duburcqa/jiminy/data/bipedal_robots/atlas/meshes/drc_extremities_diffuse.png

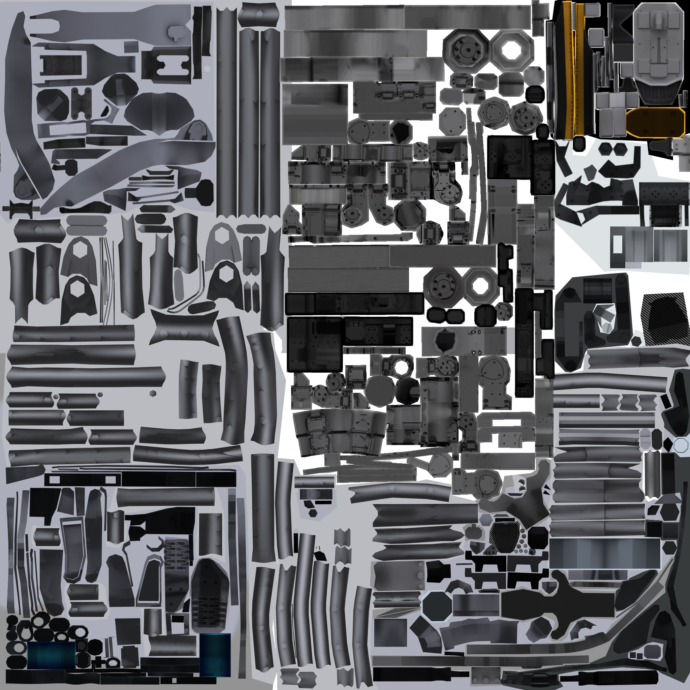
data/bipedal_robots/atlas/meshes/drc_extremities_diffuse.png
