duburcqa/jiminy/data/bipedal_robots/atlas/meshes/torso_diffuse_unplugged.png

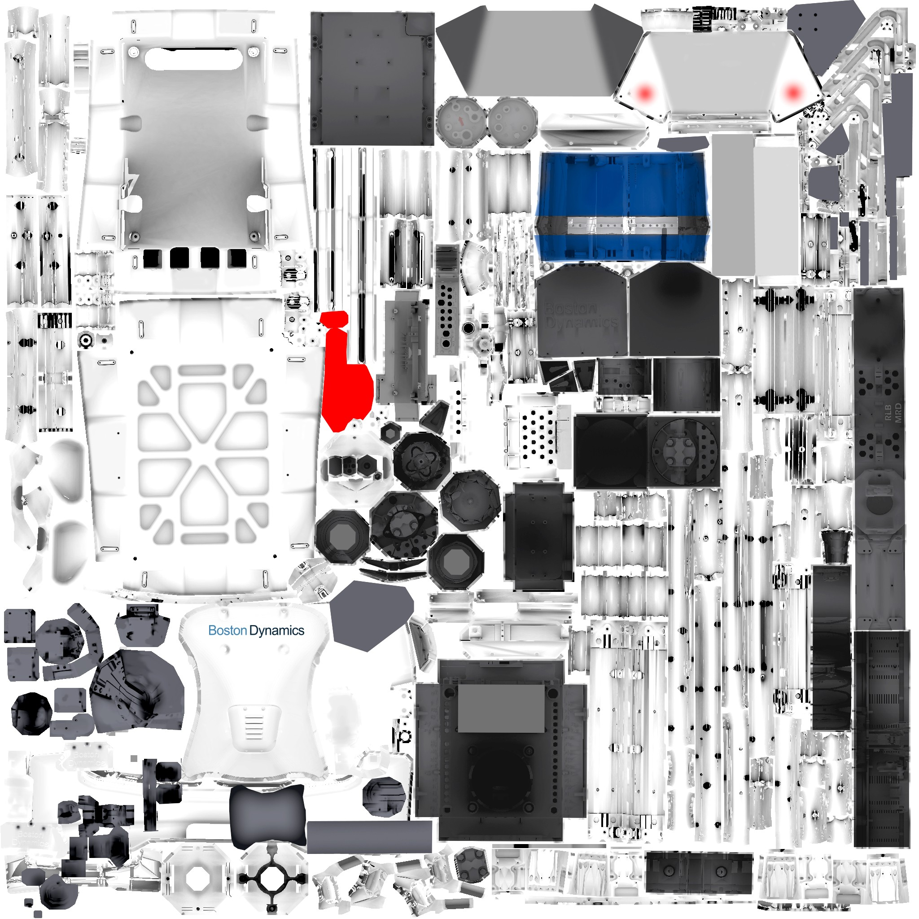
data/bipedal_robots/atlas/meshes/torso_diffuse_unplugged.png
