duburcqa/jiminy/README.md

<div align="center">
  
</div>

____












Jiminy is a cross-platform open-source simulator for poly-articulated systems. It was built with two ideas in mind:

- **provide a fast yet physically accurate simulator for robotics research.**

Jiminy is built around [Pinocchio](https://github.com/stack-of-tasks/pinocchio), an open-source fast and efficient kinematics and dynamics library. Jiminy thus uses minimal coordinates and Lagrangian dynamics to simulate an articulated system: this makes Jiminy as close as numerically possible to an analytical solution, without the risk of joint violation.

- **build an efficient and flexible platform for machine learning in robotics.**

Beside a strong focus on performance to answer machine learning's need for running computationally demanding distributed simulations, Jiminy offers convenience tools for learning via a dedicated module [Gym-Jiminy](#gym-jiminy). It is fully compliant with `gym` standard API and provides a highly customizable wrapper to interface any robotics system with state-of-the-art learning frameworks.

## Key features

### General

- Simulation of multi-body systems using **minimal coordinates and Lagrangian dynamics**.
- Comprehensive API for computing dynamic quantities and their derivatives thanks to Pinocchio.
- C++ core with full python bindings, providing user API parity between both languages.
- Designed with machine learning in mind, with seamless wrapping of robots as [OpenAI Gym](https://github.com/openai/gym) environments using one-liners. Jiminy provides both the physical engine and the robot model (including sensors) required for learning.
- **Fully modular learning environment pipeline design**, with plug-and-play robotic observers and controllers, but also composable reward components and termination conditions. See example [here](./python/gym_jiminy/unit_py/data/anymal_pipeline.toml).
- Rich simulation log output, easily customizable for recording, introspection and debugging. The simulation log is made available in RAM directly for fast access, and can be exported in binary or [HDF5](./docs/spec/src/tlmc_format_specification.md) format.
- Dedicated integration in Google Colab, Jupyter Lab, Mybinder and VSCode working out-of-the-box - including interactive 3D viewer based on [Meshcat](https://github.com/rdeits/MeshCat.jl). This facilitates working on remote environments.
- Synchronous and single-threaded offscreen rendering capability, GPU-accelerated without graphical server, based on [Panda3d](https://github.com/panda3d/panda3d).
- Easy to install: `pip` is all that is needed to [get you started](#getting-started) ! Support Linux, Mac and Windows platforms.

### Physics

- Provide both classical phenomenological force-level spring-damper contact model and constraint solver satisfying the maximum energy dissipation principle.
- Support contact and collision with the ground from a fixed set of contact points (primitives and meshes yet to come).
- Simulate multiple articulated systems simultaneously interacting with each other, to support use cases such as multi-agent learning or swarm robotics.
- Modeling of motor transmission backlash and structural deformation via compliant spherical joints with spring-damper dynamics, which are common phenomena, particularly in bipedal robotics.
- Simulate both continuous or discrete-time controller, with possibly different controller and sensor update frequencies.

A more complete list of features is available on the [wiki](https://github.com/duburcqa/jiminy/wiki).

**The documentation is available on [Github.io](https://duburcqa.github.io/jiminy/), or locally in `docs/html/index.html` if built from source.**

## Gym Jiminy

Gym Jiminy is an interface between Jiminy simulator and reinforcement learning frameworks. It is fully compliant with now standard [Open AI Gym](https://github.com/openai/gym) API. Additionally, it offers a generic and easily configurable learning environment for learning locomotion tasks, with minimal intervention from the user, who usually only needs to provide the robot's [URDF](https://wiki.ros.org/urdf) file. Furthermore, Gym Jiminy enables easy modification of many aspects of the simulation to provide richer exploration and ensure robust learning. This ranges from external perturbation forces to sensor noise and bias, including randomization of masses and inertias, ground friction model or even gravity itself. Note that learning can
easily be done on any high-level dynamics features, or restricted to mock sensor data for end-to-end learning.

Gym is cross-platform and compatible with most Reinforcement Learning frameworks implementing standard algorithms. For instance, [Stable Baselines 3](https://github.com/DLR-RM/stable-baselines3), [Tianshou](https://github.com/thu-ml/tianshou), or [Rllib](https://github.com/ray-project/ray). Stable Baselines 3 and Tianshou use its counterpart [Pytorch](https://pytorch.org/), and Rllib supports both. A few learning examples relying on those packages are also provided.

Pre-configured environments for some well-known toys models and reference robotics platforms are provided: [cartpole](https://www.gymlibrary.dev/environments/classic_control/cart_pole/), [acrobot](https://www.gymlibrary.dev/environments/classic_control/acrobot/), [pendulum](https://www.gymlibrary.dev/environments/classic_control/pendulum/), [Ant](https://www.gymlibrary.dev/environments/mujoco/ant/), [ANYmal](https://www.anymal-research.org/#getting-started), and [Cassie](https://www.agilityrobotics.com/robots#cassie), and [Atlas](https://www.bostondynamics.com/atlas).

## Demo

<a href="./python/jiminy_py/examples/tutorial.ipynb">
<p align="middle">
  
  
  
  
  
  
</p>
</a>

## Getting started

Jiminy and Gym Jiminy support Linux, Mac and Windows, and is compatible with Python3.10+. Pre-compiled binaries are distributed on PyPi. They can be installed using `pip>=20.3`:

```bash
# For installing Jiminy
python -m pip install --prefer-binary jiminy_py[meshcat,plot]

# For installing Gym Jiminy
python -m pip install --prefer-binary gym_jiminy[all]
```

Detailed installation instructions, including building from source, are available [here](./INSTALL.md).
