duburcqa/jiminy/docs/api/jiminy/index.rst

Jiminy C++ API
==============

.. toctree::
   :maxdepth: 1

   robot
   constraints
   sensors
   motors
   controller
   engine
   utilities
