duburcqa/jiminy/docs/api/jiminy/motors.rst

motors
======

.. doxygenclass:: jiminy::AbstractMotorBase
   :project: jiminy
   :members:
   :undoc-members:

.. doxygenclass:: jiminy::SimpleMotor
   :project: jiminy
   :members:
   :undoc-members:
