duburcqa/jiminy/docs/api/jiminy_py/core/engine.rst

engine
======

.. autoclass:: jiminy_py.core.ProfileForce
   :members:
   :undoc-members:
   :show-inheritance:

.. autoclass:: jiminy_py.core.ImpulseForce
   :members:
   :undoc-members:
   :show-inheritance:

.. autoclass:: jiminy_py.core.CouplingForce
   :members:
   :undoc-members:
   :show-inheritance:

.. autoclass:: jiminy_py.core.Engine
   :members:
   :undoc-members:
   :show-inheritance:

.. autoclass:: jiminy_py.core.StepperState
   :members:
   :undoc-members:
   :show-inheritance:

.. autoclass:: jiminy_py.core.RobotState
   :members:
   :undoc-members:
   :show-inheritance:
