duburcqa/jiminy/docs/api/jiminy_py/core/index.rst

core
====

.. toctree::
   :maxdepth: 1

   robot
   constraints
   sensors
   motors
   controller
   engine
   utilities
