duburcqa/jiminy/docs/api/jiminy_py/core/sensors.rst

sensors
=======

.. autoclass:: jiminy_py.core.AbstractSensor
   :members:
   :undoc-members:
   :show-inheritance:

.. autoclass:: jiminy_py.core.ImuSensor
   :members:
   :undoc-members:
   :show-inheritance:

.. autoclass:: jiminy_py.core.ContactSensor
   :members:
   :undoc-members:
   :show-inheritance:

.. autoclass:: jiminy_py.core.ForceSensor
   :members:
   :undoc-members:
   :show-inheritance:

.. autoclass:: jiminy_py.core.EncoderSensor
   :members:
   :undoc-members:
   :show-inheritance:

.. autoclass:: jiminy_py.core.EffortSensor
   :members:
   :undoc-members:
   :show-inheritance:

.. autoclass:: jiminy_py.core.SensorMeasurementTree
   :members:
   :undoc-members:
   :show-inheritance:
