duburcqa/jiminy/docs/api/jiminy_py/core/motors.rst

motors
======

.. autoclass:: jiminy_py.core.AbstractMotor
   :members:
   :undoc-members:
   :show-inheritance:

.. autoclass:: jiminy_py.core.SimpleMotor
   :members:
   :undoc-members:
   :show-inheritance:
