duburcqa/jiminy/docs/api/gym_jiminy/common/blocks/index.rst

Blocks
======

.. toctree::
   :maxdepth: 1

   proportional_derivative_controller
   motor_safety_limit
   mahony_filter
   body_orientation_observer
   deformation_estimator
   quantity_observer
