duburcqa/jiminy/docs/api/gym_jiminy/common/blocks/mahony_filter.rst

Mahony Filter
=============

.. automodule:: gym_jiminy.common.blocks.mahony_filter
   :members:
   :undoc-members:
   :show-inheritance:
