duburcqa/jiminy/docs/api/gym_jiminy/common/blocks/motor_safety_limit.rst

Motor Safety Limit
==================

.. automodule:: gym_jiminy.common.blocks.motor_safety_limit
   :members:
   :show-inheritance:
