duburcqa/jiminy/docs/api/gym_jiminy/common/wrappers/observation_filter.rst

Observation Filtering
=====================

.. automodule:: gym_jiminy.common.wrappers.observation_filter
   :members:
   :show-inheritance:
