duburcqa/jiminy/docs/api/gym_jiminy/common/wrappers/observation_stack.rst

Observation Frame Stacking
==========================

.. automodule:: gym_jiminy.common.wrappers.observation_stack
   :members:
   :show-inheritance:
