duburcqa/jiminy/docs/api/gym_jiminy/common/controllers/pid_controller.rst

PID Controller
==============

.. automodule:: gym_jiminy.common.controllers.pid_controller
   :members:
   :undoc-members:
   :private-members:
   :inherited-members:
   :show-inheritance:
