duburcqa/jiminy/docs/spec/pdf/note_on_flexibilty_model.pdf

## A note on the model used by Jiminy to simulate exibilities

Matthieu Vigne

25th March 2020

Jiminy supports the addition of joint exibilities to an otherwise rigid model, as well as rotor inertia. The goal of this document is to clarify how this is performed internally, and why this is justied.
The exible joint model supported by Jiminy consists of a simple spring damper. The corresponding system, displayed in Figure 1a, consists in placing, between a rotor of equivalent inertia J and the output body, of inertia I, a spring-damper of stiness k and damping ν. We call u the motor torque, and fext the external forces applied on the output body. Note that the gure is done on a prismatic joint for simplicity only: in practice, exibilites are rotations meant to be applied onto revolute axes - but the equations are the same between both systems.

Rotor
J

Body
I
x1 | x2
u | fext

Flexibility: k, ν

(a) Representation of a exible joint (prismatic): a spring-damper is placed between the rotor and the output body
Flexible mass
If

Body
I
x2 | x1

fext

Flexibility: k, ν | Prismatic joint, uo
(b) The system actually being simulated by Jiminy: an extra mass is added to attach the spring. uo is the torque at the output of the transmission, and is equal to u−Jx¨2.

Figure 1: A representation, for prismatic joints, of both systems under study.

However, such system cannot be easily represented in pinocchio: indeed, pinocchio implements rigid body dynamics as having a set of joints connecting rigid bodies: as such, it has no notion of transmission per se. The rotor does not correspond to a physical part of inertia J (the armature inertia, J, is computed for simple transmission by multiplying the real inertia by the square of the reduction ratio) - thus, rotor inertia is implemented in Jiminy by modifying the corresponding diagonal term of the generalized inertia matrix (note that this approach works for simple, 1DoF joints, but is not generic). As such, it is no

1

possible to add a degree of freedom to place the spring between the rotor and the output, as in the case in Figure 1a.
Instead, the exibility is placed before rotor of the exible joint being simulated. Since each joint must be connected to a body, this requires the addition of an extra body, connected to the exibility: this body has its own inertia, If . In practice we will want If close to zero, to avoid modifying the dynamical properties of the overall system. The resulting system is shown in Figure 1b We now need to show that both systems are indeed equivalent, when taking the limit If → 0. Consider the rst, SEA system: applying Newton's law of motion to the rotor, then the output body, yields:
(
Jx¨2 = u + kx1 + νx˙ 1
I(¨x1 + ¨x2) = −kx1 − νx˙ 1 + fext

(1)

which equivalently writes:
(
I(¨x1 + ¨x2) = −kx1 − νx˙ 1 + fext I(¨x1 + ¨x2) + Jx¨2 = u + fext

(2)

The system simulated by Jiminy writes in turn:
(
Ifx¨1 = −kx1 − νx˙ 1 − uo
I(¨x1 + ¨x2) = uo + fext

(3)

where uo is the torque at the output of the transmission. Applying Euler's law to the rotor gives us: Jx¨2 = u − uo. Thus, (3) rewrites:
(
Ifx¨1 = −kx1 − νx˙ 1 − (u − Jx¨2) I(¨x1 + ¨x2) = u − Jx¨2 + fext

(4)

add by adding both lines, we obtain:
(
(I + If )¨x1 + Ix¨2 = −kx1 − νx˙ 1 + fext I(¨x1 + ¨x2) + Jx¨2 = u + fext

(5)

Thus, from (2) and (5), it is now clear that both systems are equivalent when If << I. So while Jiminy does not exactly simulates a SEA as depicted in Figure 1a, it remains suciently close, in practice and for reasonable values of the output inertia I, to this system.

2
