duburcqa/jiminy/data/bipedal_robots/atlas/meshes/drc_torso_head_diffuse.png

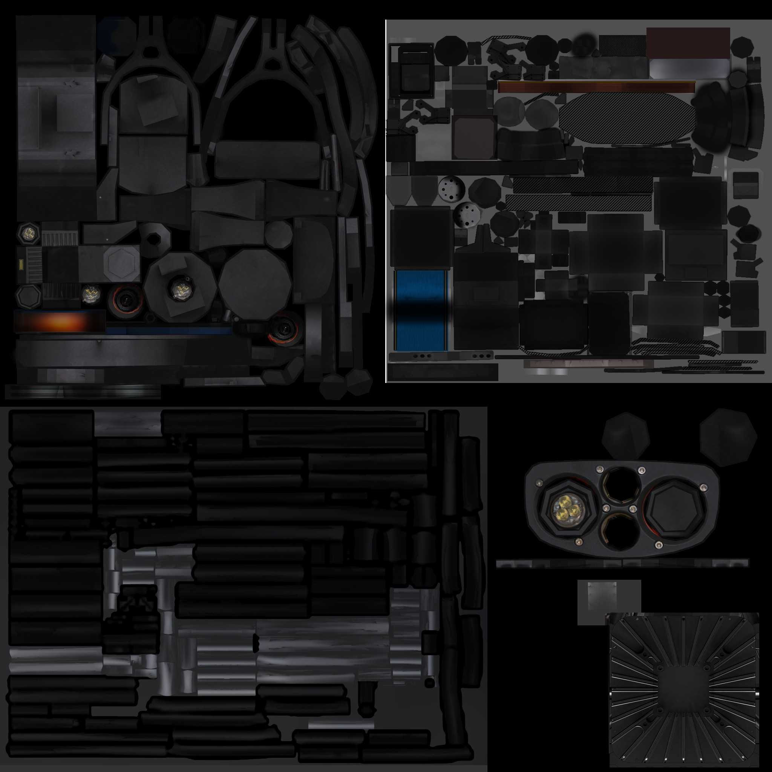
data/bipedal_robots/atlas/meshes/drc_torso_head_diffuse.png
