duburcqa/jiminy/data/bipedal_robots/atlas/meshes/extremities_diffuse_unplugged.png

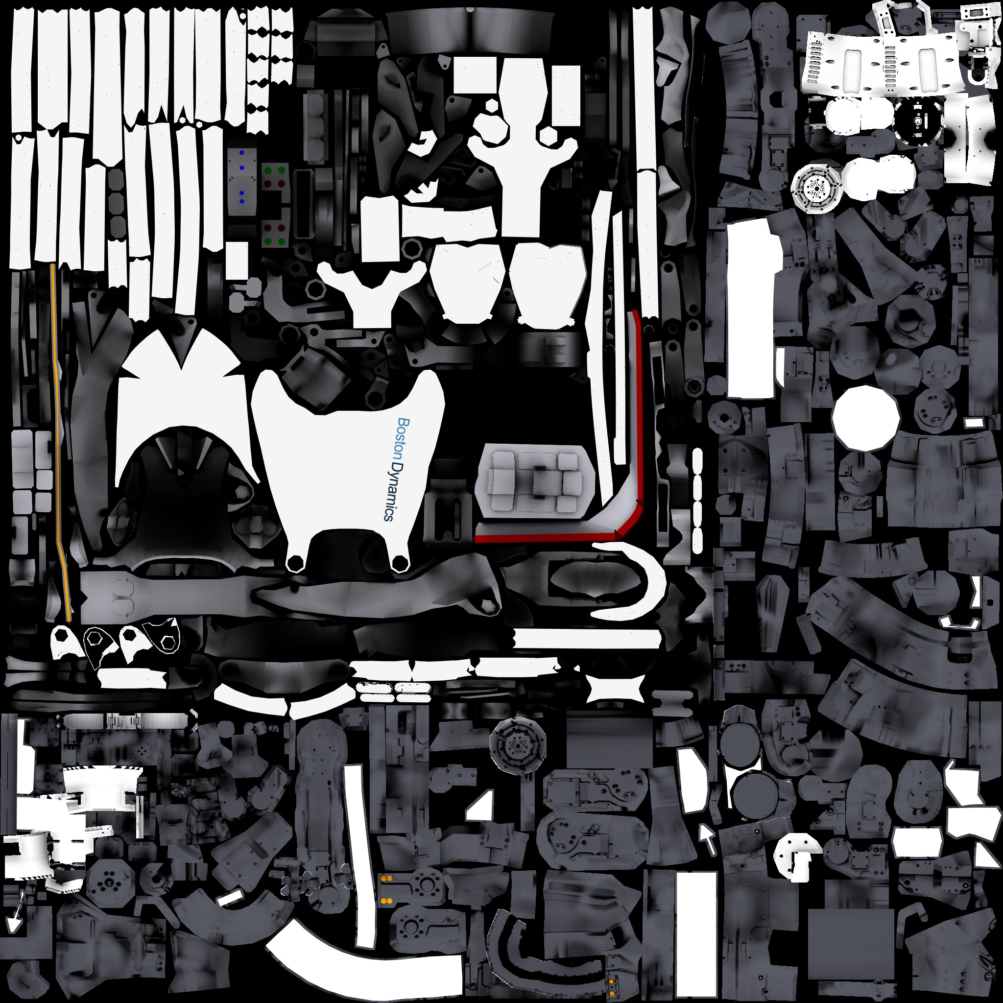
data/bipedal_robots/atlas/meshes/extremities_diffuse_unplugged.png
