duburcqa/jiminy/data/bipedal_robots/atlas/meshes/right_leg_diffuse_unplugged.png

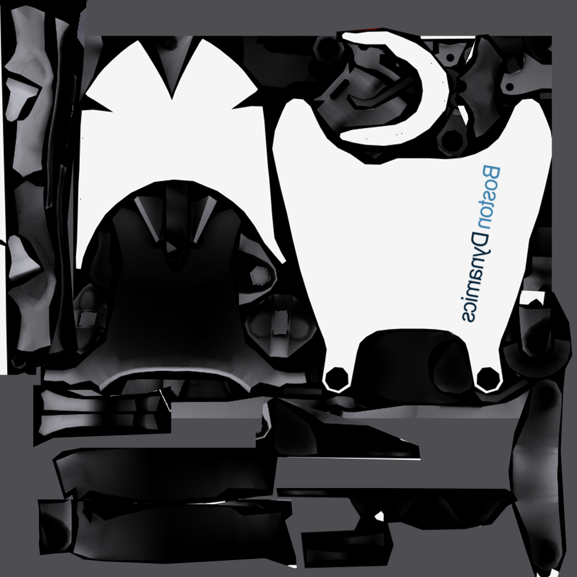
data/bipedal_robots/atlas/meshes/right_leg_diffuse_unplugged.png
