duburcqa/jiminy/data/bipedal_robots/atlas/meshes/torso_diffuse.png

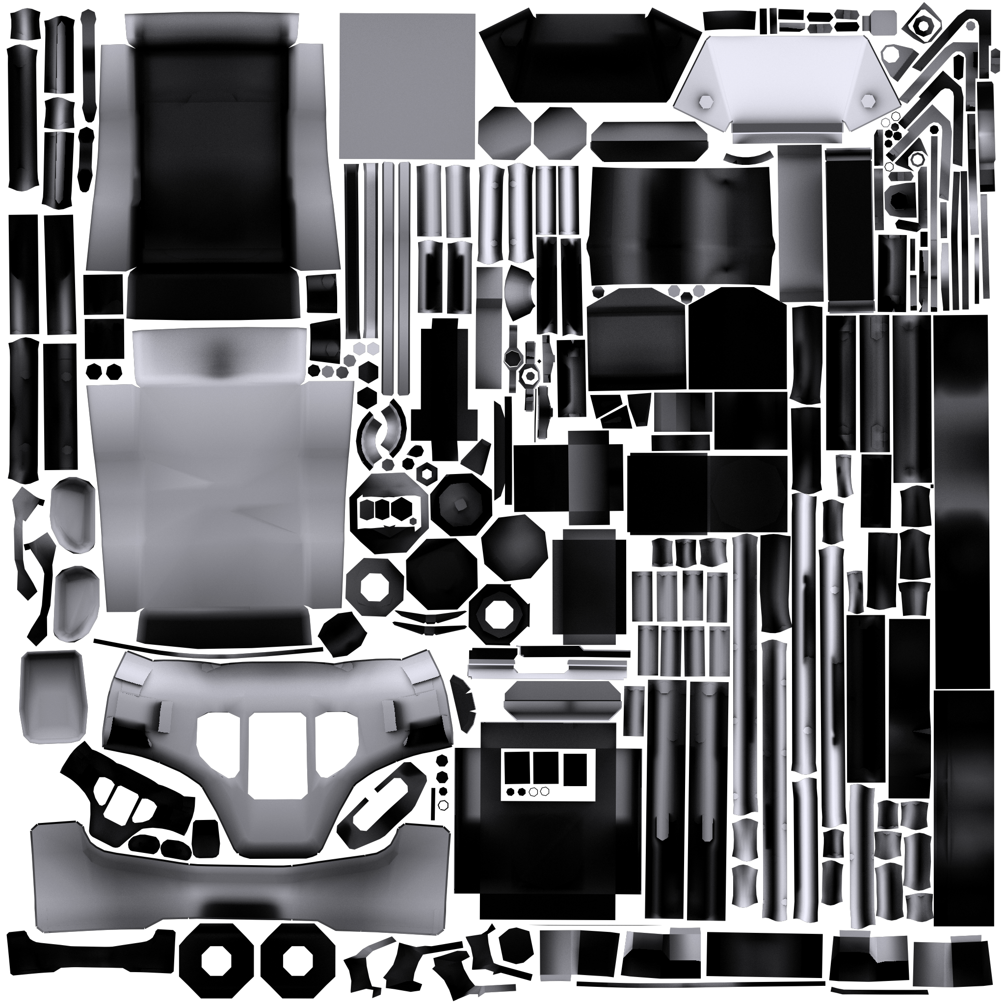
data/bipedal_robots/atlas/meshes/torso_diffuse.png
