duburcqa/jiminy/python/gym_jiminy/unit_py/data/atlas_standing_0.png

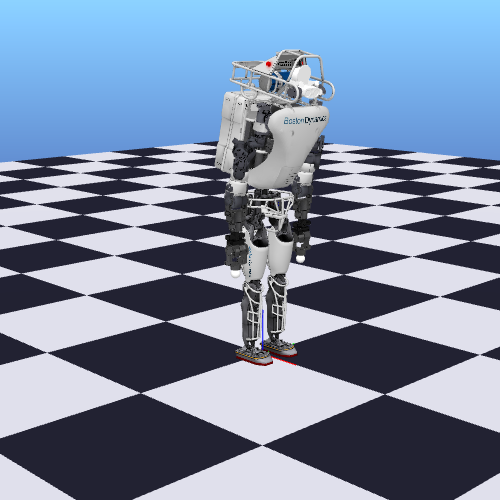
python/gym_jiminy/unit_py/data/atlas_standing_0.png
