duburcqa/jiminy/python/gym_jiminy/unit_py/data/atlas_standing_1.png

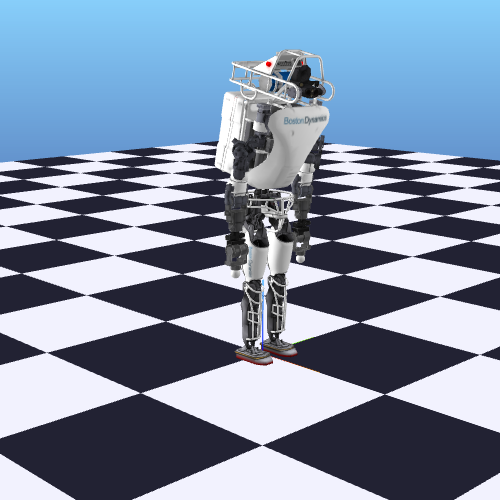
python/gym_jiminy/unit_py/data/atlas_standing_1.png
