duburcqa/jiminy/python/gym_jiminy/unit_py/data/cassie_standing_0.png

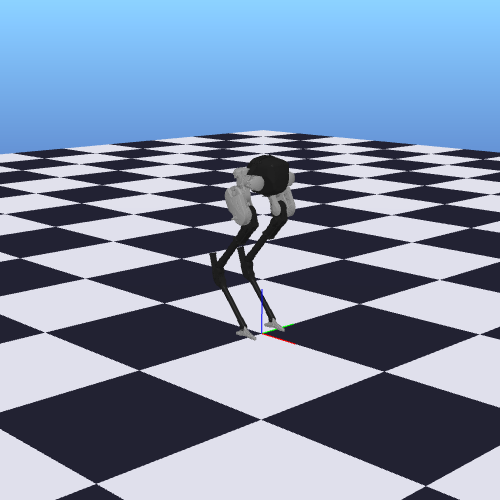
python/gym_jiminy/unit_py/data/cassie_standing_0.png
