duburcqa/jiminy/python/gym_jiminy/unit_py/data/digit_standing_0.png

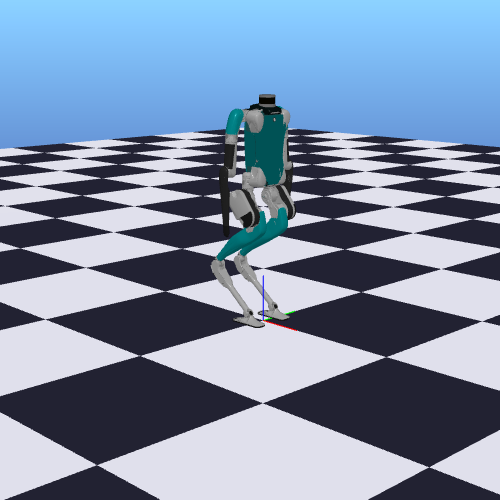
python/gym_jiminy/unit_py/data/digit_standing_0.png
