duburcqa/jiminy/data/bipedal_robots/cassie/meshes/toe.stl

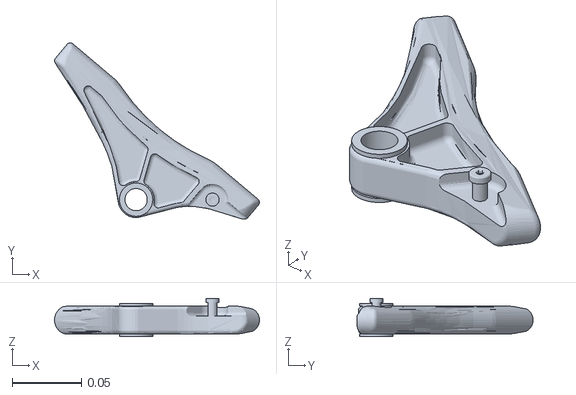
[picture p13: CAD file, 2021-03-16]
data/bipedal_robots/cassie/meshes/toe.stl
0.148 x 0.127 x 0.0277
