duburcqa/jiminy/data/bipedal_robots/digit/meshes/shin.obj

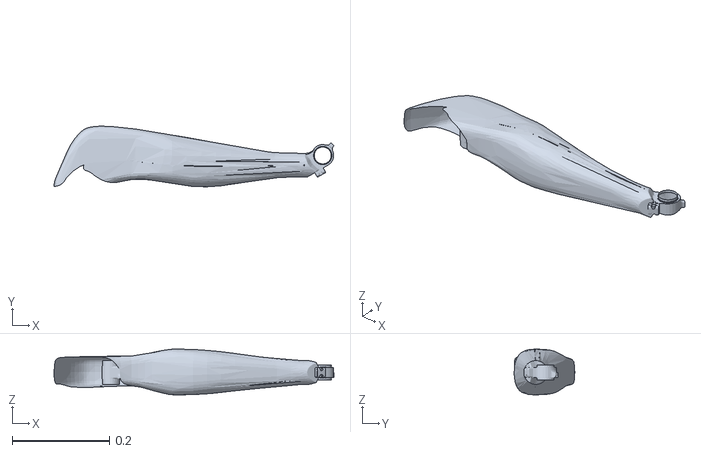
[picture p14: CAD file, 2024-01-02]
data/bipedal_robots/digit/meshes/shin.obj
0.575 x 0.125 x 0.0939
