duburcqa/jiminy/python/jiminy_py/unit_py/data/box.STL

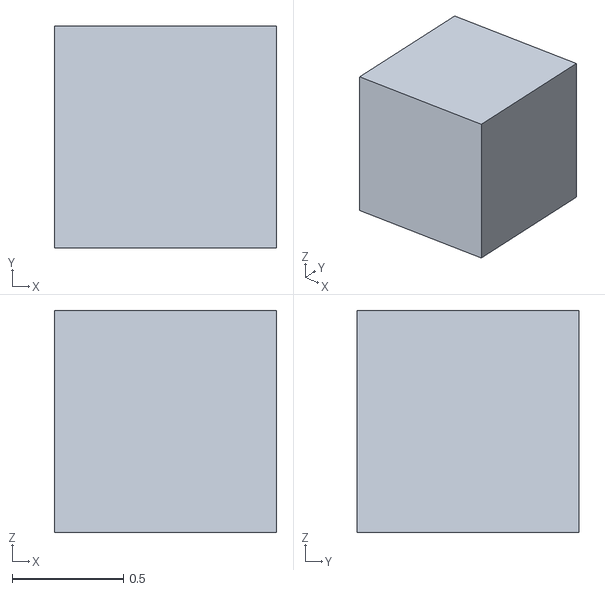
[picture p15: CAD file, 2020-10-11]
python/jiminy_py/unit_py/data/box.STL
1.00 x 1.00 x 1.00
