duburcqa/jiminy/data/bipedal_robots/cassie/meshes/tarsus_mirror.stl

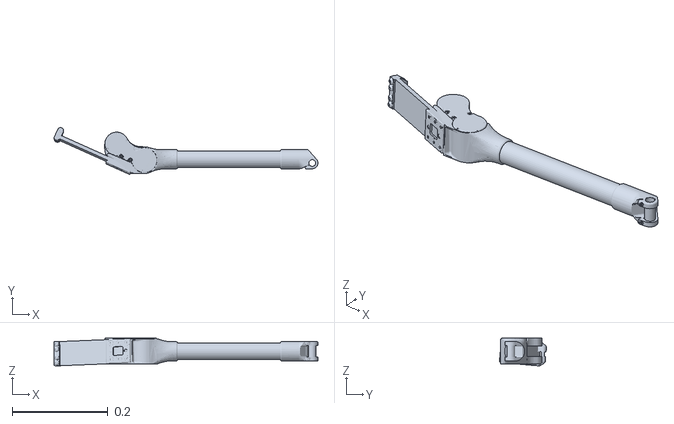
[picture p16: CAD file, 2021-03-16]
data/bipedal_robots/cassie/meshes/tarsus_mirror.stl
0.551 x 0.098 x 0.0581
