duburcqa/jiminy/data/bipedal_robots/digit/meshes/hip-pitch-housing.obj

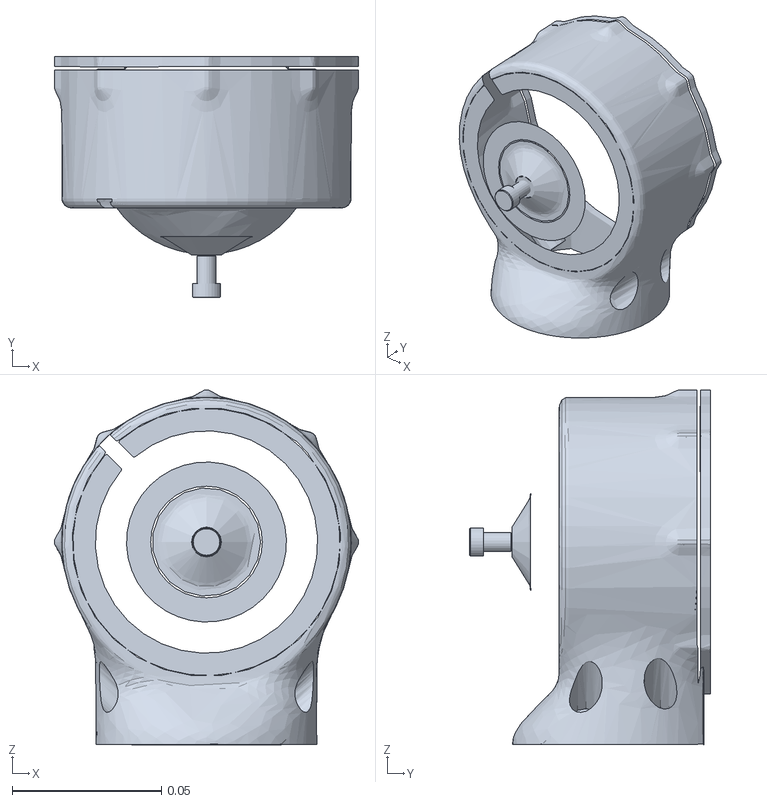
[picture p17: CAD file, 2024-01-02]
data/bipedal_robots/digit/meshes/hip-pitch-housing.obj
0.102 x 0.0808 x 0.119
