duburcqa/jiminy/data/bipedal_robots/cassie/meshes/thigh.stl

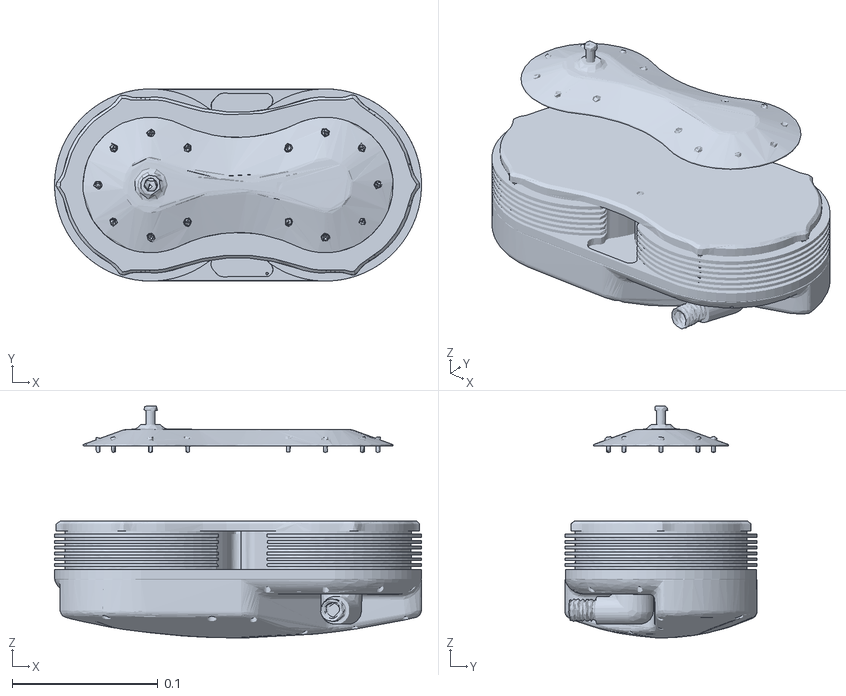
[picture p18: CAD file, 2021-03-16]
data/bipedal_robots/cassie/meshes/thigh.stl
0.252 x 0.132 x 0.159
