duburcqa/jiminy/data/bipedal_robots/digit/meshes/arm-L1.obj

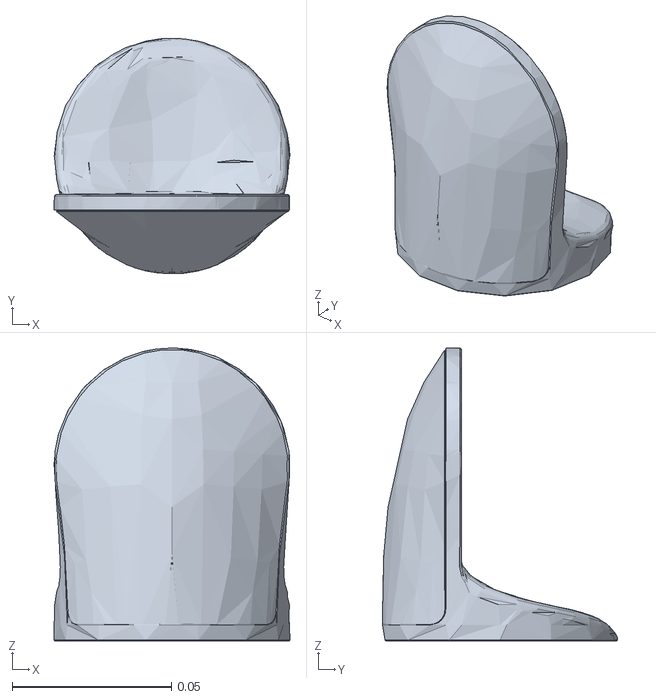
[picture p19: CAD file, 2024-01-02]
data/bipedal_robots/digit/meshes/arm-L1.obj
0.074 x 0.0739 x 0.092
