duburcqa/jiminy/data/bipedal_robots/cassie/meshes/pelvis.stl

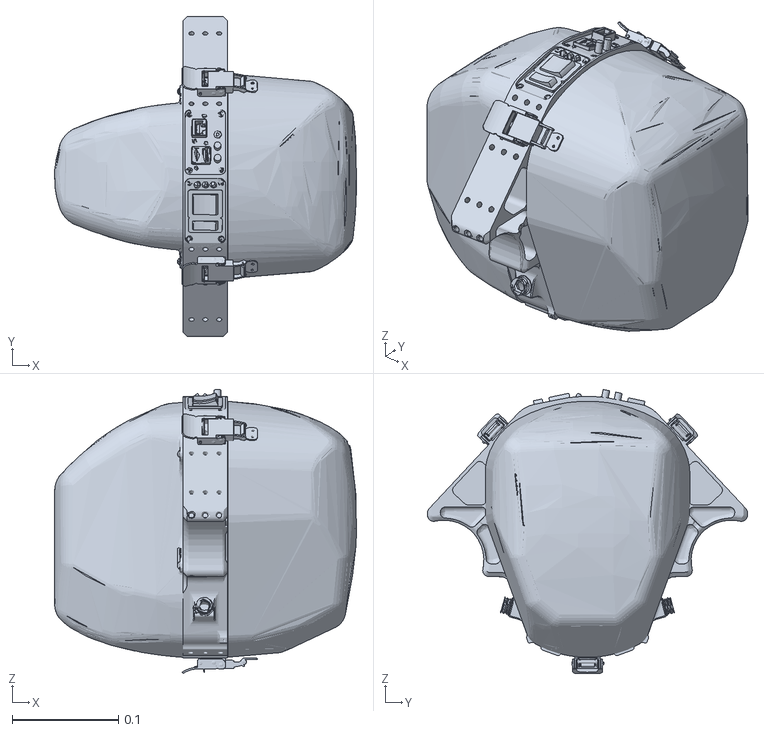
[picture p20: CAD file, 2021-03-16]
data/bipedal_robots/cassie/meshes/pelvis.stl
0.284 x 0.301 x 0.267
