duburcqa/jiminy/data/bipedal_robots/digit/meshes/torso.obj

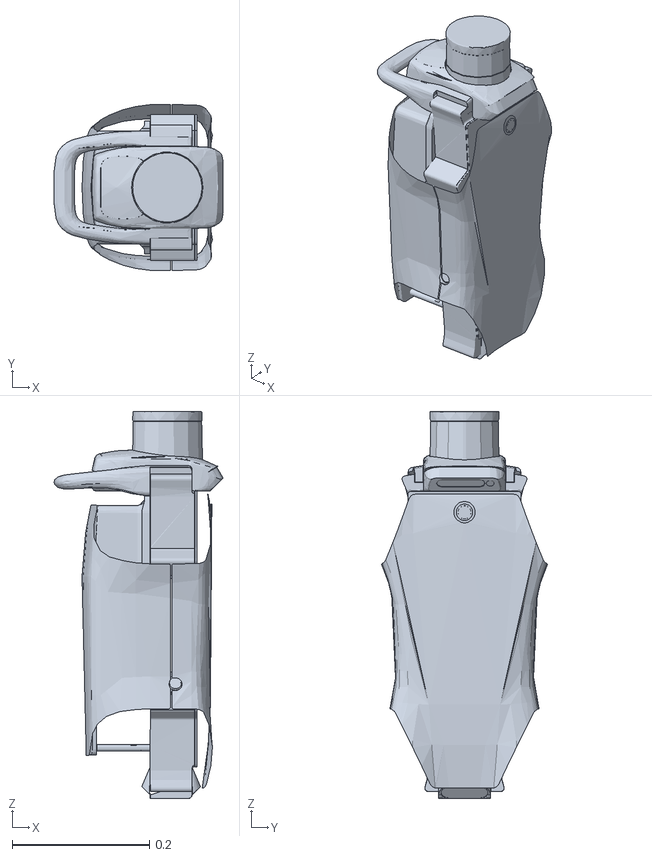
[picture p21: CAD file, 2024-01-02]
data/bipedal_robots/digit/meshes/torso.obj
0.246 x 0.242 x 0.564
