duburcqa/jiminy/data/bipedal_robots/cassie/meshes/hip.stl

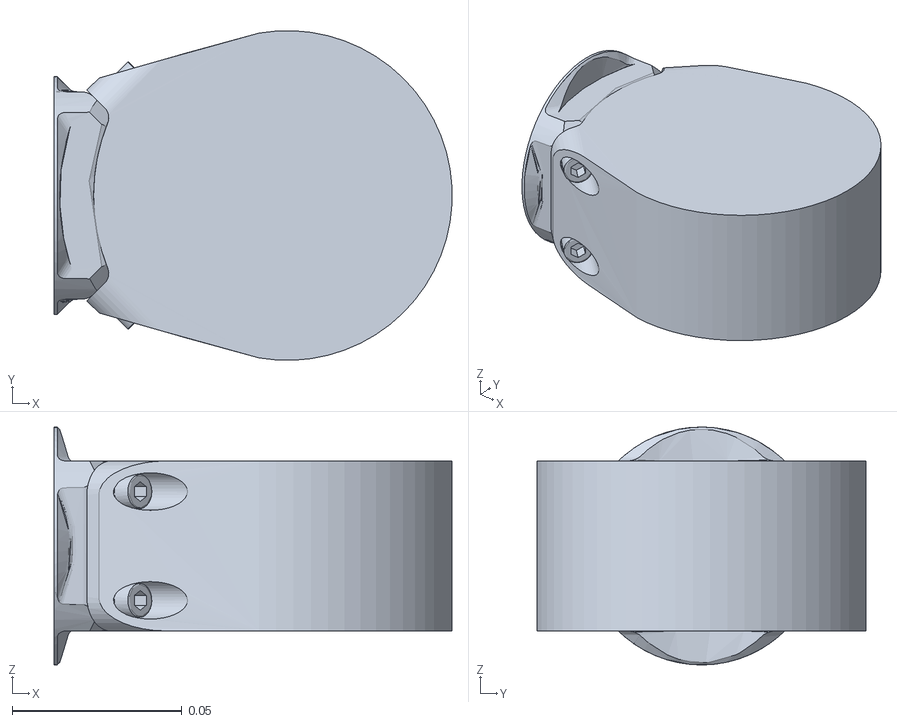
[picture p22: CAD file, 2021-03-16]
data/bipedal_robots/cassie/meshes/hip.stl
0.117 x 0.0969 x 0.07
