duburcqa/jiminy/data/bipedal_robots/digit/meshes/arm-L4.obj

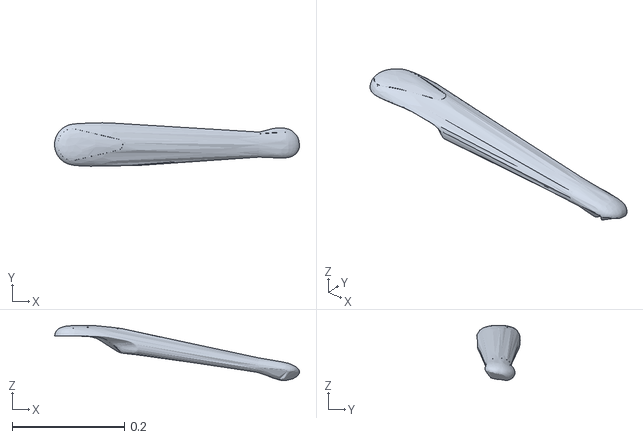
[picture p23: CAD file, 2024-01-02]
data/bipedal_robots/digit/meshes/arm-L4.obj
0.437 x 0.0776 x 0.0983
