duburcqa/jiminy/data/bipedal_robots/cassie/meshes/plantar-rod.stl

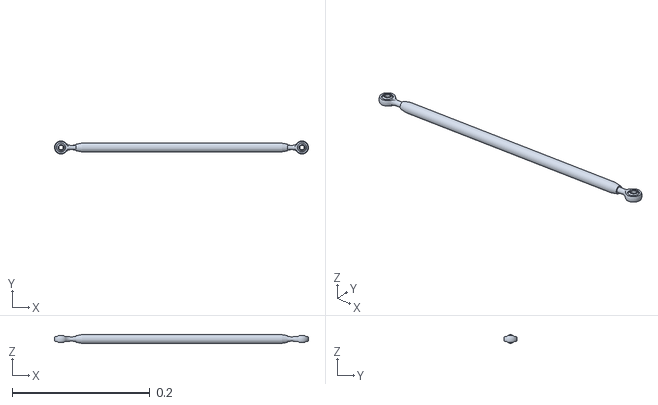
[picture p24: CAD file, 2021-03-16]
data/bipedal_robots/cassie/meshes/plantar-rod.stl
0.369 x 0.019 x 0.0127
