duburcqa/jiminy/data/bipedal_robots/digit/meshes/arm-L3.obj

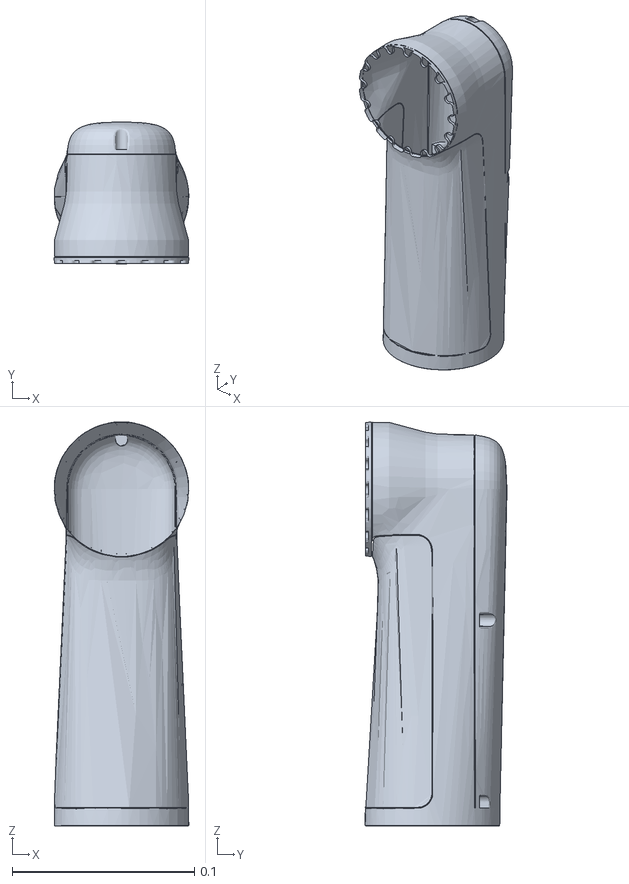
[picture p25: CAD file, 2024-01-02]
data/bipedal_robots/digit/meshes/arm-L3.obj
0.074 x 0.078 x 0.222
