duburcqa/jiminy/data/bipedal_robots/digit/meshes/arm-L2.obj

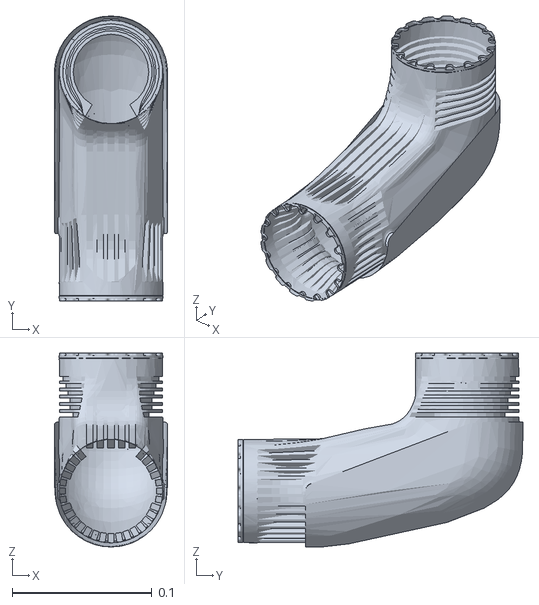
[picture p26: CAD file, 2024-01-02]
data/bipedal_robots/digit/meshes/arm-L2.obj
0.0808 x 0.204 x 0.139
