duburcqa/jiminy/data/bipedal_robots/digit/meshes/hip-pitch.obj

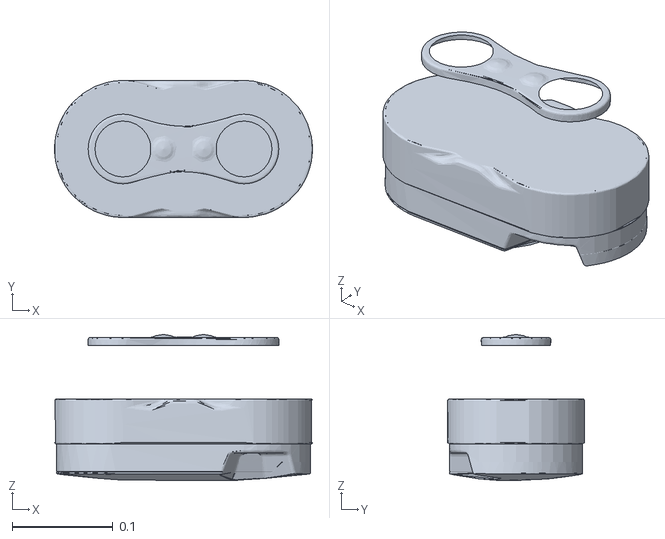
[picture p27: CAD file, 2024-01-02]
data/bipedal_robots/digit/meshes/hip-pitch.obj
0.256 x 0.136 x 0.145
