duburcqa/jiminy/data/bipedal_robots/cassie/meshes/achilles-rod.stl

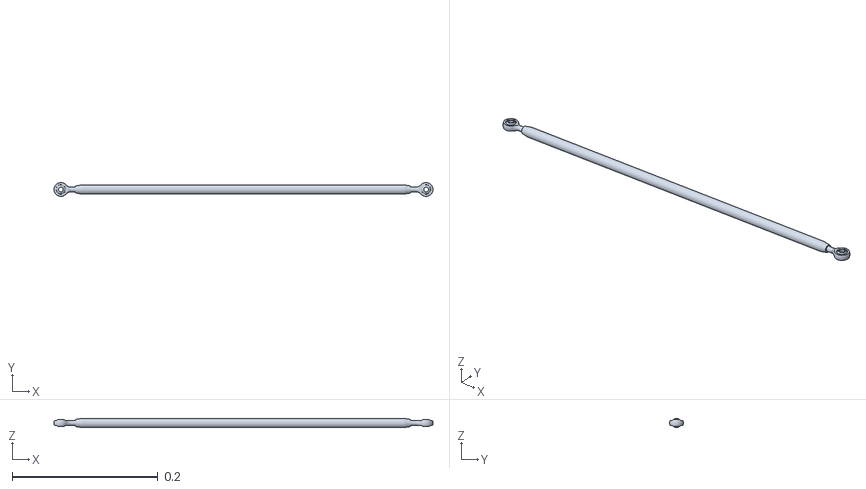
[picture p28: CAD file, 2021-03-16]
data/bipedal_robots/cassie/meshes/achilles-rod.stl
0.52 x 0.019 x 0.0127
