duburcqa/jiminy/data/bipedal_robots/digit/meshes/knee.obj

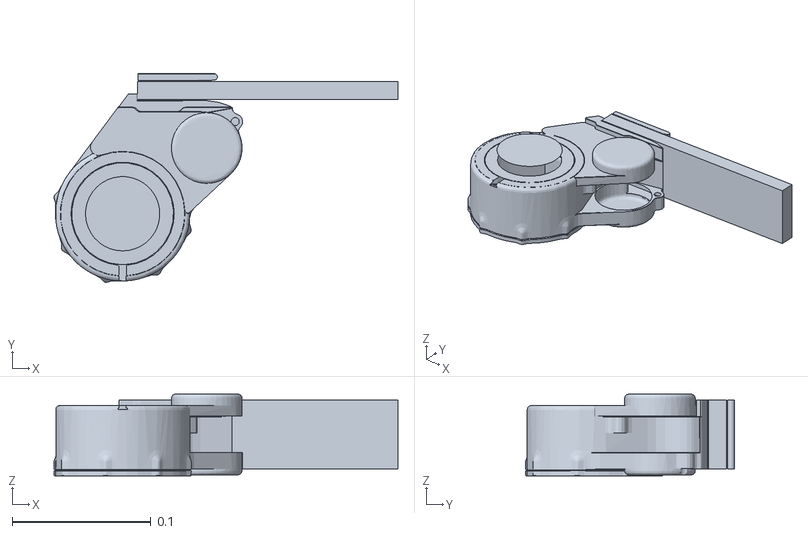
[picture p29: CAD file, 2024-01-02]
data/bipedal_robots/digit/meshes/knee.obj
0.248 x 0.151 x 0.0603
