duburcqa/jiminy/data/bipedal_robots/cassie/meshes/knee-output_mirror.stl

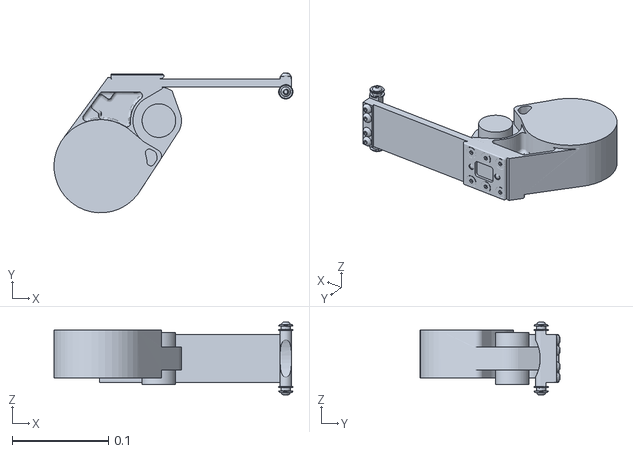
[picture p30: CAD file, 2021-03-16]
data/bipedal_robots/cassie/meshes/knee-output_mirror.stl
0.249 x 0.145 x 0.0756
