duburcqa/jiminy/data/bipedal_robots/digit/meshes/tarsus.obj

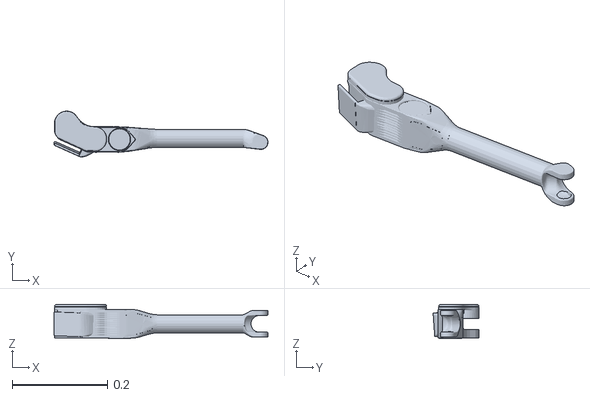
[picture p31: CAD file, 2024-01-02]
data/bipedal_robots/digit/meshes/tarsus.obj
0.45 x 0.0963 x 0.0716
