duburcqa/jiminy/data/bipedal_robots/cassie/meshes/shin-bone.stl

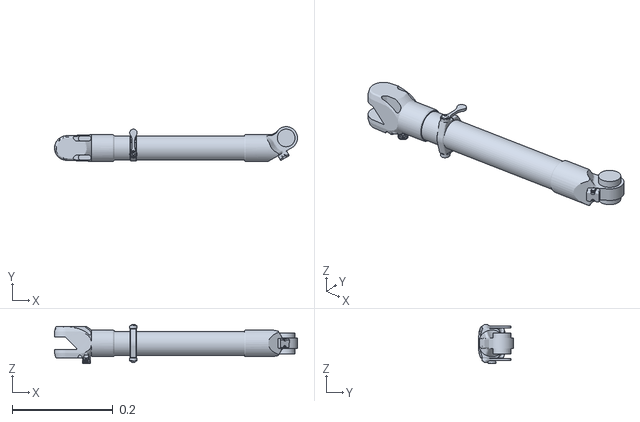
[picture p32: CAD file, 2021-03-16]
data/bipedal_robots/cassie/meshes/shin-bone.stl
0.482 x 0.069 x 0.0782
