duburcqa/jiminy/data/bipedal_robots/digit/meshes/toe-roll.obj

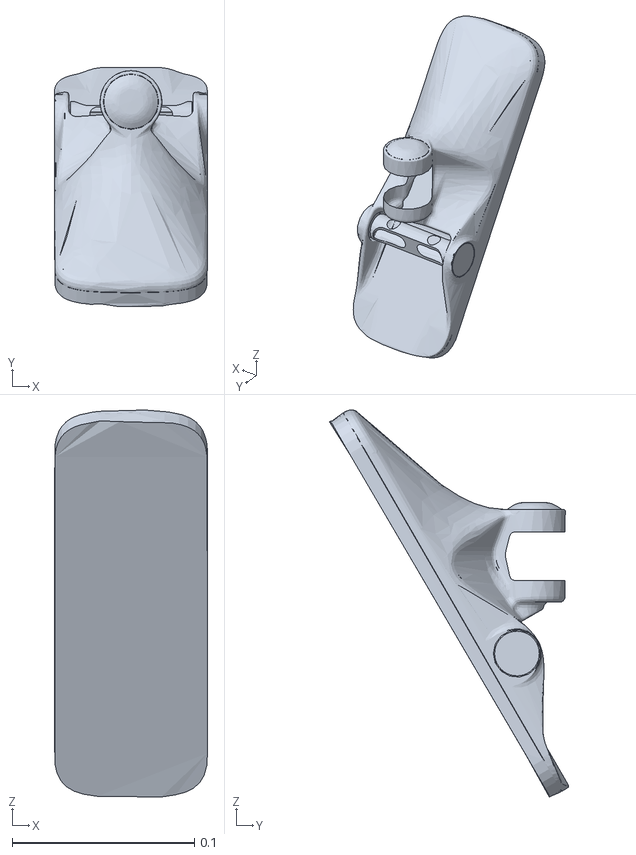
[picture p33: CAD file, 2024-01-02]
data/bipedal_robots/digit/meshes/toe-roll.obj
0.084 x 0.131 x 0.212
