duburcqa/jiminy/data/bipedal_robots/digit/meshes/hip-yaw-housing.obj

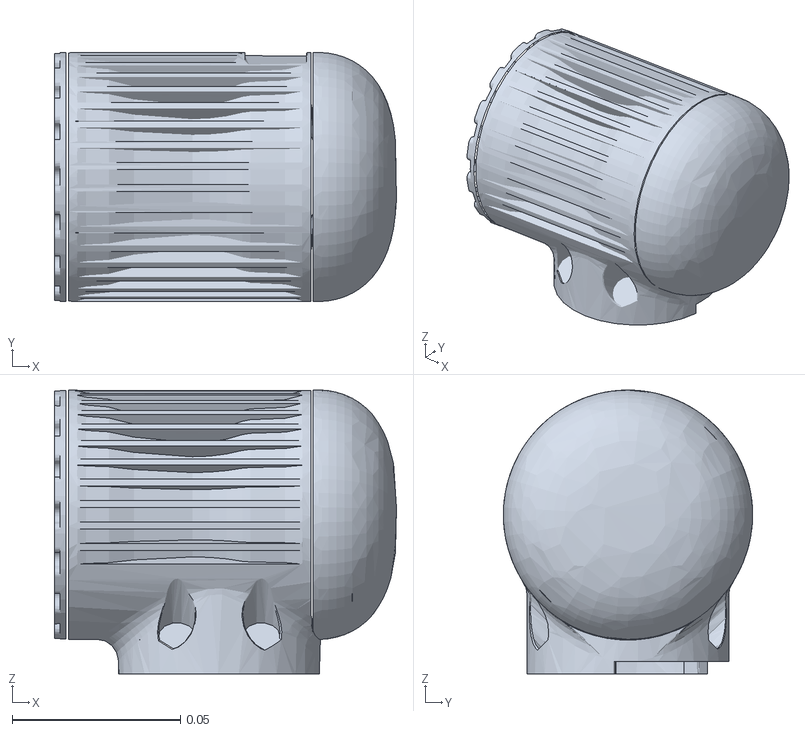
[picture p34: CAD file, 2024-01-02]
data/bipedal_robots/digit/meshes/hip-yaw-housing.obj
0.101 x 0.074 x 0.0842
