duburcqa/jiminy/data/bipedal_robots/cassie/meshes/abduction_mirror.stl

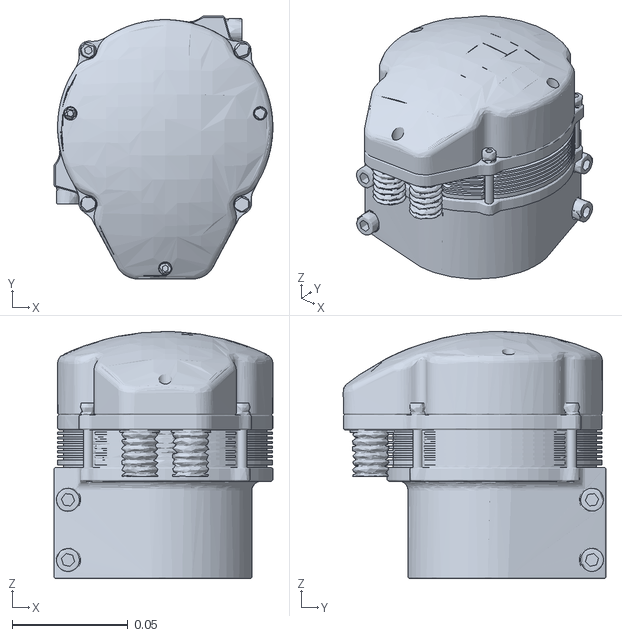
[picture p35: CAD file, 2021-03-16]
data/bipedal_robots/cassie/meshes/abduction_mirror.stl
0.0945 x 0.113 x 0.107
