duburcqa/jiminy/data/bipedal_robots/digit/meshes/toe-pitch.obj

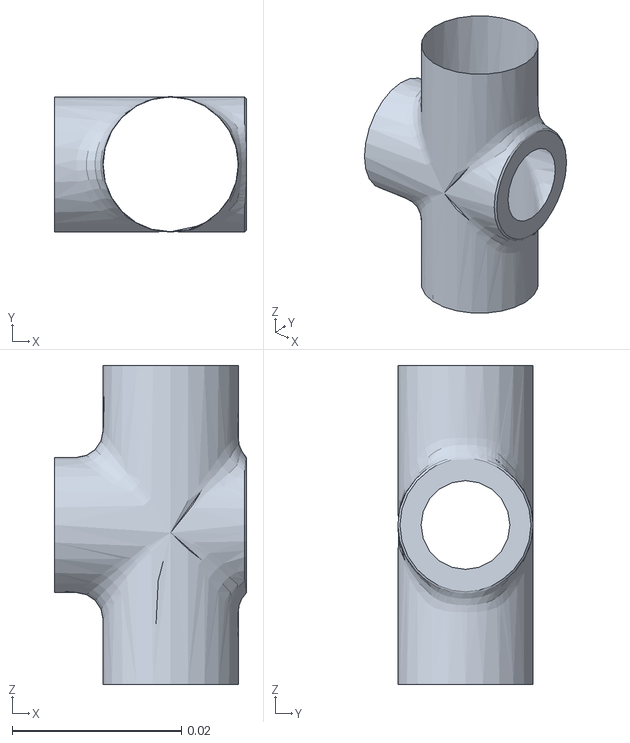
[picture p36: CAD file, 2024-01-02]
data/bipedal_robots/digit/meshes/toe-pitch.obj
0.0227 x 0.016 x 0.0377
