duburcqa/jiminy/data/bipedal_robots/digit/meshes/hip-roll-housing.obj

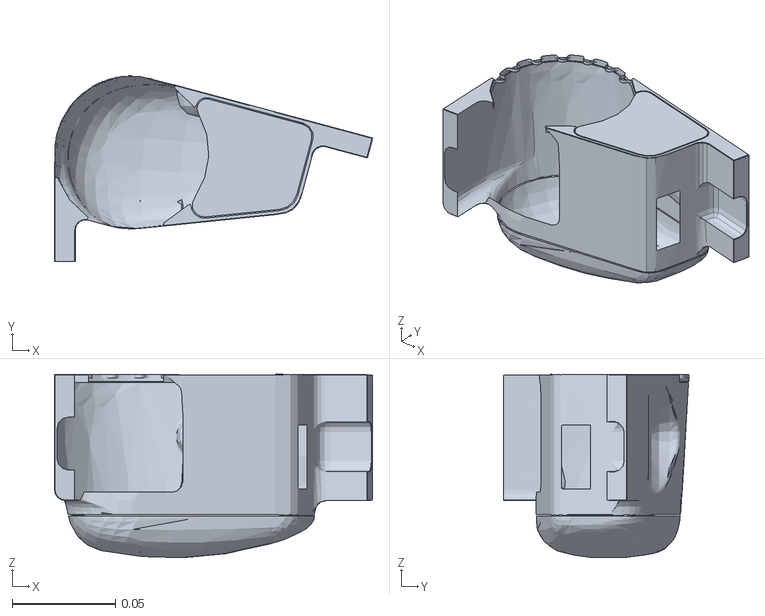
[picture p37: CAD file, 2024-01-02]
data/bipedal_robots/digit/meshes/hip-roll-housing.obj
0.154 x 0.09 x 0.0887
