duburcqa/jiminy/data/bipedal_robots/cassie/meshes/yaw.stl

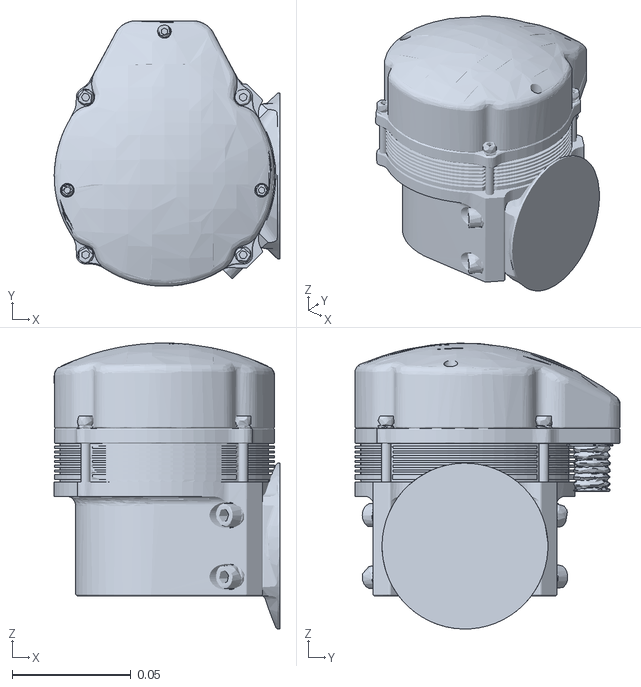
[picture p38: CAD file, 2021-03-16]
data/bipedal_robots/cassie/meshes/yaw.stl
0.0952 x 0.112 x 0.121
