duburcqa/jiminy/data/bipedal_robots/cassie/meshes/toe-output-crank.stl

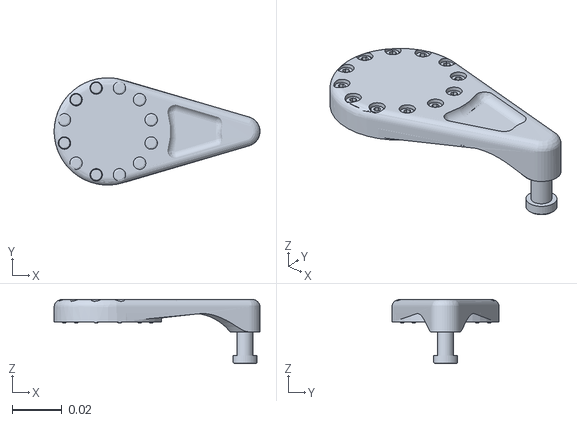
[picture p39: CAD file, 2021-03-16]
data/bipedal_robots/cassie/meshes/toe-output-crank.stl
0.0825 x 0.0431 x 0.0257
