duburcqa/jiminy/(list of files, cad)

Other CAD files:
data/bipedal_robots/cassie/meshes/toe_mirror.stl
data/bipedal_robots/cassie/meshes/tarsus.stl
data/bipedal_robots/cassie/meshes/knee-output.stl
data/bipedal_robots/cassie/meshes/abduction.stl
data/bipedal_robots/digit/meshes/shoulder-roll-housing.obj
data/bipedal_robots/cassie/meshes/shin-bone_mirror.stl
data/bipedal_robots/cassie/meshes/hip_mirror.stl
data/bipedal_robots/cassie/meshes/yaw_mirror.stl
data/bipedal_robots/cassie/meshes/thigh_mirror.stl
