duburcqa/jiminy/(threads)

Thread 35 (2020-03-02):

Add more realistic sensors

duburcqa, 2020-03-02:
So far, only continuous joint position sensors, 3D force sensors, and Quat/Gyro/Accelo IMUs in world frame are available. It would be useful to have 1D force sensors (z-axis only), Gyzo/Accelero IMUs in robot frame, joint torque sensors, and discrete joint position sensors (returning int64).

Thread 36 (2020-03-02):

[core] Implement perfect rigid impact model

duburcqa, 2020-03-02:
Currently, the contact force is modelled using a spring-dumper mechanism. Using infinite stiffness without dumping for the ground reaction force should, **in theory**, replicate a perfectly rigid impact model. However, it would increase dramatically the stiffness of the ode, which in turn would be impossible to integrate using a decent step size. On the contrary, taking advantage of the discrete dynamics tools should do the job pretty well in Pinocchio (`impulseDynamics` and `forwardDynamics` under constraints).

Thread 37 (2020-03-02):

Undocumented API

duburcqa, 2020-03-02:
Python native code is properly documented, but it is not the case for the C++ API and the Python bindings (which are using the same documentation in most cases). It is really important at least the method and class that the user is intended to use in practice.

duburcqa, 2020-03-02:
Also, add a wiki page about the physics, especially about the contact model.

Thread 40 (2020-03-02):

Deploy package for Windows on Pypi

duburcqa, 2020-03-02:
The package available on Pypi for windows should bundle every required dynamic libraries, namely Eigen3, Eigenpy, Boost (only the few required components), Urdfdom, and Pinocchio, since it is quite difficult to install them for Windows so far.

duburcqa, 2020-04-18:
Fixed!

Closed 2020-04-18.

Thread 44 (2020-03-05):

Add dedicated motor class

duburcqa, 2020-03-05:
Currently, the motors are part of `Model` itself. This implementation has major flaws:
- It is inconsistent with the sensors, which are dedicated objects.
- The engine has to manage the options of all the motors at the same time. The size of some option parameters associated with the motors depends on the number of motors, therefore user-defined values must be disable whenever a motor is added. This unexpected behaviour is very disturbing for the user. Moreover, adding motor options requires to implement a custom `Model` class.
- It does not allow to use advanced motor model, for example using a realistic voltage/current-torque dynamics, or gears with backslash. It also enable to instantiate a motor without a model. It could be useful for example to assess their own dynamics, which is possible in the real world.

The idea would be to implement something similar to the sensor: all motors must share a common interface that would be specified by an abstract class. The motors would be part of the input of the command functor called by the engine.

duburcqa, 2020-03-05:
ping @matthieuvigne

duburcqa, 2020-03-06:
This is related to the issue https://github.com/Wandercraft/jiminy/issues/42. Having a dedicated interface for the motors would enable to implement a custom internal dynamics for them.

Closed 2020-03-11.

Thread 50 (2020-03-12):

[core] Automatically log the URDF and options

duburcqa, 2020-03-12:
Currently, the log file only contains data. As a result, it is impossible to replay the simulation or to compute some dynamical quantities using only a log file.

It would be great to log the URDF and options as string constants directly in the header of the log file (it may requires to not assume that the header is not split in multiple chunks while reading it).

duburcqa, 2020-12-16:
Fixed by https://github.com/Wandercraft/jiminy/pull/251

Closed 2020-12-16.

Thread 56 (2020-03-19):

Simulate force interactions between frames belonging to two separate models.

aelkhour, 2020-03-19:
One application which I find interesting for jiminy would be the ability to simulate more finely interactions between an robot exoskeleton and the person wearing it.

Currently jiminy can only simulate a pair of model (kinematic tree) and controller. I wonder whether it could be extended to handle multiple models along with force interactions between the model respective frames. This would bring jiminy closer to being able to run simulations on a kinematic graph rather than a simple kinematic tree (see for instance gazebo which can handle graphs).

Closed 2020-04-02.

Thread 63 (2020-03-26):

Reduce tolerance of unit tests

duburcqa, 2020-03-26:
Currently, the tolerance for the unit tests on the CI is pretty high. It is possible to be more accurate on my personal machine but I don't understand why exactly the UT are failing on the CI if I use the same tolerance. I need to reduce the accuracy on the CI by at least 2 order of magnitude. I would be great to understand such discrepancy.

duburcqa, 2020-03-26:
ping @matthieuvigne

Closed 2020-03-26.

Thread 66 (2020-03-29):

Add support for kinematic constaints.

matthieuvigne, 2020-03-29:
I wish to simulate a segway-like system: basically, a wheel turning on the ground. This cannot be exactly simulated in Jiminy, which only supports punctual contacts with an elastic ground: the 'hack' one could do would be to place many points along the rim of the wheel, and set them all as contact points.

Rather, I want to simulate the contact as an analytical constraint: i.e. the wheel is in perfect contact with the ground and does not slip. This can be done by adding the constraint in the dynamics equation as Lagrange multipliers.

Note that I'm only interested in having a constant contact throughout the simulation: I do not mean to implement 'analytical contact' for a walking robot, that would require an added contact detection framework. What I have in mind is a constant contact throughout the simulation. However, this is already a significant first step in that direction if we ever want to do that.

This is how I see the implementation:

 -  at a 'low-level', contact kinematics is implemented in ```pinocchio``` as ```pinocchio::forwardDynamics(..., J, drift)``` where J is the jacobian of the constraint, and drift the associated drift. This implementation of ```pinocchio::forwardDynamics``` would replace the aba algorithm in ```Engine.computeSystemDynamics```. In practice, ```pinocchio::forwardDynamics``` is likely to be much slower than aba (because it requires computing the inertia matrix, angument it with the jacobian, and do the inverse), thus aba would remain the default option, and Engine would switch to using forwardDynamics only if a contact constraint is being used.

 - like we did in ```aba```, we will need a custom implementation of ```forwardDynamics``` to support armature inertia.

 - While I do not need this for my use case, supporting several constraints at once seems a nice feature to have. I think the best way to handle this from the API standpoint is to give a name to each constraint, so adding and removing contact constraints would be like adding and removing sensors or motors.
 - As API, to simulate a contact analytical we need a jacobian, with signature ```matrixN_t jacobian(q)```, and the corresponding drift term with signature ```vectorN_t drif(q, v)```. The main usage would probably be to have a specific frame in contact, however, for a wheel, I want the wheel rim to be in contact, not a fixed point. This requries a 'custom' jacobian to be implemented. So I'm thinking about having two ways to define a constaint: by a simple frame name, or by a callback function.

In the end, here is an overall architecture of what I plan to do:

 - Define signatures for jacobian and drift callback functions:
```c++
typedef matrixN_t (*JacobianFct_t) (model, data, q);
typedef vectorN_t (*DriftFct_t) (model, data, q, v);
```
 - Add class representing the contact:

```c++
class ContactConstraint:
    ContactConstraint(std::string contactFrameName);
    ContactConstraint(JacobianFct_t J, DriftFct_t drift);
```

- Add add/remove methods to robot, like add / remove of motors, sensors, contact frames... work:
    - ```Robot::setContactConstraint(std::string name, ContactConstraint)```

The engine would then switch between both implements of the dynamics depending of the presence of not of ContactContraint. Note that both contact are not mutually exclusive: you could imagine having both intermitent, elastic contacts, and constant constraints (for instance, fix you robot foot on the ground analytically, then make its hand hit a wall).

Closed 2020-04-08.

Thread 77 (2020-04-12):

Improve Jiminy notebook tutorial

duburcqa, 2020-04-12:
There are many other things we could add to this tutorial:
- Adding constants / new variables to a log - doesn't make much sense on a simple pendulum, but would on a more complex system.
- Adding sensors, changing the simulation configuration.
- A multi-robot simulation with interesting coupling

...

Thread 95 (2020-04-29):

Add unit  tests for jiminy_py dynamics helpers

duburcqa, 2020-04-29:
Some methods in this module are rather complex and it would be nice to validate way. It is pretty "easy" to do it. Running first a simulation, extracting only the motor position/velocity/acceleration, and trying the recover the missing data.

duburcqa, 2020-11-25:
Part of the code is now partially tested though `gym_jiminy` unit tests, but it is clearly not enough, considering that now about 40% of the whole code base is pure Python.

Thread 121 (2020-05-28):

Isolating pip build for Pinocchio

jcarpent, 2020-05-28:
Dear @duburcqa,

I was wondering how does it cost to isolate the pip build for Pinocchio from your current setup? I think it might be useful to do it, in order to let external users rely on Pinocchio using pip.

Thanks in advance for your help,

Justin

duburcqa, 2020-05-28:
Hi @jcarpent,

Not much, but what do you whant to do exactly ? I could deploy Pinocchio and Eigenpy as standalone packages on pip by myself, but I assume you would prefer to do it yourself ? In any case it is pretty straightforward, one just have to copy-paste `.github` folder and remove the part associated with Jiminy (after one or two minor changes).

jcarpent, 2020-05-28:
I would like to also distribute Pinocchio and EigenPy on pypy as independent packages. You've already done a great job for this support.
I would really appreciate if you can provide the skeleton, and I can ensure the rest with your support. We can imagine to host it in the stack of tasks organization if you agree and I will add you as a member.

Is it fine?

duburcqa, 2020-05-28:
I'm pretty busy right now, but it sounds like a deal. I could add github CI doing the job directly on Pinocchio and Eigenpy repositories. It should be doable in a few hours.

jcarpent, 2020-05-28:
OK. Very nice, please proceed when you have time.
By the way, I'm trying to setup a CI for Windows using Conda, and I was wondering which compiler are you using to compile Pinocchio?

duburcqa, 2020-05-28:
I'm using Visual Studio 2019, you could have a look to this file <https://github.com/Wandercraft/jiminy/blob/master/.github/workflows/win.yml>.
Why do you want to use Conda? It is not necessary at all to build pinocchio on Windows.

jcarpent, 2020-05-28:
For installing the whole bunch of dependencies. On my side here (https://github.com/stack-of-tasks/pinocchio/blob/d921a23c99f03f3e8fba901030949dca2c0f8aa7/.github/workflows/windows-conda.yml), CMake is not able to find the compiler ClangCl, while everyone works fine on a local machine. In your case, you use `v142`. It is not working when I'm trying to compiile Pinocchio. Do you know why?

duburcqa, 2020-05-29:
Installing the dependencies without conda shouldn't be a big deal. Why to use `ClangCl` instead of `v142` on Windows ? I guess you have issues because there is spaces in your path `%programfiles(x86)%\Microsoft Visual Studio\2019\Enterprise\VC\Tools\clang++.exe`. You should get rid of them, by using the infamous windows alternative short path name. In this case, you could replace `\Microsoft Visual Studio\` by `\MICROS~1\` (6 first charatecters in uppercase, follow by ~N, N is a unique ID to distinguish folders starting with the same 6 characters.)

jcarpent, 2020-05-29:
The v142 is failing on my side dramatically. It is not able to disambiguate template signatures with Eigen objects.
In the meantime, I’ve fixed the issue which was due to cmake.

For the CI, one needs Fast feedback to get feedback on the current errors. It will be very long to wait hours for compiling dependencies while Pinocchio already has many. I would say, this is a usual and good practices to only considering the compilation of one’s projects.

Closed 2020-10-13.

Thread 217 (2020-10-25):

[core] Random terrain generation

duburcqa, 2020-10-25:
It would be nice to be able to compute the collision with a analytical ground function `f(x,y) -> (z, normal)`, and to display it in the viewer. It is not straightforward to do so because computing the collision with a very large non-convex mesh is time-consuming. After some benchmark, just replacing the halfspace ground by a mesh increases the overall computation time by a factor x10 (which means that computing the collision is probably x1000 slower...).

duburcqa, 2021-10-08:
PR #410 fixes this issue partially. It adds the support of rendering of ground profile to panda3d viewer, along with random ground collision for contact points using impulse contact model (this was already supported by spring damper contact model).

What is still missing is proper collision detection for collision geometries instead of contact points. But the scope of this issue is not limited to random terrain generation.

Closed 2021-10-10.

Thread 252 (2020-12-16):

[python] Restore robot state from log for replay and more.

duburcqa, 2020-12-16:
```
import json

import pinocchio as pin

import jiminy_py.core as jiminy
from jiminy_py.log import read_log

log_data, constants = read_log(log_fullpath)

robot = jiminy.Robot()
robot.initialize(constants['HighLevelController.urdf_path'],
                 bool(int(constants['HighLevelController.has_freeflyer'])),
                 constants['HighLevelController.mesh_package_dirs'].split())
pin.Model.loadFromString(robot.pinocchio_model, constants['HighLevelController.pinocchio_model'])

# Use the hardware description file to restore the sensors/controller

# Restoring the options will fail, since the hardware and controller is missing
all_options = json.loads(constants['HighLevelController.options'])
robot.set_options(all_options['system']['robot'])
```

duburcqa, 2020-12-16:
Generating a hardware description file in C++ based on a Jiminy.Robot object is missing.

duburcqa, 2021-05-03:
Related to #337.

Closed 2021-05-03.

Thread 255 (2020-12-17):

[viewer] Add a mechanism to define and update extra primitives.

duburcqa, 2020-12-17:
For instance, it would be great to display the CoM (center of mass) and the CoP (center of pressure) using fixed-size sphere primitives, or contact forces using dynamic-size capsules.  This information requires knowledge about the dynamics of the system, which is not the case for the viewer itself. It would be harmful to introduce such dependency in the viewer itself, so it makes sense to enable to user to register a callback function that will be called automatically during video replay. Using the same mechanism than for camera motion should do the job pretty well.

duburcqa, 2020-12-17:
Related to https://github.com/Wandercraft/jiminy/issues/259

duburcqa, 2021-04-13:
Fixed by https://github.com/duburcqa/jiminy/pull/319

Closed 2021-04-13.

Thread 259 (2020-12-17):

[python/viewer] Add backend-independent interface to add and update primitive geometries.

duburcqa, 2020-12-17:
Currently, it is possible to add hppfcl primitive geometries to both Meshcat and Geopetto-Gui, yet it is not possible to update there properties using the same principal. Moreover, their respective API to do so is quite bad. One way to get around this limitation would be to delete and create a new geometry systematically, but it is likely to perform poorly.

duburcqa, 2021-05-03:
Fixed by #340. Only Panda3D is supported for now.

Closed 2021-05-03.

Thread 275 (2021-01-31):

[core] Ensure no memory allocation when simulation is running.

duburcqa, 2021-01-31:
Eigen already offers some very handy functionalities to ensure no memory is allocated at runtime using:
```
#define EIGEN_RUNTIME_NO_MALLOC
Eigen::internal::set_is_malloc_allowed(false);
```

duburcqa, 2021-02-01:
Most time-consuming memory allocation issues have been fixed recently (https://github.com/Wandercraft/jiminy/pull/276 and https://github.com/Wandercraft/jiminy/pull/277). Yet, it would be much better to completely forbid memory allocation during simulation.

duburcqa, 2021-02-01:
After doing some testing using `set_is_malloc_allowed`, I can confirm that the current version is not allocating memory during a simulation.

Closed 2021-02-02.

Thread 282 (2021-02-07):

[python/viewer] Replay log data simulation reliably.

duburcqa, 2021-02-07:
For now, it is impossible to replay flexible simulation using rigid model. Ideally, once should create a new robot based on logged one, rather than alter the current one. Ideally, the viewer should deal the `Jiminy::Model` directly instead of `Jiminy::Robot`, so that it is straightfoward to implement a `copy` method, because otherwise it would requires to copy every sensors/motors and the controller, which may be hazardous. This could be done by implementing a `copyModel` method. Another way to deal with this issue should be to add `pinocchio_model/data_flexible`/`pinocchio_model/data_rigid` attribute to `Jiminy::Model`, but it does not guarantee that the flexibility model did not changed. Ultimately, a third solution would be to enable instantiating a `Jiminy::Model` from logged data (stream or file). It seems more reliable and requires minimal refactoring of the existing code base. So it is probably the way to go.

duburcqa, 2021-04-28:
> Ultimately, a third solution would be to enable instantiating a Jiminy::Model from logged data (stream or file). It seems more reliable and requires minimal refactoring of the existing code base. So it is probably the way to go.

This approach has been implemented by https://github.com/duburcqa/jiminy/pull/334.

Closed 2021-04-28.

Thread 285 (2021-03-03):

[core] External forces applied on the robot `fext` is wrong in case of equality constraints.

duburcqa, 2021-03-03:
`fext` is not updated based on the value of the lagrangian multipliers of the problems for user-specified constraints.

Thread 299 (2021-03-18):

Original tutorial seems to be not working.

ashsrobbins, 2021-03-18:
Running the original tutorial .ipynb, there seem to be issues I couldn't solve. First,
```AbstractController' object has no attribute 'set_controller_handle```
Commenting out the line trying to set the handle causes the next problem:
```TypeError: run() missing 1 required positional argument: 'v0'```
Adding a v0 variable which mimics x0 finally results in one last error:

```RuntimeError                              Traceback (most recent call last)
<ipython-input-34-90bc00b210d1> in <module>
     20
     21 # Launch the simulation
---> 22 simulator.run(simulation_duration, x0,v0)

~/anaconda3/envs/joints/lib/python3.6/site-packages/jiminy_py/simulator.py in run(self, tf, q0, v0, is_state_theoretical, log_path, show_progress_bar)
    418                 "[{elapsed}<{remaining}]"))
    419         try:
--> 420             self.simulate(tf, q0, v0, None, is_state_theoretical)
    421         finally:  # Make sure that the progress bar is properly closed
    422             if show_progress_bar:

~/anaconda3/envs/joints/lib/python3.6/site-packages/jiminy_py/simulator.py in simulate(self, t_end, q_init, v_init, a_init, is_state_theoretical)
    384             t_end, q_init, v_init, a_init, is_state_theoretical)
    385         if return_code != jiminy.hresult_t.SUCCESS:
--> 386             raise RuntimeError("The simulation failed.")
    387
    388     def run(self,

RuntimeError: The simulation failed.```

It doesn't get past the first step.

duburcqa, 2021-03-18:
I haven't updated the tutorial since a (very) long time. I will take care of it asap. Sorry about that.

duburcqa, 2021-03-18:
It should be working now: https://github.com/duburcqa/jiminy/blob/generic_locomotion_envs/examples/tutorial.ipynb
I will update the version on master for the next release 1.6.5, in a few days.

Closed 2021-03-23.

Thread 337 (2021-05-01):

[python/viewer] Update contact sensor data when replaying log file.

duburcqa, 2021-05-01:
It only requires to restore sensors and motors originally attached to the robot when building robot from log, which is not the case for now. This could be done by enabling exporting hardware configuration file from a robot.

duburcqa, 2022-09-26:
Similarly, the theoretical model is lost, which means that it is theoretically impossible to load the options from the configuration file, which is problematic. The good procedure would be to restore first the theoretical model, then to update the options (and the hardware), and finally to overwrite the theoretical model with the actual one.

duburcqa, 2024-04-29:
Fixed by https://github.com/duburcqa/jiminy/pull/775

Closed 2024-04-29.

Thread 343 (2021-05-20):

Segmentation fault when trying to use pinocchio data

vcparedesc, 2021-05-20:
Hello, I am using Jiminy tag version 1.6.17. I was trying to get the orientation and position of a particular link using a procedure I was using in tag version 1.6.1 however, I am getting segmentation faults. This is a minimal modification of the double pendulum example that reproduces my problem:

```
void computeCommand(float64_t        const & t,
                    vectorN_t        const & q,
                    vectorN_t        const & v,
                    sensorsDataMap_t const & sensorsData,
                    vectorN_t              & command)
{
    // No controller: energy should be preserved
   auto linkId = robot->pncModel_.getFrameId("PendulumArm");
}
```

I made sure to declare "robot" as a global variable (auto robot = std::make_shared<Robot>();)

Whenever I remove the getFrameId line in computeCommand the code doesn't have any problems running, but adding the line causes the sefgaults. I am using the pip installation method for building the example.

Victor

duburcqa, 2021-05-20:
Can you provide the source file ? I'm quite surprise it is not working.

duburcqa, 2021-05-20:
Besides, do you have the trace ? You can have it using `gdb`. It would be very helpful.

duburcqa, 2021-05-20:
I tried to reproduce the issue, and it is working on my side. Here is the source file I used:
[test.txt](https://github.com/duburcqa/jiminy/files/6515664/test.txt)

vcparedesc, 2021-05-20:
I have tried it in a new computer and I got the same behavior. Both of them had previous versions of jiminy, but they were installed by source if that makes a diference.

This is what I get using gdb:
I am also uploading the file I'm using.
```
Reading symbols from pendulum...                                                                                                                                                                           
/home/victor/Documents/atalante_cpp_jiminy/build/core: No such file or directory.                                                                                                                          
(gdb) run                                                                                                                                                                                                  
Starting program: /home/victor/Documents/atalante_cpp_jiminy/build/pendulum                                                                                                                                
                                                                                                                                                                                                           
Program received signal SIGSEGV, Segmentation fault.                                                                                                                                                       
0x00005555555711b0 in pinocchio::details::FilterFrame::operator()<double, 0> (this=0x7fffffffccb0, frame=...) at /opt/openrobots/include/pinocchio/multibody/model.hxx:30
30            { return (typeMask & frame.type) && (name == frame.name); }
(gdb) where
#0  0x00005555555711b0 in pinocchio::details::FilterFrame::operator()<double, 0> (this=0x7fffffffccb0, frame=...) at /opt/openrobots/include/pinocchio/multibody/model.hxx:30
#1  0x000055555556f076 in __gnu_cxx::__ops::_Iter_pred<pinocchio::details::FilterFrame>::operator()<__gnu_cxx::__normal_iterator<pinocchio::FrameTpl<double, 0> const*, std::vector<pinocchio::FrameTpl<double, 0>, Eigen::aligned_allocator<pinocchio::FrameTpl<double, 0> > > > > (this=0x7fffffffccb0, __it=<error reading variable: Cannot access memory at address 0x5555556a5050>)
    at /usr/include/c++/9/bits/predefined_ops.h:283
#2  0x000055555556d17c in std::__find_if<__gnu_cxx::__normal_iterator<pinocchio::FrameTpl<double, 0> const*, std::vector<pinocchio::FrameTpl<double, 0>, Eigen::aligned_allocator<pinocchio::FrameTpl<double, 0> > > >, __gnu_cxx::__ops::_Iter_pred<pinocchio::details::FilterFrame> > (__first=<error reading variable: Cannot access memory at address 0x5555556a5050>, __last=
                {name = "", parent = 0, previousFrame = 0, placement = {<pinocchio::SE3Base<pinocchio::SE3Tpl<double, 0> >> = {<No data fields>}, rot = {<Eigen::PlainObjectBase<Eigen::Matrix<double, 3, 3, 0, 3, 3> >> = {<Eigen::MatrixBase<Eigen::Matrix<double, 3, 3, 0, 3, 3> >> = {<Eigen::DenseBase<Eigen::Matrix<double, 3, 3, 0, 3, 3> >> = {<Eigen::DenseCoeffsBase<Eigen::Matrix<double, 3, 3, 0, 3, 3>, 3>> = {<Eigen::DenseCoeffsBase<Eigen::Matrix<double, 3, 3, 0, 3, 3>, 1>> = {<Eigen::DenseCoeffsBase<Eigen::Matrix<double, 3, 3, 0, 3, 3>, 0>> = {<Eigen::EigenBase<Eigen::Matrix<double, 3, 3, 0, 3, 3> >> = {<No data fields>}, <No data fields>}, <No data fields>}, <No data fields>}, <No data fields>}, <No data fields>}, m_storage = {m_data = {array = {0, 0, 0, 0, 0, 0, 0, 0, 6.9533480164877528e-310}}}}, <No data fields>}, trans = {<Eigen::PlainObjectBase<Eigen::Matrix<double, 3, 1, 0, 3, 1> >> = {<Eigen::MatrixBase<Eigen::Matrix<double, 3, 1, 0, 3, 1> >> = {<Eigen::DenseBase<Eigen::Matrix<double, 3, 1, 0, 3, 1> >> = {<Eigen::DenseCoeffsBase<Eigen::Matrix<double, 3, 1, 0, 3, 1>, 3>> = {<Eigen::DenseCoeffsBase<Eigen::Matrix<double, 3, 1, 0, 3, 1>, 1>> = {<Eigen::DenseCoeffsBase<Eigen::Matrix<double, 3, 1, 0, 3, 1>, 0>> = {<Eigen::EigenBase<Eigen::Matrix<double, 3, 1, 0, 3, 1> >> = {<No data fields>}, <No data fields>}, <No data fields>}, <No data fields>}, <No data fields>}, <No data fields>}, m_storage = {m_data = {array = {2.1219957904712067e-314, 0, 0}}}}, <No data fields>}}, type = (unknown: 1432950240), inertia = {<pinocchio::InertiaBase<pinocchio::InertiaTpl<double, 0> >> = {<No data fields>}, m_mass = 0, m_com = {<Eigen::PlainObjectBase<Eigen::Matrix<double, 3, 1, 0, 3, 1> >> = {<Eigen::MatrixBase<Eigen::Matrix<double, 3, 1, 0, 3, 1> >> = {<Eigen::DenseBase<Eigen::Matrix<double, 3, 1, 0, 3, 1> >> = {<Eigen::DenseCoeffsBase<Eigen::Matrix<double, 3, 1, 0, 3, 1>, 3>> = {<Eigen::DenseCoeffsBase<Eigen::Matrix<double, 3, 1, 0, 3, 1>, 1>> = {<Eigen::DenseCoeffsBase<Eigen::Matrix<double, 3, 1, 0, 3, 1>, 0>> = {<Eigen::EigenBase<Eigen::Matrix<double, 3, 1, 0, 3, 1> >> = {<No data fields>}, <No data fields>}, <No data fields>}, <No data fields>}, <No data fields>}, <No data fields>}, m_storage = {m_data = {array = {4.6355706025130063e-310, 0, 0}}}}, <No data fields>}, m_inertia = {m_data = {<Eigen::PlainObjectBase<Eigen::Matrix<double, 6, 1, 0, 6, 1> >> = {<Eigen::MatrixBase<Eigen::Matrix<double, 6, 1, 0, 6, 1> >> = {<Eigen::DenseBase<Eigen::Matrix<double, 6, 1, 0, 6, 1> >> = {<Eigen::DenseCoeffsBase<Eigen::Matrix<double, 6, 1, 0, 6, 1>, 3>> = {<Eigen::DenseCoeffsBase<Eigen::Matrix<double, 6, 1, 0, 6, 1>, 1>> = {<Eigen::DenseCoeffsBase<Eigen::Matrix<double, 6, 1, 0, 6, 1>, 0>> = {<Eigen::EigenBase<Eigen::Matrix<double, 6, 1, 0, 6, 1> >> = {<No data fields>}, <No data fields>}, <No data fields>}, <No data fields>}, <No data fields>}, <No data fields>}, m_storage = {m_data = {array = {0, 0, 0, 0, 6.953348016675893e-310, 0}}}}, <No data fields>}}}}, __pred=...) at /usr/include/c++/9/bits/stl_algo.h:124
#3  0x00007ffff715a08f in pinocchio::urdf::details::UrdfVisitor<double, 0, pinocchio::JointCollectionDefaultTpl>::addRootJoint(pinocchio::InertiaTpl<double, 0> const&, std::__cxx11::basic_string<char, std::char_traits<char>, std::allocator<char> > const&) () from /home/victor/.local/lib/python3.8/site-packages/jiminy_py/core/lib/libjiminy.so.1.6
#4  0x00007ffff72e974f in pinocchio::urdf::details::parseRootTree(urdf::ModelInterface const*, pinocchio::urdf::details::UrdfVisitorBaseTpl<double, 0>&) ()
   from /home/victor/.local/lib/python3.8/site-packages/jiminy_py/core/lib/libjiminy.so.1.6
#5  0x00007ffff72e9b25 in pinocchio::urdf::details::parseRootTree(std::__cxx11::basic_string<char, std::char_traits<char>, std::allocator<char> > const&, pinocchio::urdf::details::UrdfVisitorBaseTpl<double, 0>&) () from /home/victor/.local/lib/python3.8/site-packages/jiminy_py/core/lib/libjiminy.so.1.6
--Type <RET> for more, q to quit, c to continue without paging--                                  
#6  0x00007ffff714fd50 in jiminy::buildModelsFromUrdf(std::__cxx11::basic_string<char, std::char_traits<char>, std::allocator<char> > const&, bool const&, std::vector<std::__cxx11::basic_string<char, std::char_traits<char>, std::allocator<char> >, std::allocator<std::__cxx11::basic_string<char, std::char_traits<char>, std::allocator<char> > > > const&, pinocchio::ModelTpl<double, 0, pinocchio::JointCollectionDefaultTpl>&, pinocchio::GeometryModel&, boost::optional<pinocchio::GeometryModel&>, bool const&) () from /home/victor/.local/lib/python3.8/site-packages/jiminy_py/core/lib/libjiminy.so.1.6
#7  0x00007ffff719822a in jiminy::Model::initialize(std::__cxx11::basic_string<char, std::char_traits<char>, std::allocator<char> > const&, bool const&, std::vector<std::__cxx11::basic_string<char, std::char_tra
its<char>, std::allocator<char> >, std::allocator<std::__cxx11::basic_string<char, std::char_traits<char>, std::allocator<char> > > > const&) ()
   from /home/victor/.local/lib/python3.8/site-packages/jiminy_py/core/lib/libjiminy.so.1.6
#8  0x00007ffff7222afd in jiminy::Robot::initialize(std::__cxx11::basic_string<char, std::char_traits<char>, std::allocator<char> > const&, bool const&, std::vector<std::__cxx11::basic_string<char, std::char_tra
its<char>, std::allocator<char> >, std::allocator<std::__cxx11::basic_string<char, std::char_traits<char>, std::allocator<char> > > > const&) ()
   from /home/victor/.local/lib/python3.8/site-packages/jiminy_py/core/lib/libjiminy.so.1.6
#9  0x00005555555619c9 in main (argc=1, argv=0x7fffffffda48) at /home/victor/Documents/atalante_cpp_jiminy/double_pendulum.cc:86

```

Thanks!

[double_pendulum.txt](https://github.com/duburcqa/jiminy/files/6517895/double_pendulum.txt)

vcparedesc, 2021-05-20:
Compiling jiminy from source and compiling the cpp project against the local libraries works. The problem only happens when installing jiminy_py and pinocchio with pip and apt install, respectively. Maybe it is a problem with the installed pinocchio version?

vcparedesc, 2021-05-20:
I installed pinocchio following the instructions in: https://stack-of-tasks.github.io/pinocchio/download.html
with:
 `sudo apt install -qqy robotpkg-py38-pinocchio`

which unpacks:
`robotpkg-py38-pinocchio_2.6.0_amd64.deb`

duburcqa, 2021-05-20:
Ok I see. Jiminy is build against pinocchio 2.5.6, so maybe it is the issue, they did quite a lot of changes in `Frame` recently. For now I should enforce `pinocchio < 2.6.0` in the provided Cmake configuration file of Jiminy installed via `pip`. Could you check what's happen if you downgrade your release of `pinocchio` ? The version of the dependencies used to precompile jiminy is provided [here](https://github.com/duburcqa/jiminy/blob/master/build_tools/easy_install_deps_ubuntu.sh)

```bash
sudo apt-get install -y --allow-downgrades --allow-unauthenticated \
        robotpkg-urdfdom-headers=1.0.4 robotpkg-hpp-fcl=1.7.1 robotpkg-pinocchio=2.5.6 \
        robotpkg-py3*-qt5-gepetto-viewer=4.10.1r2 robotpkg-py3*-qt5-gepetto-viewer-corba=5.5.1 robotpkg-py3*-omniorbpy=4.2.4 \
        robotpkg-py3*-eigenpy=2.6.2 robotpkg-py3*-hpp-fcl=1.7.1 robotpkg-py3*-pinocchio=2.5.6
```

vcparedesc, 2021-05-20:
Some of the packages were having dependencies issues, just as a quick check I installed a subset of your lines:
```
sudo apt-get install -y --allow-downgrades --allow-unauthenticated \
        robotpkg-urdfdom-headers=1.0.4 robotpkg-hpp-fcl=1.7.1 robotpkg-pinocchio=2.5.6 \
        robotpkg-py38-omniorbpy=4.2.4 \                                                                               
        robotpkg-py38-eigenpy=2.6.2 robotpkg-py38-hpp-fcl=1.7.1 robotpkg-py38-pinocchio=2.5.6
```
... and that solved the problem! Thank you!

Closed 2021-05-20.

Thread 381 (2021-07-14):

[core] Take advantage of the new features introduced by Pinocchio 2.9

duburcqa, 2021-07-14:
- `aba` now computes the acceleration and forces, no need to do it manually anymore
- armature are taking into account to algorithm, through `model.armature`. No need to overload pinocchio anymore.
- `RigidContraintModel` and `RigidContraintData` are now provided to handle fixed frame constraints.

It is not straightfoward to use the new optimized algorithms for constraint computation implemented in Pinocchio. The complexity comes from the inability to define custom jacobian for the constraints in Pinocchio:
- First approach [try hard to use provided algorithm]
The easiest way to get around this limitation is to abuse the `data.J` (which is the concatenation in column of the joint jacobian in world frame) by swapping the memory with the constraint Jacobian computed by Jiminy. Then, each constraint would feature an extra attributes corresponding to the associated `RigidContraintModel` and `RigidContraintData`, always assuming 6 fixed DoFs in WORLD frame whether the actual reference frame. Jiminy `Model` would provide new methods `getConstraintModel` and `getConstraintData` to get the ordered vectors of `RigidContraintModel` and `RigidContraintData` attributes for all active constraints respectively. This way, it is not necessary to modify the core algorithms of Pinocchio. However, it would add empty rows in the jacobian, that may break the algorithm.
- Second apporach [Reimplement the sparse decomposition algorithm]
The main issue would be code duplication.

duburcqa, 2022-04-02:
After looking more closely at the [implementation of the cholesky decomposition](https://github.com/stack-of-tasks/pinocchio/blob/46abd97c9738e05b7ffafa1b0e0a7011f12cf2ca/src/algorithm/contact-cholesky.hxx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) in Pinocchio, it is quite far from the current architecture of Jiminy. Jiminy is providing the [whole jacobian as a block matrix](https://github.com/duburcqa/jiminy/blob/a1e571b7b45df3ddb76f5da05f09fb75f9a97c25/core/src/solver/LCPSolvers.cc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), and the connection with individual constraints is already lost at this point.

I suggest adopting the non-aggregated formulation in Jiminy. It would be much easier to take advantage of the sparsity in computations as in Pinocchio and to properly handle friction and non-penetration instead of doing confusing index manipulations in PGS itself.

duburcqa, 2022-04-06:
Jiminy has been refactored as planned. Now it would be possible to implement the Cholesky decomposition of `JMinvJt` as proposed in the [paper](http://www.roboticsproceedings.org/rss17/p017.pdf).

Thread 456 (2021-11-29):

[core] Fix PGS friction cone.

duburcqa, 2021-11-29:
Enforcing `||Ft||<µ Fn` independently using `Fx/y = min(Fx/y, sqrt(µ Fn^2 - Fy/x^2))` for x and y axes is ill-posed and can be proven to not converge to the solution. It clamping must be done jointly x and y axes `(x, y) *= min(1.0, ||(x, y)|| / µ Fn)` to converge.

Closed 2021-12-01.

Thread 480 (2022-01-25):

[python] Leverage Casadi JIT compilation

duburcqa, 2022-01-25:
It is possible to speedup simulation by pre-compiling computationally intensive loops. For C++ core, the main bottlenecks are related to the contact solver, namely the decomposition of the mass matrix and the projected gauss seidel algorithm. Precompilation is not going to help much in this cases. However, it could be very helpful to speed-up reinforcement learning pipeline where many basic operators and pinocchio functions are chained together. It would not only totally remove the overhead of intermediary function calls, but also speed-up computation by taking advantage of the given model's kinematic tree. What is still unclear is in what extend it casidi symbolics can be mixed with the robot model exposed by the simulator. The trivial implementation would consists in compiling standalone algorithms that requires proving the current state of the simulator systematically. It is unlikely to increase much the computational cost as only forward kinematics in going to be involved, which is fairly cheap to evaluate, in particular if the computation graph is simplified at compile time to remove irrelevant branches. This feature is only available with pinocchio 2.9.0, which may require some refactoring of Jiminy to support it.

duburcqa, 2022-07-12:
In principale, i should make jiminy/pinocchio code jit-able with JAX as a side effect, which is a tremendous advantage.

Thread 489 (2022-03-19):

Take advantage of newly introduced `HeightField` in hppfcl

duburcqa, 2022-03-19:
Proper support of heigthmap has been added to hpp-fcl. It should be used in place of the current implementation of collision detection. It would be more generic than the current implementation, and hopefully still efficient. However, it requires discretizing the ground profile, which is not necessary for now. It would also prevent relying on a hack to render the ground.

duburcqa, 2023-05-16:
It would also be nice to use pre-allocated distance / collision functors as discribed [here](https://github.com/humanoid-path-planner/hpp-fcl/blob/e126bda70aa38ea2a6cf0776d01aec9dcb933683/test/box_box_collision.cpp)

duburcqa, 2024-02-02:
Ground profile height map can now be converted into heightmap in C++ core. There is both a slowdown and a accuracy loss of doing so but it is the price to pay. The current implementation generate a regular heightmap first for some prescribed x and y grid unit, then eventually it is decimated afterward. Decimation has no effect on accuracy but conversion to regular map has.

duburcqa, 2024-02-02:
I suggest modifying the existing `GroundProfile` engine option, which is for now working on symbolic heightmap functions, to rather operate on `hppfcl::collisionObject` instances directly. This way, the slowdown and accuracy loss would not be a simulation concern but rather a user concern. Generation could be done only once, at first instantiation of the environment rather than every reset.

Thread 501 (2022-04-05):

multiprocessing.current_process is not callable

duburcqa, 2022-04-05:
### [Codacy](https://app.codacy.com/gh/duburcqa/jiminy/commit?cid=631892547) detected an issue:
#### Message: `multiprocessing.current_process is not callable`

#### Currently on:
+ **Commit**:  57734817a2910e77d3b602dd4b438c61db6f7bf8
+ **File**:    [python/jiminy_py/src/jiminy_py/viewer/viewer.py](https://github.com/duburcqa/jiminy/blob/57734817a2910e77d3b602dd4b438c61db6f7bf8/python/jiminy_py/src/jiminy_py/viewer/viewer.py)
+ **LineNum**: [97](https://github.com/duburcqa/jiminy/blob/57734817a2910e77d3b602dd4b438c61db6f7bf8/python/jiminy_py/src/jiminy_py/viewer/viewer.py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)

Closed 2022-04-05.

Thread 513 (2022-05-01):

[python/viewer] Refactoring.

duburcqa, 2022-05-01:
- `panda3d-sync` and `meshcat` backends should run simultaneously to avoid having to rely on dirty hack based on `pyppeteer`. It makes sense since  `panda3d-sync` is always available and is computationally very cheap since the image is only rendered when needed. `meshcat` is still relevant for remote display and embedded views in notebooks.

- `View`(s) and `Viewer` should be separated more clearly. A view is associated with a unique robot, while the viewer is shared between them.

- It must be decided if it is still relevant to enforce having a single Viewer (backend) running at the same time. It is useful for meshcat that connects to any running server since it is supposed to be unique. This way, a persistent server can be started from outside and viewers from different sessions just connect to it simultaneously. The usefulness of this feature is questionable as it seems to have no real use case.

duburcqa, 2024-07-15:
After thinking, I'm in favour of moving the management of robots inside viewers at `Simulator` level. `Viewer` would be responsible for managing an instance of the backend, which would not have to be a singleton anymore (but would be by default). It does not really make sense for the viewer to manager this content the way it is currently.

Thread 530 (2022-05-31):

Modelling flexible link robots using virtual link/joint method

shamilmamedov, 2022-05-31:
Hi!
I want to model a flexible link robot by truncating the link into several virtual links connected by means of passive virtual joints with certain stiffness and damping (see the figure below, it explains the concept for single link robot). I have a URDF file that describes approximated model, but it doesn't contain joint stiffness and damping. I want to implement a simulator for training and RL agent. Is it possible to it using jiminy? Do you have any examples of flexible robots? What is the best place to start implementing flexible link robot simulator?

Thank you in advance!

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
d

shamilmamedov, 2022-05-31:
Awesome! I don't need to reinvent the wheel then. Looking forward for insights from you.

shamilmamedov, 2022-06-03:
@duburcqa, please let me know about insights that you mentioned as soon as you can

duburcqa, 2022-06-04:
First, there is an example of simple RL environment based on Jiminy [here](https://github.com/duburcqa/jiminy/blob/master/python/gym_jiminy/envs/gym_jiminy/envs/cartpole.py). Next, a basic tutorial is available [here](https://github.com/duburcqa/jiminy/blob/master/examples/python/tutorial.ipynb). Finally, a sketch of document can be found [here](https://duburcqa.github.io/jiminy/).

Regarding your specific setup, you can add deformation points either at the location of an actual joint or a fixed frame. In you case, it seems to be fixed frame. You need to adapt your kinematic tree to break up the single link in several smaller fixed rigidly attached to each other using "fixed" joints. Each of the sub-links must have their own visual and collision geometries. Then, once you URDF model is adapted you can start simulating flexibility very easily. To this end, two options must be configured:
```
model_options = robot.get_model_options()
model_options["dynamics"]["enableFlexibleModel"] = True
model_options["dynamics"]["flexibilityConfig"] = [{
    'frameName': "PendulumJoint",
    'stiffness': k * np.ones(3),
    'damping': nu * np.ones(3),
    'inertia': np.zeros(3)
}]
robot.set_model_options(model_options)
```
where `model_options["dynamics"]["flexibilityConfig"]` is a list of sub-dict that fully characterize a given deformation point. [Here](https://github.com/duburcqa/jiminy/files/8837958/flexibility_model.pdf) is a figure that describe the dynamical model. I can give you more details if you like.

Here is a very basic example to create a flexible model:
```
import os
import numpy as np
from pkg_resources import resource_filename

import jiminy_py.core as jiminy

# Get URDF path
data_dir = resource_filename("gym_jiminy.envs", "data/toys_models/cartpole")
urdf_path = os.path.join(data_dir, "cartpole.urdf")

# Instantiate robot
robot = jiminy.Robot()
robot.initialize(urdf_path, has_freeflyer=False, mesh_package_dirs=[data_dir])

# Add motors and sensors
motor_joint_name = "slider_to_cart"
encoder_sensors_descr = {
    "slider": "slider_to_cart",
    "pole": "cart_to_pole"
}
motor = jiminy.SimpleMotor(motor_joint_name)
robot.attach_motor(motor)
motor.initialize(motor_joint_name)
for sensor_name, joint_name in encoder_sensors_descr.items():
    encoder = jiminy.EncoderSensor(sensor_name)
    robot.attach_sensor(encoder)
    encoder.initialize(joint_name)

# Add deformation points
k, nu, Ia = 20.0, 0.1, 0.0
model_options = robot.get_model_options()
model_options["dynamics"]["enableFlexibleModel"] = True
model_options["dynamics"]["flexibilityConfig"] = [{
    'frameName': "PendulumJoint",
    'stiffness': k * np.ones(3),
    'damping': nu * np.ones(3),
    'inertia': Ia * np.ones(3)
}]
robot.set_model_options(model_options)
```

I recommend you to have a look to the set of all available options for both the engine and the model using `get_options`. I would give an overview of a subset of the features offered by Jiminy.

shamilmamedov, 2022-06-07:
@duburcqa, thank you very much for detailed insights on implementing flexible robot simulator. Are you familiar with any other simulators/software for easy simulation flexible robots, so I can compare results of Jiminy with something external?

duburcqa, 2022-06-07:
> Are you familiar with any other simulators/software for easy simulation flexible robots, so I can compare results of Jiminy with something external?

Hum, I don't think there is any, probably because of the lack of consensus regarding the model. The one I'm using builds on the work of [Matthieu Vigne](https://www.theses.fr/2021UPSLM044) and adds armature inertia to make sure the velocity is continuous. It enables to take larger integration time steps without diverging. The exact model requires Finite Element Analysis (FEA), which is way to costly for RL applications.

shamilmamedov, 2022-06-08:
I see, thank you! I will close the issue for now.

shamilmamedov, 2022-06-08:
Closed too early :sweat_smile:

I installed Jiminy using `pip install` and while running tutorial with simple pendulum I get a segmentation fault error. What could be the reason? I have ROS (that uses EigenPy) and Pinocchio installed on my PC. Could there be conflicts between Pinocchio and Jiminy? How can I solve it?

On the positive side, I can successfully run an example on Google Colab. I created a URDF file with single active revolute joint and 3 fixed joints to simulate flexibilities. Then I defined `enableFlexibleModel` for one of them and tried to simulate the system. To this end I have a couple of question:

1. Is every flexible joint modeled as 3DOF spring? Can't I define only 1DOF spring?
2. What are states of a spring? Is it quaternion + ? Can choose spring positions ($q_s$) and velocities ($\dot q$) as states?

duburcqa, 2022-06-08:
> What could be the reason? I have ROS (that uses EigenPy) and Pinocchio installed on my PC. Could there be conflicts between Pinocchio and Jiminy?

Yes definitely, you need to use the same version that the one used to compile jiminy, or to compile jiminy yourself (which is quite straightforward). The right versions for the master branch are `robotpkg-py3*-eigenpy=2.6.4 robotpkg-py3*-hpp-fcl=1.7.4r2 robotpkg-py3*-pinocchio=2.6.1`, and for the dev branch `robotpkg-py3*-eigenpy=2.7.6 robotpkg-py3*-hpp-fcl=1.8.1 robotpkg-py3*-pinocchio=2.6.7`.

> Is every flexible joint modeled as 3DOF spring?

Yes, but it should be the same since there is no forces applied in the two other directions (orthogonal to gravity according to your figure).

> What are states of a spring? Is it quaternion + ? Can choose spring positions () and velocities (
) as states?

It follows pinocchio paradigm, so a quaternion (4 components) and a angular velocity (3 components).

shamilmamedov, 2022-06-10:
@duburcqa, thank you for your answer. I will gladly share my notebook once it works.

Sorry for bothering but I have new questions, I hope you can help me out.

Based on your previous comments I implemented a toy example, but can't simulate it, I get `RuntimeError: The simulation failed` without any hint on the source of failure. Here is an URDF file I used

    <?xml version="1.0"?>
    <robot name="flexible_arm">

    <!-- world -->
    <link name="world"/>

    <!-- flexible arm modeled using virtual link method -->
    <link name="link1">
      <visual>
        <origin rpy="0 0 0" xyz ="0.05 0 0"/>
        <geometry>
          <box size="0.1 0.025 0.01"/>
        </geometry>
      </visual>
      <collision>
        <origin rpy="0 0 0" xyz ="0.05 0 0"/>
        <geometry>
          <box size="0.1 0.025 0.01"/>
        </geometry>
      </collision>
      <inertial>
        <origin xyz="0.05 0 0" rpy="0 0 0"/>
        <mass value="0.8" />
        <inertia ixx="0" ixy="0" ixz="0" iyy="0" iyz="0" izz="0.002" />
      </inertial>
    </link>

    <joint name="base_to_link1" type="revolute">
      <parent link="world"/>
      <child link="link1"/>
      <axis xyz="0 0 1"/>
      <origin xyz="0 0 0" rpy="1.57 0 0"/>
      <limit effort="100.0" lower="-3.14159" upper="3.14159" velocity="3.14"/>
    </joint>

    <link name="link2">
      <visual>
        <origin rpy="0 0 0" xyz ="0.05 0 0"/>
        <geometry>
          <box size="0.1 0.025 0.01"/>
        </geometry>
      </visual>
      <collision>
        <origin rpy="0 0 0" xyz ="0.05 0 0"/>
        <geometry>
          <box size="0.1 0.025 0.01"/>
        </geometry>
      </collision>
      <inertial>
        <origin xyz="0.05 0 0" rpy="0 0 0"/>
        <mass value="0.8" />
        <inertia ixx="0" ixy="0" ixz="0" iyy="0" iyz="0" izz="0.002" />
      </inertial>
    </link>

    <joint name="link1_to_link2" type="fixed">
      <parent link="link1"/>
      <child link="link2"/>
      <axis xyz="0 0 1"/>
      <origin xyz="0.1 0 0" rpy="0 0 0"/>
      <limit effort="100.0" lower="-3.14159" upper="3.14159" velocity="3.14"/>
    </joint>

  </robot>

And a python code

    # Instantiate a robot
    fa_urdf_path = 'flexible_arm_jiminy.urdf'
    fa = jiminy.Robot()
    fa.initialize(fa_urdf_path, has_freeflyer=False)

    # Add motor
    motor_joint_name = 'base_to_link1'
    motor = jiminy.SimpleMotor(motor_joint_name)
    fa.attach_motor(motor)
    motor.initialize(motor_joint_name)

    # Specify joint flexibility parameters
    model_options = fa.get_model_options()
    model_options['dynamics']['enableFlexibleModel'] = True
    model_options['dynamics']['flexibilityConfig'] = [{
        'frameName': 'link1_to_link2',
        'stiffness': 10.*np.ones(3),
        'damping': 1.*np.ones(3),
        'inertia': np.zeros(3)
    }]
    fa.set_model_options(model_options)

    # Instantiate and initialize the controller
    fa_controller = jiminy.ControllerFunctor()
    fa_controller.initialize(fa)

    # Create a simulator using this robot and controller
    simulator = Simulator(fa, fa_controller)

    # Set initial condition and simulation length
    q0 = np.array([0., 0., 0., 1.])
    v0 = np.array([0., 0., 0.])

    print(f"q0 = {q0}")
    print(f"v0 = {v0}")
    simulation_duration = 10.0

    # Launch the simulation
    simulator.simulate(simulation_duration, q0, v0)

Am I missing something trivial? I tried to go through unittests to see how you simulate flexibility and didn't find anything useful for solving my problem.

duburcqa, 2022-06-11:
If you use `jupyter-notebook` or similar, unfortunately `std::err` is forwarded to the terminal running it instead of the frontend. So you only see part of the message (the one written in native python) without the backtrace. To fix it, you need to install `wurlitzer` and load it into your notebook doing `%load_ext wurlitzer`. I will make it automatic in future release once it is supported  on Windows.

You get none of the links have non-zero inertia along x and y principal axes, which is problematic if the flexibility is enabled because it could in theory rotate around them, even though it is never going to be the case by design. I will check if it is possible to fix it. If not, I will have a look to adding single-dof flexibility model as option.

duburcqa, 2022-06-11:
After having a closer look to the issue, I think the best approach is just to set the armature inertia of the deformation points to a value larger than 0 on x axis, ie 1.

shamilmamedov, 2022-06-11:
Thanks a lot @duburcqa now I see `std::err` messages. I was able to run simulation by changing inertial parameters of the links (set X and Y diagonal elements to 1) and passing only rigid joint states. If I pass both rigid and flexible joints states I get an error:

    In /__w/jiminy/jiminy/core/src/robot/Model.cc:1738: In jiminy::Model::getFlexibleConfigurationFromRigid:
    error: Size of qRigid inconsistent with theoretical model.

But I saw in your unit tests that you pass all the states. How come I can't do the same?

Another question: do you have any function that retrieves joint angles of the spherical flexible joints from quaternion?

duburcqa, 2022-06-11:
I found the root cause of the compounding of errors, your approximation of `pi/2` in the URDF file is not precise enough, you should rather use something like `1.57079632679489661923`.

This part of the code is not properly tested for now, and your use case exhibits a bunch of bugs that I'm currently fixing (mainly affecting the visualization). I will write a unit test based on it if I have time to do it.

> If I pass both rigid and flexible joints states I get an error: [...]

It is because your initial is just wrong, it should be `q0 = np.array([0., 0., 0., 0., 1.])` and `v0 = np.array([0., 0., 0., 0.])` because you have one actual revolute joint and a quaternion.

Another approach is to always provide the rigid state and let the simulator put the zero the deformation points:
```
q0 = np.array([0.])
v0 = np.array([0.])
simulator.simulate(simulation_duration, q0, v0, is_state_theoretical=True)
```

> Another question: do you have any function that retrieves joint angles of the spherical flexible joints from quaternion?

Yes,
```
from gym_jiminy.toolbox.math import quat_to_yaw

q = simulator.system_state.q
flex_angles = []
for joint_idx in joint in fa.pinocchio_model.joints:
     idx_q = fa.pinocchio_model.joints[joint_idx].idx_q
     flex_angles.append(quat_to_yaw(q[idx_q:(idx_q+4)]))
```

duburcqa, 2022-06-11:
PR https://github.com/duburcqa/jiminy/pull/535 fixes a bunch of bugs. I have this complete example working:
```
<?xml version="1.0"?>
<robot name="flexible_arm">
  <!-- world -->
  <link name="world"/>

  <!-- flexible arm modeled using virtual link method -->
  <link name="link1">
    <visual>
      <origin rpy="0 0 0" xyz ="0.05 0 0"/>
      <geometry>
        <box size="0.1 0.025 0.01"/>
      </geometry>
      <material name="">
        <color rgba="1.0 0.0 0.0 1.0"/>
      </material>
    </visual>
    <inertial>
      <origin xyz="0.05 0 0" rpy="0 0 0"/>
      <mass value="0.8" />
      <inertia ixx="0" ixy="0" ixz="0" iyy="0" iyz="0" izz="0.002" />
    </inertial>
  </link>

  <joint name="base_to_link1" type="revolute">
    <parent link="world"/>
    <child link="link1"/>
    <axis xyz="0 0 1"/>
    <origin xyz="0 0 0" rpy="1.57079632679489661923 0 0"/>
    <limit effort="100.0" lower="-3.14159" upper="3.14159" velocity="3.14"/>
  </joint>

  <link name="link2">
    <visual>
      <origin xyz ="0.05 0 0" rpy="0 0 0"/>
      <geometry>
        <box size="0.1 0.025 0.01"/>
      </geometry>
      <material name="">
        <color rgba="0.0 1.0 0.0 1.0"/>
      </material>
    </visual>
    <inertial>
      <origin xyz="0.05 0 0" rpy="0 0 0"/>
      <mass value="0.8" />
      <inertia ixx="0" ixy="0" ixz="0" iyy="0.0" iyz="0" izz="0.002" />
    </inertial>
  </link>

  <joint name="link1_to_link2" type="fixed">
    <parent link="link1"/>
    <child link="link2"/>
    <origin xyz="0.1 0 0" rpy="0 0 0"/>
  </joint>

  <link name="link3">
    <visual>
      <origin xyz ="0.05 0 0" rpy="0 0 0"/>
      <geometry>
        <box size="0.1 0.025 0.01"/>
      </geometry>
      <material name="">
        <color rgba="0.0 0.0 1.0 1.0"/>
      </material>
    </visual>
    <inertial>
      <origin xyz="0.05 0 0" rpy="0 0 0"/>
      <mass value="0.8" />
      <inertia ixx="0" ixy="0" ixz="0" iyy="0" iyz="0" izz="0.002" />
    </inertial>
  </link>

  <joint name="link2_to_link3" type="fixed">
    <parent link="link2"/>
    <child link="link3"/>
    <origin xyz="0.1 0 0" rpy="0 0 0"/>
  </joint>

  <link name="link4">
    <visual>
      <origin xyz ="0.05 0 0" rpy="0 0 0"/>
      <geometry>
        <box size="0.1 0.025 0.01"/>
      </geometry>
      <material name="">
        <color rgba="1.0 0.0 1.0 1.0"/>
      </material>
    </visual>
    <inertial>
      <origin xyz="0.05 0 0" rpy="0 0 0"/>
      <mass value="0.8" />
      <inertia ixx="0" ixy="0" ixz="0" iyy="0" iyz="0" izz="0.002" />
    </inertial>
  </link>

  <joint name="link3_to_link4" type="fixed">
    <parent link="link3"/>
    <child link="link4"/>
    <origin xyz="0.1 0 0" rpy="0 0 0"/>
  </joint>
</robot>
```

```
import numpy as np
import jiminy_py.core as jiminy
from jiminy_py.simulator import Simulator

# Instantiate a robot
fa_urdf_path = 'flexible_arm_jiminy.urdf'
fa = jiminy.Robot()
fa.initialize(fa_urdf_path, has_freeflyer=False)

# Add motor
motor_joint_name = 'base_to_link1'
motor = jiminy.SimpleMotor(motor_joint_name)
fa.attach_motor(motor)
motor.initialize(motor_joint_name)

# Specify joint flexibility parameters
model_options = fa.get_model_options()
model_options['dynamics']['enableFlexibleModel'] = True
model_options['dynamics']['flexibilityConfig'] = [
    {'frameName': 'link1_to_link2',
     'stiffness': .1 * np.ones(3),
     'damping': .1 * np.ones(3),
     'inertia': np.array([1.0, 1.0, 0.0])},
    {'frameName': 'link2_to_link3',
     'stiffness': .1 * np.ones(3),
     'damping': .1 * np.ones(3),
     'inertia': np.array([1.0, 1.0, 0.0])},
    {'frameName': 'link3_to_link4',
     'stiffness': .1 * np.ones(3),
     'damping': .1 * np.ones(3),
     'inertia': np.array([1.0, 1.0, 0.0])}
]
fa.set_model_options(model_options)

# Instantiate and initialize the controller
fa_controller = jiminy.ControllerFunctor()
fa_controller.initialize(fa)

# Create a simulator using this robot and controller
simulator = Simulator(fa, fa_controller)

# Configure the integrator
# engine_options = simulator.engine.get_options()
# engine_options['stepper']['odeSolver'] = 'euler_explicit'
# engine_options['stepper']['dtMax'] = 0.001
# simulator.engine.set_options(engine_options)

# Set initial condition and simulation length
q0 = np.array([0.])
v0 = np.array([0.])

print(f"q0 = {q0}")
print(f"v0 = {v0}")
simulation_duration = 5.0

# Launch the simulation
simulator.simulate(simulation_duration, q0, v0, is_state_theoretical=True)
```

duburcqa, 2022-06-12:
The PR https://github.com/duburcqa/jiminy/pull/536 is adding unit tests to make sure it keeps working in the future. It should be merged on dev branch soon.

shamilmamedov, 2022-06-13:
Thank you very much for looking deeply into my issue. How can I use your latest changes in Jiminy? Do I need to pull devel branch and install it using `setup.py` or `python3 -m pip install --prefer-binary jiminy-py[meshcat,plot]` will suffice?

About initial state: even if I initialize it correctly with `q0 = np.array([np.pi/4, 0., 0., 0., 1.])` and
`v0 = np.array([0., 0., 0., 0.])` the simulator crashes.

duburcqa, 2022-06-13:
> Do I need to pull devel branch and install it using setup.py or python3 -m pip install --prefer-binary jiminy-py[meshcat,plot] will suffice?

No, you need to follow the procedure to described in the documentation, or one of the [CI scripts](https://github.com/duburcqa/jiminy/tree/master/.github/workflows).

> the simulator crashes.

What is the error message ? You mean segfault ?

You cannot do `command = Kp*(q_ref - q) - Kd*v` because in python it means "overwrite the address this pointer is referring to by the one I'm providing  you". It is never doing anything else in Python. In your case, you need to set the value not the pointer, so you need to do `command[:] = Kp*(q_ref - q) - Kd*v`.

> I get broadcasting issues.

And yes you will get broadcasting issues because here `q` and `v` are associated with the full state, not the rigid one. You need to use the helper methods `robot.get_rigid_configuration_from_flexible` (and for velocity) before computing the command. Or even better, add a encoder sensor on the actuated joint, and use its data (position and velocity) to compute the command !

Here is a goody just for the fun:
https://user-images.githubusercontent.com/17752950/173436297-9f3c1151-39f3-4fbf-a1df-81acf7b2b634.mp4

duburcqa, 2022-06-14:
To get the last update, either you need to install to follow the instruction to build from source and checkout the dev branch, or you can just install the precompiled wheel available [here](https://github.com/duburcqa/jiminy/actions/runs/2493897647). Just unpack the "wheelhouse" artefacts and run:
```
python3 -m pip install --prefer-binary --find-links=wheelhouse jiminy_py[meshcat,plot]
```

> When specifying flexible link states I get

Do you have a complete example ? Because I'm quite sure there is no bug here.

> Another question about controller: it is possible to pass time varying reference to it?

Yes, just create a proper controller rather than a simple callback, and use the time to fetch the right reference. You need to inherit from `jiminy.BaseController` and overload `compute_command`. You have an "example" [here](https://github.com/duburcqa/jiminy/blob/master/python/gym_jiminy/common/gym_jiminy/common/envs/internal/controller.py).

> I get a couple of warnings ipykernel version and then the environment is opened as an output of the cell, the robot is in final configuration. When I want to stop the cell running kernel crushes. How can I solve it?

I think I have fixed those issues in the dev branch. Can you check if it works ?

shamilmamedov, 2022-06-14:
I followed your instructions about getting the latest updates using "wheelhouse" but still notebook crashes while visualizing the robots motion. [Here](https://colab.research.google.com/drive/1stCsJ-_FdUHh84BXb3eEn7iElmaU-h4z?usp=sharing) is the notebook I use, you can copy it and run to reproduce the issue.

duburcqa, 2022-06-14:
First, you need to disable the browser tracking protection of firefox to make it work. But on my side it does not manage to connect to ipython for some reason.  I will have a look to see if I can do something about it.

duburcqa, 2022-06-15:
I think I found the issue with Google colab. I should be able to fix it soon.

shamilmamedov, 2022-06-15:
Where do I need to set `backend="panda3d-sync"`? In simulator?

A question about simulator: before stumbling upon the Jiminy I wrote very small ad-hoc simulator for the flexible arm; there I also use pinocchio as a backend. In my code a robot is described using a URDF where passive joint that approximate flexibility of the link are revolute joints as well. In ODE to compute accelerations I call forward dynamics algorithm (aba) in pinocchio by passing joints positions, velocities and a torque vector  $\tau = \(\tau_a; \tau_p\)$  where `tau_a` is a torque of an active joint provided by a controller and  $\tau_p = - K q_p - D \dot q_p$ is spring-damper torque. `tau_a` is updated according to controller update period, while `tau_p` is continuous. Then in a loop I integrate the system starting from an initial condition using  scipy's `solve_ivp`.

Once I had the Jiminy simulator running I wanted to compare its solution with mine simulators solution. All the conditions were the same: URDF is the same, controllers are the same . But, unfortunately, trajectories do not coincide, for example, the motion of flexible joints differ by an order of magnitude. I have been trying to find a bug in my code, but I haven't so far. How can I make sure that Jiminy provides correct solution? I can provide a link to my simulator if you need it.

What I found strange about Jiminy's solution is that in steady state when the active joint is rotated by `pi/4` radians, all the passive joints (flexibility joints) have the same reading. But gravity acts on them differently, joints that are closer to the base should have bigger deflection because it bears more load. Correct me if I am wrong.

duburcqa, 2022-06-15:
> Where do I need to set backend="panda3d-sync"? In simulator?

in `simulator.replay`

> How can I make sure that Jiminy provides correct solution? I can provide a link to my simulator if you need it.

First of all, you should configure both integrator to use the simple euler explicit schema. Jiminy is using the adaptive stepper Runge Kutta Dopri 5 by default. It is also possible to use RK45, which is fixed step but more complex that Euler Explicit. I would say the simpler the better. Yet It would be helpful if you could provide your simulator.

> What I found strange about Jiminy's solution is that in steady state when the active joint is rotated by pi/4 radians, all the passive joints (flexibility joints) have the same reading.

Do you have a script to illustrate this ?

> But gravity acts on them differently, joints that are closer to the base should have bigger deflection because it bears more load.

Yes indeed. Strange. There is no magic in the simulation here, which you described quite precisely in your message already. So I'm a bit puzzled.

shamilmamedov, 2022-06-15:
The code for comparing trajectories in [here](https://github.com/shamilmamedov/flexible_arm/tree/jiminy) in the script `jiminy_vs_own.py`. To compare simulated trajectories I first run Jiminy simulator in [Colab](https://colab.research.google.com/drive/1stCsJ-_FdUHh84BXb3eEn7iElmaU-h4z?usp=sharing) (the one I sent yesterday) and save the solution in `data` folder; then I run script `jiminy_vs_own.py`. (I know it can be better than that :grinning: )

Unfortunately, `solve_ivp` doesn't have euler explicit schema, it uses by default RK45. I set `engine_options['stepper']['odeSolver'] = 'runge_kutta_4'` but the integrator exploded.

Let me know if you have any why simulated trajectories are so different.

duburcqa, 2022-06-15:
I have fixed the viewer in google colab. it is quite laggy but it works x) You need to update the ipykernel for it to work:
```
!pip install "ipykernel>=5,<6" > /dev/null
```

y the way, I suggest opening a view in one cell, and ask for replay in another one. This way, it will replay in the already existing cell, avoiding the open and close the view systematically, which is costly.

```
from jiminy_py.viewer import Viewer

Viewer.connect_backend()
Viewer.open_gui()
```
```
camera_xyzrpy = ([0.0, -1.5, 2.0e-5], [np.pi/2, 0.0, 0.0])
simulator.replay(camera_xyzrpy=camera_xyzrpy, speed_ratio=0.5)
```

duburcqa, 2022-06-15:
> but the integrator exploded.

Yes, you need to decrease the step size `dtMax` to use the same than your integrator.

shamilmamedov, 2022-06-15:
I have control `controllerUpdatePeriod = 0.001` in both simulators, I think it should limit integrators `dtMax`

duburcqa, 2022-06-15:
The snippet to record and show video:
```
from base64 import b64encode
from IPython.display import HTML

camera_xyzrpy = ([0.0, -1.5, 2.0e-5], [np.pi/2, 0.0, 0.0])
simulator.replay(camera_xyzrpy=camera_xyzrpy, record_video_path="video.mp4", backend="panda3d-sync")

mp4 = open('video.mp4','rb').read()
data_url = "data:video/mp4;base64," + b64encode(mp4).decode()
HTML("""
<video width=400 controls>
      <source src="%s" type="video/mp4">
</video>
""" % data_url)
```

> I have control controllerUpdatePeriod = 0.001 in both simulators, I think it should limit integrators dtMax

Yes it does, but 1ms is still to large without armature inertia, which is expected.

shamilmamedov, 2022-06-15:
Thank you for solving issues with a visualization. I will try it out tomorrow.

Regarding simulation: I decreased `dtMax` to `0.00025`, it converges but again all the positions of the flexible joints are the same.

duburcqa, 2022-06-15:
> Regarding simulation: I decreased dtMax to 0.00025, it converges but again all the positions of the flexible joints are the same.

Interesting. How can I check that myself ?

shamilmamedov, 2022-06-15:
By doing what I do  -- described [here](https://github.com/duburcqa/jiminy/issues/530#issuecomment-1156915903)

duburcqa, 2022-06-15:
Hum, I would say yes there is a mistake with your extract of the result. Because here is the video:
https://user-images.githubusercontent.com/17752950/173930194-0b609a2a-26b3-425d-b576-2a56d2cc1e29.mp4

shamilmamedov, 2022-06-15:
Here is a function I use for extracting flexible joint positions

    def get_flexible_joints_positions_from_log(log_data, fa):
        ns = log_data['Global.Time'].size
        nfj = len(fa.flexible_joints_names)
        qf = np.zeros((ns, nfj))
        for k, (fj_name, fj_idx) in enumerate(zip(fa.flexible_joints_names, fa.flexible_joints_idx)):
            quat = np.column_stack((log_data[f'HighLevelController.currentPosition{fj_name}QuatX'],
                                    log_data[f'HighLevelController.currentPosition{fj_name}QuatY'],
                                    log_data[f'HighLevelController.currentPosition{fj_name}QuatZ'],
                                    log_data[f'HighLevelController.currentPosition{fj_name}QuatW']))
            idx_q = fa.pinocchio_model.joints[fj_idx].idx_q
            for j in range(ns):
                qf[j,k] = quat_to_yaw(quat[j])
        return qf

duburcqa, 2022-06-15:
Your extract is ok, but it this example, the arm is almost right, presumably because the flexibility are much stronger. I think you cannot compare your stiffness with the one of jiminy easily. I will explain you why tomorrow but [here](https://github.com/duburcqa/jiminy/blob/d5e76c5d405b6084b45633cfc3c33eaa136da85d/core/src/engine/EngineMultiRobot.cc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) is the formula:
```
        // Compute the flexibilities (only support joint_t::SPHERICAL so far)
        Robot::dynamicsOptions_t const & mdlDynOptions = system.robot->mdlOptions_->dynamics;
        std::vector<jointIndex_t> const & flexibilityIdx = system.robot->getFlexibleJointsModelIdx();
        for (std::size_t i = 0; i < flexibilityIdx.size(); ++i)
        {
            jointIndex_t const & jointIdx = flexibilityIdx[i];
            uint32_t const & positionIdx =
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

Thread 531 (2022-06-02):

[core] Add backlash

duburcqa, 2022-06-02:
Bashlash can be implemented in the exact same way as flexible joints by a virtual joint with co-located with the true one and with the same DoFs. The "flexible" name should be generalized to distinguish the actual model from the theoretical one. For instance, just `true` versus `theoretical`. Getters (basically any utility) for the flexible model should be renamed accordingly.

duburcqa, 2024-04-29:
Fixed by https://github.com/duburcqa/jiminy/pull/767

Closed 2024-04-29.

Thread 546 (2022-07-01):

Adding position constraint

vcparedesc, 2022-07-01:
Hello,

I am trying to simulate a robot sitting on a chair by constraining a point in the robot to have its position fixed. Can I do this in Jiminy (C++) ?

Thanks!

duburcqa, 2022-07-01:
Hello,

Sure, if it is really what you want, just add a [FixedFrameConstraint](https://github.com/duburcqa/jiminy/blob/686977c798234cf4ed87907a76ca670798e1c36d/core/include/jiminy/core/constraints/FixedFrameConstraint.h)!

Nota Bene: I'm not sure it is the best approach, you could add a "ground" profile having the shape of a chair, and adding contact frame on the frames that are supposed to be in contact.

vcparedesc, 2022-07-02:
Thank you! I think I'll try the ground profile first since it seems more natural. I see I can follow the example in `box_uneven_ground_impulse_contact`, but do you have some documentation or directions for the hyper-parameters of the ground profile?

duburcqa, 2022-07-02:
In the near future, it will be possible to add objects such as a chair on the scene, but it is not possible for now. Same for mesh ground profile instead of implicit function. In the meantime, the ground profile must be a function taking x,y query coordinates as a vector3 (z is irrelevant here) and return a pair with the height and normal at this location.

vcparedesc, 2022-07-14:
I followed your advice and generated the following code, however I'm unable to visualize my new ground profile.

For C++ I added the following test profile:

```
  heightmapFunctor_t custom_ground_profile = [](vector3_t const & pos) -> std::pair<float64_t, vector3_t> {
    if(pos(0) > 0.3) {
      return {1.0,  vector3_t::UnitZ()};
    }else{
      return {0.0,  vector3_t::UnitZ()};
    }
  };

  boost::get<heightmapFunctor_t>(boost::get<configHolder_t>(simuOptions.at("world")).at("groundProfile")) = custom_ground_profile;
```

And, I wanted to visualize this in python, but couldn't figure out a way to use the HeightMapFunctor, what I tried is:
```

from jiminy_py.core import HeightmapFunctor

custom_ground_profile = lambda  position : (0, np.array([0, 0, 1])) if position[0] < 0.3 else (1, np.array([0, 0, 1]))
engine_options["world"]["groundProfile"] = HeightmapFunctor([custom_ground_profile])
engine.set_options(engine_options)
```

But that's not showing me a change in terrain when i call `play_logs_data`. Could you point me in the right direction?

Thanks

vcparedesc, 2022-07-14:
Thanks for the help!

I think the c++ ground profile works as the robot seats and keeps stability in place.
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

I tested using the ground profile of the `box_uneven_ground_impulse_contact.py` and I can visualize it, so using a viewer and forwarding it to `play_logs_data` is working for me.

However, since I can't visualize my custom ground profile, I think I'm doing something wrong writing the python call to he HeightMapFunction, I am doing this:

```
custom_ground_profile = lambda self,  px, py, pz : (0, np.array([0, 0, 1])) if px < 0.3 else (1, np.array([0, 0, 1]))
hmap = HeightmapFunctor(custom_ground_profile)

engine_options["world"]["groundProfile"] = hmap
engine.set_options(engine_options)
```
Do you have any suggestion to fix it?

Thanks

duburcqa, 2022-07-15:
Have you tried what I suggest with `update_floor` ? Do you have a more complete snippet to understand what is going wrong ?

duburcqa, 2022-07-15:
The signature of your ground profile in Python is wrong. It should be:
```
def custom_ground_profile(px, py, height, normal) :
    if px < 0.3:
        height[()] = 1.0
    else:
        height[()] = 0.0
    normal[:] = 0.0, 0.0, 1.0
```

vcparedesc, 2022-07-15:
I changed the ground profile as you suggested, and I can see my robot sitting :)

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

I did use your suggestions for 'update_floor'

```
from jiminy_py.viewer import Viewer

viewer = Viewer(robot)

viewer.update_floor(ground_profile, show_meshes=False)
play_logs_data(robot, log_data,
               speed_ratio=0.5,
               viewers=viewer,
               camera_xyzrpy=[(0.0, 7.0, 0.0), (np.pi/2, 0.0, np.pi)],
               delete_robot_on_close=False)
```

Thanks for the help.

duburcqa, 2022-07-15:
Nice ! Perfect. Are you using the latest release ? Because the rendering looks quite ugly.

vcparedesc, 2022-07-15:
I'm using Jiminy 1.7.4, I might update to the latest release, but for now this version was stable enough without investigating if some functions have changed wrt to newer versions.

duburcqa, 2022-07-15:
Ok yes I understand then. I improved the rendering quite recently. And yes the API is mostly stable.

Closed 2022-07-15.

Thread 548 (2022-07-04):

[core] Add smooth random ground profile generation

duburcqa, 2022-07-04:

duburcqa, 2024-07-13:
Fixed by https://github.com/duburcqa/jiminy/pull/799

Closed 2024-07-13.

Thread 556 (2022-08-08):

[core] Get rid of confusing `system` hierarchy

duburcqa, 2022-08-08:
Currently, the sensor and controller update periods are set at engine level, while it should be specific to every robots. It would be natural to move the controller as an attribute `Robot`, and request the user to the `setController` method (currently part of `EngineMultiRobot`) to set it on-the-fly.

This way, the notion of "system" can be removed altogether and replaced by "robot". The engine would still be responsible for calling the controller and its internal dynamics itself, but it is already the case for any physical quantity anyway.

To avoid any conflict or confusion, `getName` method of `Model` should be removed, in favor of manually accessing `name` attribute of `pinocchio_model`. The robots themselves as no name anymore apart from the ones the engine is giving to them to distinguish between them. This mechanism is different from the sensors and motors and maybe should be refactor. It seems more rationale to identity them from the name their owner is giving them since they are basically all identical.

In the same vein, registered forces should be named. Everything should return lists ordered by motors, sensors or rotor instead of a mix of unordered dicts and list as it is currently the case.

duburcqa, 2022-09-26:
After thinking about it. I suggest requirement naming robots, in the exact same way as sensors and motors. Being able to identify uniquely a robot after getting it without having to move around a reference to the engine is very convenient. Anyway, it does make sense that each robot owns its identity.

Closed 2024-02-21.

Thread 560 (2022-08-17):

Failures in engine while trying to run Environment

Le5tes, 2022-08-17:
Hi,
I'm trying to train an agent to run the Anymal Environment in jupyter notebook with python 3.8.10.

I'm getting this error in the notebook:
```
RuntimeError                              Traceback (most recent call last)
<ipython-input-58-238be5bf9bbb> in <module>

---> 18     env.step(action)

~/.local/lib/python3.8/site-packages/gym_jiminy/common/envs/env_generic.py in step(self, action)
    745
    746         # Perform a single simulation step
--> 747         self.simulator.step(self.step_dt)
    748
    749         # Update shared buffers

~/.local/lib/python3.8/site-packages/jiminy_py/simulator.py in step(self, step_dt)
    404         return_code = self.engine.step(step_dt)
    405         if return_code != jiminy.hresult_t.SUCCESS:
--> 406             raise RuntimeError("Failed to perform the simulation step.")
    407
    408     def simulate(self,

RuntimeError: Failed to perform the simulation step.
```

And I'm getting this error printed to the terminal:
```
In /__w/jiminy/jiminy/core/src/engine/EngineMultiRobot.cc:2242: In jiminy::EngineMultiRobot::step:
error: Too many successive iteration failures. Probably something is going wrong with the physics. Aborting integration.
```

Simple code to reproduce (you may have to run a few times)
```
from gym_jiminy.envs import ANYmalJiminyEnv

env = ANYmalJiminyEnv()

env.reset()

for i in range(1000):
    action = env.action_space.sample()
    env.step(action)

print('do I get here?')

```

duburcqa, 2022-08-17:
Indeed there is an issue. I think it comes from the contact model that is based by default on collision geometries instead of frames. The former is supposed to be more realistic but untested for now and numerically unstable model. I'm going to rework internally this part of the engine in a near future to handle generic collisions (collisions of all bodies with the ground plus auto-collisions).

duburcqa, 2022-08-18:
I see you did some work based on jiminy [here](https://github.com/Le5tes/robot-reinforcement-learning). If you have any question or want me to give you some advice / code review, do not hesitate. The documentation of jiminy is quite poor and providing a comprehensive tutorial would be amazing !

Le5tes, 2022-08-18:
Thanks!
Yes, it's an assignment for a Master's. Once we're finished I'm happy to make a tutorial from it. :)

duburcqa, 2022-08-18:
So, in the end do you need me to release a new version fixing the issue or you are planning to overwrite the base configuration manually?

Le5tes, 2022-08-18:
I overwrote the base configuration in my downloaded version of the package, so no worries!

duburcqa, 2022-08-18:
Perfect !

duburcqa, 2022-08-19:
There is one PID controller per motor. Each of them are responsible for the sending actual torque based on the error between the current and target state for the motors. More details are available [here](https://en.wikipedia.org/wiki/PID_controller). In this case, the action is no longer the torque directly, but the target state of each motor. These low-level PID controllers are supposed to update the current torque at a higher rate than the action. More information about why doing this is important can be found in the sub-section about the action space of my preprint [available on arxiv](https://arxiv.org/pdf/2203.01148.pdf).

For simplicity, I advice you to only ignore completely the target velocity and set it to zero systematically, so that the policy only output the desired position of the motors and not the combination of both position and velocity.

SDJoeKing, 2022-08-19:
Thank you very much for your swiftly response! I will give that a try.

Get Outlook for Android<https://aka.ms/AAb9ysg>
________________________________
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

Closed 2022-08-27.

Thread 598 (2023-03-17):

Feature Request: migrate from gym to gymnasium

elliottower, 2023-03-17:
Hi, would it be possible for jiminy to be upgraded from gym to gymnasium? Gymnasium is the maintained version of openai gym and is compatible with current RL training libraries ([rllib](https://github.com/ray-project/ray/tree/master/rllib) and [tianshou](https://github.com/thu-ml/tianshou) have already migrated, and [stable-baselines3](https://github.com/DLR-RM/stable-baselines3/blob/e5deeed16efb57c34ccdcb14692439154d970527/docs/guide/install.rst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) will soon).

This repository is currently listed in the gymnasium [third party environments](https://gymnasium.farama.org/environments/third_party_environments/) but we are cleaning the list up to only include maintained gymnasium-compatible repositories.

For information about upgrading and compatibility, see [migration guide](https://gymnasium.farama.org/content/migration-guide/) and [gym compatibility](https://gymnasium.farama.org/content/gym_compatibility/).

duburcqa, 2023-03-18:
I want to migrate to gymnasium but i'm wanting for stable baselines3 to release à compatible version. For now, gym is the only version that is compatible with all the frameworks you mentioned. Regarding gymnasium there is already an issue since the version is pinned to 0.26.3 while it is pinned to 0.26.2 by the future release of stable-baselines3...

elliottower, 2023-03-21:
> I want to migrate to gymnasium but i'm wanting for stable baselines3 to release a compatible version. For now, gym is the only version that is compatible with all the frameworks you mentioned. Regarding gymnasium there is already an issue since the version is pinned to 0.26.3 while it is pinned to 0.26.2 by the future release of stable-baselines3...
>
> But for sure jiminy is actively maintained and most use-cases imply gym/gymnasium.

I don’t believe sb3’s gymnasium compatibility is pinned to a specific version, if you look through the files changes by the PR, it doesn’t seem specific to any version. I’ve tested it in my own use cases and found no issues, not sure about the timeline for it getting merged though as it’s a draft currently and has been for a while. https://github.com/DLR-RM/stable-baselines3/pull/1327/files

But makes sense to wait until things are officially compatible and simply use older versions of the libraries and gym until then, just figured I’d post in case it wasn’t on your radar.

duburcqa, 2023-03-21:
After checking again, current it is pinned to the `main` branch. Which is not any better than before. In `setup.py`:
```
"gymnasium @ git+https://github.com/Farama-Foundation/Gymnasium@main",
```

Thread 599 (2023-03-21):

[core] Add support of state aggregation and transmission constraints

duburcqa, 2023-03-21:
Transmissions, motors and even sensors may have some dynamic state that should be aggregated. Typically, the current-voltage regulation loop of DC motors, or the generic n-to-m transmissions. As such, it should provide an `integrate` method for position,velocity and our custom liegroup algebra implementation should rely on it instead of calling `pinocchio::integrate`, which is an easy refactor.

Note that the robot still do not have to manage its own global state, but it should provide `computeForwardKinematics`  in place of the engine as it is current the case, but this should also be an easy refactor. The engine will still ilmplement its own `computeAllTerms`  handling coupling forces and external. Yet, the computation of internal forces should be moved to `computeForwardKinematics`. Finally, `Robot` should provide its own `neutral` method (along with `nq`, `nv` corresponding to the full state) and `robot.modelConfigSelector(q)`,`robot.modelVelocitySelector(v)  to extract the position,velocity corresponding to the pinocchio model currently in used (flexible or not).

The joint bounds should no longer be registered and handled by the engine but rather delegated to the transmission. Each transmission should take care of enabling/disabling the related constraint if any and necessary. All the constraints extrinsic to a robot (i.e. with the environment or another robot) would still be managed by the robot but enable/disabled by the engine since it is the only one having access to the necessary information.

Concurrently, transmissions should be able to register constraints to the robot.

Thread 600 (2023-03-21):

[core] Remove all `...All()` methods from sensors and motors.

duburcqa, 2023-03-21:
The data holders (`SensorSharedDataHolder_t` ...) should be refactored to be actual classes managing set of sensors and as such be friend of the corresponding abstract class (`AbstractSensorBase` ...). It should provide methods operating on all sensors in the holder at once (`get`, `setOptions` ...) and being renamed accordingly (`SensorManager_t` ...).

duburcqa, 2024-02-02:
Ideally, it should be possible to instantiate standalone sensors without shared storage, then update and fetch sensor measurement in isolation. The manager should only be helper that provides a bunch of optimised routines to process a ground a consistent sensors at once. It should not have to rely on private methods. It would be nice if the said manager could be completely independent from the shared storage but it actually comes together since it only makes sense if shared storage is enabled in the first place.

Thread 601 (2023-03-21):

[core] Add notion of algebra to sensor and proper sensor bias.

duburcqa, 2023-03-21:
Currently, a euclidean linear interpolation is used systematically for all sensors. The proper lie algebra interpolation method should be used (typically it makes sure that quaternion data is properly normalized). This could be implemented easily by providing the lie algebra of the sensor as static const member. Beside, this lie algebra should be used to normalized the measured sensor data at the very end to handle noise.

Another issue is the implementation of the bias. Currently, it propagates independently on all sensor components. This is wrong for IMU sensor, where the quaternion bias can be interpreted as a misplacement of the sensor itself, which means that the sensor is actually fixed at a fictitious frame that differs from the theoretical one and measuring all quantities that this point. I suggest dealing with this issue by adding a new `addBias` method that would be called internally by `measureData` and could be overloaded by the user if necessary.

Thread 602 (2023-03-31):

[viewer] Add Open3d backend

duburcqa, 2023-03-31:
Open3d has the potential to replace both meshcat and panda3d. It seems to surpass them on many aspects. First, it has native web and notebook (the official way, without any hack) in addition to classical standalone window. Next, it seems to better support non-nvidia GPU machines. Besides, it is well maintained and not bloated by physics engine aspect such as Panda3d. It would be interesting to compare the performance wrt panda3d, especially during offscreen rendering. Here is a snippet for loading meshes (stl or dae) in Open3d 0.17:
```bash
python3 -m pip install open3d-cpu gym_jiminy_zoo pycollada
```
```python
import os
import warnings
from pkg_resources import resource_filename
from typing import Optional

import numpy as np

import trimesh
import trimesh.viewer
import open3d as o3d
import open3d.visualization as vis

import gym
import jiminy_py
import hppfcl
import pinocchio as pin

# vis.webrtc_server.enable_webrtc()

def make_capsule(radius: float,
                 length: float,
                 num_segments: int = 16,
                 num_rings: int = 16
                 ) -> o3d.t.geometry.TriangleMesh:
    vertices, normals = [], []
    for u in np.linspace(0, np.pi, num_rings):
        for v in np.linspace(0, 2 * np.pi, num_segments):
            x, y, z = np.cos(v) * np.sin(u), np.sin(v) * np.sin(u), np.cos(u)
            offset = np.sign(z) * 0.5 * length
            vertices.append((x * radius, y * radius, z * radius + offset))
            normals.append((x, y, z))

    faces = []
    for i in range(num_rings - 1):
        for j in range(num_segments - 1):
            r0 = i * num_segments + j
            r1 = r0 + num_segments
            if i < num_rings - 2:
                faces.append((r0, r1, r1 + 1))
            if i > 0:
                faces.append((r0, r1 + 1, r0 + 1))

    mesh = o3d.t.geometry.TriangleMesh()
    mesh.vertex.positions = o3d.core.Tensor(vertices, o3d.core.float32)
    mesh.vertex.normals = o3d.core.Tensor(normals, o3d.core.float32)
    mesh.triangle.indices = o3d.core.Tensor(faces, o3d.core.int32)

    return mesh

def load_mesh_file(mesh_path: str,
                   scale: Optional[np.ndarray] = None
                   ) -> o3d.t.geometry.TriangleMesh:
    mesh = trimesh.load(mesh_path, force='mesh')

    mesh_o3d = o3d.t.geometry.TriangleMesh()
    mesh_o3d.vertex.positions = o3d.core.Tensor(mesh.vertices, o3d.core.float32)
    mesh_o3d.triangle.indices = o3d.core.Tensor(mesh.faces, o3d.core.int32)
    mesh_o3d.compute_vertex_normals()

    mesh_o3d.material.set_default_properties()
    mesh_o3d.material.material_name = 'defaultLit'
    if isinstance(mesh.visual, trimesh.visual.color.ColorVisuals):
        vertex_colors = mesh.visual.vertex_colors
        if vertex_colors is not None:
            mesh_o3d.vertex.colors = o3d.core.Tensor(
            np.divide(vertex_colors[:, :3], 255), o3d.core.float32)
        face_colors = mesh.visual.face_colors
        if face_colors is not None:
            mesh_o3d.triangle.colors = o3d.core.Tensor(
            np.divide(face_colors[:, :3], 255), o3d.core.float32)
    if isinstance(mesh.visual, trimesh.visual.texture.TextureVisuals):
        texture_uvs = mesh.visual.uv
        mesh_o3d.vertex.texture_uvs = o3d.core.Tensor(texture_uvs, o3d.core.float32)
        if isinstance(mesh.visual.material, trimesh.visual.material.PBRMaterial):
            texture = mesh.visual.material.baseColorTexture
            if texture is not None:
                mesh_o3d.material.texture_maps['albedo'] = o3d.t.geometry.Image(
                    o3d.core.Tensor(np.asarray(texture), o3d.core.uint8))
            roughness = mesh.visual.material.roughnessFactor
            if roughness is not None:
                mesh_o3d.material.scalar_properties['roughness'] = roughness
            base_color = mesh.visual.material.baseColorFactor
            if base_color is not None:
                mesh_o3d.material.vector_properties['base_color'][:] = np.divide(
                    base_color, 255)
            metallic = mesh.visual.material.metallicFactor
            if metallic is not None:
                mesh_o3d.material.scalar_properties['metallic'] = metallic

    if scale is not None:
        mesh_o3d.vertex.positions *= o3d.core.Tensor(scale, o3d.core.float32)

    return mesh_o3d

def load_geometry_object(geometry_object: pin.GeometryObject,
                         color: Optional[np.ndarray] = None
                         ) -> Optional[o3d.t.geometry.TriangleMesh]:
    """Load a single geometry object
    """
    # Extract geometry information
    geom = geometry_object.geometry
    mesh_path = geometry_object.meshPath
    texture_path = ""
    if geometry_object.overrideMaterial:
        # Get material from URDF. The color is only used if no texture or
        # if its value is not the default because meshColor is never unset.
        if os.path.exists(geometry_object.meshTexturePath):
            texture_path = geometry_object.meshTexturePath
        if color is None and (not texture_path or any(
                geometry_object.meshColor != [0.9, 0.9, 0.9, 1.0])):
            color = geometry_object.meshColor

    # Try to load mesh from path first
    is_success = True
    if os.path.exists(mesh_path):
        mesh = load_mesh_file(mesh_path, geometry_object.meshScale)
    else:
        # Each geometry must have at least a color or a texture
        if color is None and not texture_path:
            color = np.array([0.75, 0.75, 0.75, 1.0])

        # Append a primitive geometry
        if isinstance(geom, hppfcl.Capsule):
            mesh = make_capsule(geom.radius, 2.0 * geom.halfLength)
        elif isinstance(geom, hppfcl.Cylinder):
            mesh = o3d.t.geometry.TriangleMesh.create_cylinder(
                geom.radius, 2*geom.halfLength)
        elif isinstance(geom, hppfcl.Cone):
            mesh = o3d.t.geometry.TriangleMesh.create_cylinder(
                geom.radius, 2*geom.halfLength)
        elif isinstance(geom, hppfcl.Box):
            mesh = o3d.t.geometry.TriangleMesh.create_box(*(2.0*geom.halfSide))
        elif isinstance(geom, hppfcl.Sphere):
            mesh = o3d.t.geometry.TriangleMesh.create_sphere(geom.radius)
        elif isinstance(geom, (hppfcl.Convex, hppfcl.BVHModelBase)):
            # Extract vertices and faces from geometry
            if isinstance(geom, hppfcl.Convex):
                vertices = geom.points()
                num_faces, get_faces = geom.num_polygons, geom.polygons
            else:
                vertices = geom.vertices()
                num_faces, get_faces = geom.num_tris, geom.tri_indices
            faces = np.empty((num_faces, 3), dtype=np.int32)
            for i in range(num_faces):
                tri = get_faces(i)
                for j in range(3):
                    faces[i, j] = tri[j]

            # Return immediately if there is nothing to load
            if num_faces == 0:
                return None

            # Create primitive triangle geometry
            mesh = o3d.t.geometry.TriangleMesh()
            mesh.vertex.positions = o3d.core.Tensor(vertices, o3d.core.float32)
            mesh.triangle.indices = o3d.core.Tensor(faces, o3d.core.int32)
            mesh.compute_vertex_normals()
        else:
            is_success = False
        if is_success:
            mesh.material.set_default_properties()
            mesh.material.material_name = 'defaultLit'

    # Early return if impossible to load the geometry for some reason
    if not is_success:
        warnings.warn(
            f"Unsupported geometry type for {geometry_object.name} "
            f"({type(geom)})", category=UserWarning, stacklevel=2)
        return None

    # Set material
    if texture_path:
        mesh.material.texture_maps['albedo'] = o3d.io.read_image(texture_path)
    if color is not None:
        mesh.material.vector_properties['base_color'] = np.divide(
            color, 255, dtype=np.float32)

    return mesh

# data_root_dir = resource_filename("gym_jiminy.envs", "data/bipedal_robots/atlas")
# mesh = load_mesh_file(os.path.join(data_root_dir, "meshes/utorso.dae"))
# vis.draw([mesh])

env = gym.make("gym_jiminy.envs:atlas-v0")
env.reset()
# env.render()
# env.viewer.display_collisions(True)
for model, data in (
        # (env.robot.collision_model, env.robot.collision_data),
        (env.robot.visual_model, env.robot.visual_data),
    ):
    meshes = {
        geom.name: load_geometry_object(geom) if geom.name != "ground" else None
        for geom in model.geometryObjects}
    for mesh, oMg in zip(meshes.values(), data.oMg):
        if mesh is not None:
            mesh.transform(oMg.homogeneous)
    # window = vis.Visualizer()
    # for name, mesh in meshes.items():
    #     if mesh is not None:
    #         window.add_geometry(name, mesh)
    #     window.poll_events()
    #     window.update_renderer()
    vis.draw(
        [mesh for mesh in meshes.values() if mesh is not None],
        rpc_interface=True)
```

duburcqa, 2023-03-31:
It appears to be much slower than expected, at least to load first render meshes. It would be interesting to check if it relies on software rendering or not.

duburcqa, 2024-07-15:
For the record, the PR https://github.com/duburcqa/jiminy/pull/826 is bringing many optimisation regarding panda3d rendering speed, for both offscreen and onscreen rendering. So it is even more likely today than replacing it by Open3d is not an option. As of today, all OS and GPU types are supported pretty well, expect for a few features for which workarounds exist. There is also an official port to web-assembly in the making. In the end, Panda3d is probably not going anywhere soon. Closing.

Closed 2024-07-15.

Thread 638 (2023-08-25):

[python] Stop bundling pinocchio, hppfcl, eigenpy in wheels.

duburcqa, 2023-08-25:
Beware all deps must be pinned to a specific version. Note that boost version requirement is incompatible between the binaries provided by `apt` `robotpkg` repository and the one deployed by `pip`.
```
cmeel-boost==1.81.0
cmeel-assimp==5.2.5
cmeel-octomap==1.9.8.1
cmeel-urdfdom==3.1.0.2
cmeel-tinyxml==2.6.2.1
eigenpy==2.9.2
pin==2.6.14
hpp-fcl==2.2.0
```

duburcqa, 2023-08-25:
Just add an extra requirement `all` that install all these libs, so that the user has to opt-in a to get them. This way, building everything from source is not compromised and pre-compiled binaries can still be bundled with the wheel.

Thread 660 (2023-11-05):

[core] Wrong computation of `data.f` in `computeExtraTerms`

duburcqa, 2023-11-05:
In Jiminy, `data.f` is expected to store the internal forces applied on each joint under all external forces on the whole system including the gravity field. This quantity is actually a by-product of RNEA when considering all external forces including contact forces.

For now, `data.f` store the total external forces applied on each body including joint effort and reciprocal forces (namely the forces that would be involved in Newtonian formulation of dynamics), eg 0.0 if in static posture.

Closed 2024-01-02.

Thread 668 (2023-12-02):

Cannot load robot based on urdf and example is broken on MacOS M2 due to missing gym-jiminy

sebbyjp, 2023-12-02:
Hello, I love the idea for this library! Pip cannot find `jiminy_py` on arm64-based docker Ubuntu 22.04 python3.10 so I am trying to run it on my mac:

MacOS: Sonoma
Python: 3.11.6

# Attempt to load robot in simulator:
```
import os
import numpy as np

import jiminy_py.core as jiminy  # The main module of jiminy - this is what gives access to the Robot
from jiminy_py.simulator import Simulator

try:
    from importlib.resources import files
except ImportError:
    from importlib_resources import files

mesh_dirs =["/Users/sebastianperalta/simply/dev/simply-mono/interbotix/interbotix_ros_rovers/interbotix_ros_xslocobots/interbotix_xslocobot_descriptions/meshes/",
	"simply-mono/interbotix/interbotix_ros_rovers/interbotix_ros_xslocobots/interbotix_xslocobot_descriptions/meshes/locobot_meshes/",
	"simply-mono/interbotix/interbotix_ros_rovers/interbotix_ros_xslocobots/interbotix_xslocobot_descriptions/meshes/locobot_meshes/mobile_wx250s_meshes/",
	"simply-mono/interbotix/interbotix_ros_rovers/interbotix_ros_xslocobots/"]
urdf_path = "/Users/sebastianperalta/simply/dev/simply-mono/dgl_ros/loco.urdf"

# Instantiate and initialize the robot
robot = jiminy.Robot()
robot.initialize(urdf_path, mesh_package_dirs=mesh_dirs)

# Add a single motor
# motor = jiminy.SimpleMotor("PendulumJoint")
# robot.attach_motor(motor)
# motor.initialize("PendulumJoint")

# Define the command: for now, the motor is off and doesn't modify the output torque.
def compute_command(t, q, v, sensors_data, command):
    command[:] = 0.0

# Instantiate and initialize the controller
# controller = jiminy.ControllerFunctor()
# controller.initialize(robot)

# Create a simulator using this robot and controller
simulator = Simulator(robot)

# Set initial condition and simulation length
q0, v0 = np.array([0.1]), np.array([0.0])
simulation_duration = 10.0

# Launch the simulation
simulator.simulate(simulation_duration, q0, v0)
```

Error:
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

# Attempt to run example on your docs website:
```
import os

import numpy as np

import jiminy_py.core as jiminy  # The main module of jiminy - this is what gives access to the Robot
from jiminy_py.simulator import Simulator

try:
    from importlib.resources import files
except ImportError:
    from importlib_resources import files

data_root_path = files("gym_jiminy.envs") / "data/toys_models/simple_pendulum"
urdf_path = str(data_root_path / "simple_pendulum.urdf")

# Instantiate and initialize the robot
robot = jiminy.Robot()
robot.initialize(urdf_path, mesh_package_dirs=[data_root_path])

# Add a single motor
motor = jiminy.SimpleMotor("PendulumJoint")
robot.attach_motor(motor)
motor.initialize("PendulumJoint")

# Define the command: for now, the motor is off and doesn't modify the output torque.
def compute_command(t, q, v, sensors_data, command):
    command[:] = 0.0

# Instantiate and initialize the controller
controller = jiminy.ControllerFunctor()
controller.initialize(robot)

# Create a simulator using this robot and controller
simulator = Simulator(robot, controller)

# Set initial condition and simulation length
q0, v0 = np.array([0.1]), np.array([0.0])
simulation_duration = 10.0

# Launch the simulation
simulator.simulate(simulation_duration, q0, v0)
```
Error:
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

Also, why do I get this "Python quit unexpectedly pop-up"? No other python program has produced something like that in my recent memory.

Anyways, thanks again for making tools like this!

duburcqa, 2023-12-03:
> Pip cannot find jiminy_py on arm64-based docker Ubuntu 22.04 python3.10

Indeed, this is expected. I'm not providing precompiled wheels for ARM architecture for now, because github does not provide such machines and doing cross-compilation on x86 would require some effort to setup (not clearly not impossible). If there is a real need I will do it at some point in the future for sure.

Could you provide the complete trace for the exception? Instead of a screenshot ? It would be much easier for me to help you. Unfortunately I have no spare Mac M2  on which I could investigate the issue myself. Jiminy has only been thoroughly tested on X86 CPU architecture so I'm not very surprise there is still issue to fix on Mac M2 for now.

sebbyjp, 2023-12-04:
Sure thing, here is the trace with the example from the docs:
```
(venv) sebastianperalta@Sebastians-MacBook-Pro dev % python jim_example.py
HDF5-DIAG: Error detected in HDF5 (1.14.0) thread 0:
  #000: /Users/runner/work/jiminy/jiminy/build/soup/hdf5/hdf5_external-prefix/src/hdf5_external/src/H5T.c line 2491 in H5T__register_int(): unable to register internal datatype conversion routine
    major: Datatype
    minor: Unable to initialize object
  #001: /Users/runner/work/jiminy/jiminy/build/soup/hdf5/hdf5_external-prefix/src/hdf5_external/src/H5T.c line 2540 in H5T__register(): unable to locate/allocate conversion path
    major: Datatype
    minor: Unable to initialize object
  #002: /Users/runner/work/jiminy/jiminy/build/soup/hdf5/hdf5_external-prefix/src/hdf5_external/src/H5T.c line 5132 in H5T__path_find_real(): unable to initialize conversion function
    major: Datatype
    minor: Unable to initialize object
  #003: /Users/runner/work/jiminy/jiminy/build/soup/hdf5/hdf5_external-prefix/src/hdf5_external/src/H5Tconv.c line 7343 in H5T__conv_ushort_ldouble(): disagreement about datatype size
    major: Datatype
    minor: Unable to initialize object
  #004: /Users/runner/work/jiminy/jiminy/build/soup/hdf5/hdf5_external-prefix/src/hdf5_external/src/H5T.c line 2491 in H5T__register_int(): unable to register internal datatype conversion routine
    major: Datatype
    minor: Unable to initialize object
  #005: /Users/runner/work/jiminy/jiminy/build/soup/hdf5/hdf5_external-prefix/src/hdf5_external/src/H5T.c line 2540 in H5T__register(): unable to locate/allocate conversion path
    major: Datatype
    minor: Unable to initialize object
  #006: /Users/runner/work/jiminy/jiminy/build/soup/hdf5/hdf5_external-prefix/src/hdf5_external/src/H5T.c line 5132 in H5T__path_find_real(): unable to initialize conversion function
    major: Datatype
    minor: Unable to initialize object
  #007: /Users/runner/work/jiminy/jiminy/build/soup/hdf5/hdf5_external-prefix/src/hdf5_external/src/H5Tconv.c line 7283 in H5T__conv_short_ldouble(): disagreement about datatype size
    major: Datatype
    minor: Unable to initialize object
  #008: /Users/runner/work/jiminy/jiminy/build/soup/hdf5/hdf5_external-prefix/src/hdf5_external/src/H5T.c line 2491 in H5T__register_int(): unable to register internal datatype conversion routine
    major: Datatype
    minor: Unable to initialize object
  #009: /Users/runner/work/jiminy/jiminy/build/soup/hdf5/hdf5_external-prefix/src/hdf5_external/src/H5T.c line 2540 in H5T__register(): unable to locate/allocate conversion path
    major: Datatype
    minor: Unable to initialize object
  #010: /Users/runner/work/jiminy/jiminy/build/soup/hdf5/hdf5_external-prefix/src/hdf5_external/src/H5T.c line 5132 in H5T__path_find_real(): unable to initialize conversion function
    major: Datatype
    minor: Unable to initialize object
  #011: /Users/runner/work/jiminy/jiminy/build/soup/hdf5/hdf5_external-prefix/src/hdf5_external/src/H5Tconv.c line 7223 in H5T__conv_uchar_ldouble(): disagreement about datatype size
    major: Datatype
    minor: Unable to initialize object
  #012: /Users/runner/work/jiminy/jiminy/build/soup/hdf5/hdf5_external-prefix/src/hdf5_external/src/H5T.c line 2491 in H5T__register_int(): unable to register internal datatype conversion routine
    major: Datatype
    minor: Unable to initialize object
  #013: /Users/runner/work/jiminy/jiminy/build/soup/hdf5/hdf5_external-prefix/src/hdf5_external/src/H5T.c line 2540 in H5T__register(): unable to locate/allocate conversion path
    major: Datatype
    minor: Unable to initialize object
  #014: /Users/runner/work/jiminy/jiminy/build/soup/hdf5/hdf5_external-prefix/src/hdf5_external/src/H5T.c line 5132 in H5T__path_find_real(): unable to initialize conversion function
    major: Datatype
    minor: Unable to initialize object
  #015: /Users/runner/work/jiminy/jiminy/build/soup/hdf5/hdf5_external-prefix/src/hdf5_external/src/H5Tconv.c line 7163 in H5T__conv_schar_ldouble(): disagreement about datatype size
    major: Datatype
    minor: Unable to initialize object
  #016: /Users/runner/work/jiminy/jiminy/build/soup/hdf5/hdf5_external-prefix/src/hdf5_external/src/H5T.c line 2491 in H5T__register_int(): unable to register internal datatype conversion routine
    major: Datatype
    minor: Unable to initialize object
  #017: /Users/runner/work/jiminy/jiminy/build/soup/hdf5/hdf5_external-prefix/src/hdf5_external/src/H5T.c line 2540 in H5T__register(): unable to locate/allocate conversion path
    major: Datatype
    minor: Unable to initialize object
  #018: /Users/runner/work/jiminy/jiminy/build/soup/hdf5/hdf5_external-prefix/src/hdf5_external/src/H5T.c line 5132 in H5T__path_find_real(): unable to initialize conversion function
    major: Datatype
    minor: Unable to initialize object
  #019: /Users/runner/work/jiminy/jiminy/build/soup/hdf5/hdf5_external-prefix/src/hdf5_external/src/H5Tconv.c line 7103 in H5T__conv_ldouble_double(): disagreement about datatype size
    major: Datatype
    minor: Unable to initialize object
  #020: /Users/runner/work/jiminy/jiminy/build/soup/hdf5/hdf5_external-prefix/src/hdf5_external/src/H5T.c line 2491 in H5T__register_int(): unable to register internal datatype conversion routine
    major: Datatype
    minor: Unable to initialize object
  #021: /Users/runner/work/jiminy/jiminy/build/soup/hdf5/hdf5_external-prefix/src/hdf5_external/src/H5T.c line 2540 in H5T__register(): unable to locate/allocate conversion path
    major: Datatype
    minor: Unable to initialize object
  #022: /Users/runner/work/jiminy/jiminy/build/soup/hdf5/hdf5_external-prefix/src/hdf5_external/src/H5T.c line 5132 in H5T__path_find_real(): unable to initialize conversion function
    major: Datatype
    minor: Unable to initialize object
  #023: /Users/runner/work/jiminy/jiminy/build/soup/hdf5/hdf5_external-prefix/src/hdf5_external/src/H5Tconv.c line 7083 in H5T__conv_ldouble_float(): disagreement about datatype size
    major: Datatype
    minor: Unable to initialize object
  #024: /Users/runner/work/jiminy/jiminy/build/soup/hdf5/hdf5_external-prefix/src/hdf5_external/src/H5T.c line 2491 in H5T__register_int(): unable to register internal datatype conversion routine
    major: Datatype
    minor: Unable to initialize object
  #025: /Users/runner/work/jiminy/jiminy/build/soup/hdf5/hdf5_external-prefix/src/hdf5_external/src/H5T.c line 2540 in H5T__register(): unable to locate/allocate conversion path
    major: Datatype
    minor: Unable to initialize object
  #026: /Users/runner/work/jiminy/jiminy/build/soup/hdf5/hdf5_external-prefix/src/hdf5_external/src/H5T.c line 5132 in H5T__path_find_real(): unable to initialize conversion function
    major: Datatype
    minor: Unable to initialize object
  #027: /Users/runner/work/jiminy/jiminy/build/soup/hdf5/hdf5_external-prefix/src/hdf5_external/src/H5Tconv.c line 7063 in H5T__conv_double_ldouble(): disagreement about datatype size
    major: Datatype
    minor: Unable to initialize object
  #028: /Users/runner/work/jiminy/jiminy/build/soup/hdf5/hdf5_external-prefix/src/hdf5_external/src/H5T.c line 2491 in H5T__register_int(): unable to register internal datatype conversion routine
    major: Datatype
    minor: Unable to initialize object
  #029: /Users/runner/work/jiminy/jiminy/build/soup/hdf5/hdf5_external-prefix/src/hdf5_external/src/H5T.c line 2540 in H5T__register(): unable to locate/allocate conversion path
    major: Datatype
    minor: Unable to initialize object
  #030: /Users/runner/work/jiminy/jiminy/build/soup/hdf5/hdf5_external-prefix/src/hdf5_external/src/H5T.c line 5132 in H5T__path_find_real(): unable to initialize conversion function
    major: Datatype
    minor: Unable to initialize object
  #031: /Users/runner/work/jiminy/jiminy/build/soup/hdf5/hdf5_external-prefix/src/hdf5_external/src/H5Tconv.c line 7023 in H5T__conv_float_ldouble(): disagreement about datatype size
    major: Datatype
    minor: Unable to initialize object
Traceback (most recent call last):
  File "/Users/sebastianperalta/simply/dev/jim_example.py", line 19, in <module>
    robot.initialize(urdf_path, mesh_package_dirs=[data_root_path])
TypeError: No registered converter was able to produce a C++ rvalue of type std::__1::basic_string<char, std::__1::char_traits<char>, std::__1::allocator<char>> from this Python object of type PosixPath
zsh: segmentation fault  python jim_example.py
```

duburcqa, 2023-12-05:
OK the HDF5 error is strange, I will try to have a look at it. Regarding the segmentation fault at the end, it is due to either `urdf_path` or `data_root_path` not being a plain string but a `Path` object. Try doing this instead:
```
robot.initialize(str(urdf_path), mesh_package_dirs=[str(data_root_path)])
```
Of course it is a big that should be fixed at jiminy level.

duburcqa, 2023-12-05:
I can confirm that HDF5 errors are related to cross-compilation issues (mentioned [here](https://github.com/PyTables/PyTables/issues/887#issuecomment-1068166949)). I was not aware of such limitation. I will see if I can fix it.

duburcqa, 2023-12-05:
White I'm fixing the issue with HDF5, you can change the log format to "binary" (with ".data") extension for log files. It has the same features but it can only be read usine tools provided by jiminy.

duburcqa, 2023-12-13:
New wheels for MacOS are available [here](https://github.com/duburcqa/jiminy/actions/runs/7193017600). You can check if it fixes your issues.

duburcqa, 2023-12-19:
I now have a MacBook M3 and I can confirm the latest wheel is working like a charm !

Closed 2023-12-14.

Thread 670 (2023-12-08):

[core/python] Refactor numpy converters to stop using low-level C-Python  API.

duburcqa, 2023-12-08:
Once done, it would be easier to expose a new `take_ownership` attribute for numpy converters, so that `copying` data can be avoided when wrapping temporaries. This is typically the case when parsing log files [here](https://github.com/duburcqa/jiminy/blob/04511dd1bf8bea91f3af054db3f78d2775a0470c/python/jiminy_pywrap/src/engine.cc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) but also when wrapping some methods.

Thread 691 (2024-01-12):

How to add collision object to the scene?

fedor-chervinskii, 2024-01-12:
Hi @duburcqa! This is a brilliant tool and I like how easy it is to start using, and that it's working headless and RL-ready.

However, for my use case, I'd like to have some objects that are external to the robot, and also potentially collidable. I couldn't find anything relevant in the documentation. What's the best/easiest way to do that in Jiminy? If it requires some patching - maybe if you could explain it, I could try to implement it myself.

An example would be a pick-and-place task for a robot.

Thanks!

duburcqa, 2024-01-15:
Hi @fedor-chervinskii ,

Thank you for your support ! Unfortunately, this feature is not available at the time being. It is part of the highly requested features that I'm going to implement ASAP, but it may take a while nonetheless. I'm not expecting this before at least  3 months because I don't have time to work on it for now. [Here](https://github.com/duburcqa/jiminy/discussions/508) is the list of all the features that are going to be implemented at some point.

For now, only collision with the ground is supported, and the ground has to be a height map. I know it is very limiting...

duburcqa, 2024-01-15:
If you just want to avoid colliding with the environment, you could create a height map that includes big "bumps" here and there as obstacle. As such, those obstacles will be weightless and unmovable. For now there is no better way.

The necessary refactoring to support generic collisions is quite significant and must be implemented in the C++ core. First, `hpp-fcl` must be leveraged to detect the collision between bodies. There is already a draft implementation of this merged in jiminy itself but it does not work reliably often for now. Then, additional collision pairs between objects should be added to not consider the ground only.

At python level, it is still possible to detect generic collision but not to grasps stuffs. [here](https://github.com/duburcqa/jiminy/blob/dev/python/jiminy_py/examples/collision_detection.py) is an example for plain collision detection in Python.

Closed 2024-01-25.

Thread 696 (2024-01-29):

[core] Get contact frame index once for all at reset.

duburcqa, 2024-01-29:
https://github.com/duburcqa/jiminy/blob/d14b38d961afc322557b4f03a4b8077872e24e26/core/src/hardware/basic_sensors.cc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

Closed 2024-01-30.

Thread 697 (2024-01-29):

[core] Wrong force sensor in presence of external forces

duburcqa, 2024-01-29:
https://github.com/duburcqa/jiminy/blob/d14b38d961afc322557b4f03a4b8077872e24e26/core/src/hardware/basic_sensors.cc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

The sensor should rather store a `static_map_t<std::size_t, pinocchio::SE3>`  storing the indices of all the contact forces applied on a given body along with their placement wrt the sensor frame.

Closed 2024-01-30.

Thread 717 (2024-02-13):

[misc] Easy install instructions are not working.

duburcqa, 2024-02-13:
Two required options are missing:
```
-DCMAKE_PREFIX_PATH="/opt/openrobots/" -DPYTHON_EXECUTABLE=$(python3 -c "import sys; sys.stdout.write(sys.executable)")
```

It should be mentioned that python dependencies must be installed manually when using venv or pyenv, basically `numpy` and `wheels`.

Closed 2024-02-13.

Thread 718 (2024-02-13):

[misc] Building from source does not support `Pyenv`

duburcqa, 2024-02-13:
The command used in `build_install_deps_unix.sh` to get the `site-packages` directory associated with Python executable is the following:
```
"${PYTHON_EXECUTABLE}" -m site --user-site
```
This does not work with `Pyenv` as it returns the directory associated with the native executable. What could be used instead is the following:
```
python3 -c 'import sysconfig; print(sysconfig.get_path("purelib"), end="")'
```

By the way, `sys.stdout.write` should be replaced by `print(..., end="")` everywhere for consistency.

Closed 2024-02-13.

Thread 725 (2024-02-14):

[core] Restore constraint lambda in case of integration failure.

duburcqa, 2024-02-14:
Currently, the lambda multipliers of the constraints are not reset to their original value if the integration step failed. This is an issue because they are used as initial guess for the constraint solver. This coupling seems to be problematic on `gym_jiminy.envs:atlas` environment.  Here is a snippet to reproduce the issue:
```
import numpy as np
import gymnasium as gym
env = gym.make("gym_jiminy.envs:atlas", debug=True)
env.reset()
env.simulator.step(0.73)
for _ in range(10):
    print("-----")
    env.simulator.step(1e-6)
```

An additional buffers with the values at the previous iteration should be stored next to `contactForcesPrev_`, `fPrev_` and `aPrev_`.

duburcqa, 2024-02-15:
Two options at may improve convergence:
* implement SOR (successive over-relaxation with rfactor going from 2.0 to 0.0 linearly)
* implement SSOR (symmetric SOR) with factor fixed to 1.0

duburcqa, 2024-02-17:
Before implementing under-relaxation:

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

After (https://github.com/duburcqa/jiminy/pull/726):

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

Closed 2024-02-17.

Thread 771 (2024-04-22):

`build_robot_from_log` no longer works due to backlash

matthieuvigne, 2024-04-22:
When loading a non-persistent log with `build_robot_from_log`, then looking at `robot.log_position_fieldnames`, backlash joints are missing from this list. This in turn breaks replay functions - that rely on this variable through `extract_trajectory_from_log`.

The root cause seems to be the fact that, when creating the robot, the hardware and specifically the motors are not included - and  backlash is a motor option. Thus, when doing `robot.set_options(all_options[robot_name or "robot"])`, since there are no motors, the motors are not added.

Note that because `pinocchio_model` is in the log, this object is correct. This in fact leads to the mismatch: if it were recreated from the options, it too would be missing the backlash (which would be wrong but consistent).

I see two ways to handle the problem:

 - try to rebuild the hardware in `build_robot_from_log`, thus restoring the backlash
 - a more ad-hoc fix, use `pinocchio_model` to regenerate the list `log_position_fieldnames`

I prefer the first solution because it seems more robust. However, I don't think there is a way to know the *type* of motor that was added from the log. Here is a proposed fixed, with works in my context but assumes that the motor is of type `jiminy.SimpleMotor`:

```diff
diff --git a/python/jiminy_py/src/jiminy_py/log.py b/python/jiminy_py/src/jiminy_py/log.py
index b4240414..6d9699a2 100644
--- a/python/jiminy_py/src/jiminy_py/log.py
+++ b/python/jiminy_py/src/jiminy_py/log.py
@@ -214,6 +214,12 @@ def build_robot_from_log(

         # Load the options
         all_options = log_constants["options"]
+        # Add a SimpleMotor to the joint that had a motor
+        motor_options = all_options[robot_name or "robot"]["motors"]
+        for joint_name in motor_options.keys():
+            motor = jiminy.SimpleMotor(joint_name)
+            robot.attach_motor(motor)
+            motor.initialize(joint_name)
         robot.set_options(all_options[robot_name or "robot"])

         # Update model in-place.
```

duburcqa, 2024-04-22:
Being able to re-create robots from log properly is a long overdue issue. Currently, we pretend that the extended model is actually the theoretical one when instantiating the robot. Because of this, it is not possible to restore the options properly, and it cannot be used for anything else than replay since everything related to the difference between theoretical and extended model is broken...

The missing part to fix this issue is to move the notion of hardware description from Python to C++, so that it can be exported and loaded. Once this is done, it should be straightforward to build the original model and load hardware and options to get the right extended model.

I will have a look at it ASAP, it has been annoying me since a long time already.

matthieuvigne, 2024-04-23:
All right. How long do you think it will take you ? I don't want to rush you so I'm thinking it might be best to patch this in my own fork in an intermediate release while you work on a more long-term solution.

duburcqa, 2024-04-23:
I think this is definitely the right approach, no matter how long it takes on my side, unless you can open the MR yourself. For this particular matter, it is hard to tell. I'm almost done backporting all the logic for loading a `jiminy::Model` from Python to C++.  Next I need to do the same for `jiminy::Robot`, which basically means adding hardware. If everthing goes well, it could be today or tomorrow.

duburcqa, 2024-04-24:
OK I'm done with the serialisation of 'Model'. Now it remains to deal with all the additions of a robot ! It should not be too hard now that the architecture is there :)

Closed 2024-04-28.

Thread 778 (2024-04-29):

Constraint solver leads to non-consistent integration

matthieuvigne, 2024-04-29:
Strangely, activating the `engine_options['contacts']['model'] = "constraint"` option leads to non-consistent integration result for some systems - where the velocity is not the integral of the acceleration!

This happens for instance in the following example script, which simulates a double pendulum (servoed to be horizontal) with backlash. Backlash is needed to actually create a constraint (the pendulum, being horizontal, rests on the backlash bounds).  The system has fixed base, and is thus basically a simple chain of 4 pivot joints, 2 with motors, 2 unactuated (backlash).

When simulating with `constraint` option, one obtains the following plot showing acceleration (top) and velocity (bottom)

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

We can see that though the velocity is zero, the acceleration is not - and that remains true forever, which is clearly inconsistent.
Here are some further comments:

 - this was observed on 1.8.4, but I believe this was already present in 1.7.13 (though it's not easy to confirm because the API has significantly changed)
 - the phenomenon disappears when switching to `spring_damper` (you'll need to adjust the controller frequency if you don't want vibrations - then you can get line, asymptotic convergence of both velocity and acceleration to zero)
 - the phenomenon is somehow linked to the system mass: I increased them to make the phenomenon more visible. Lowering them leads to a smaller, but still present, error.
 - lowering `engine_options["stepper"]["tolRel"], engine_options["stepper"]["tolAbs"]` by one order of magnitude does not change at all the value to which this converges.

 Script to reproduce the issue: [double_pendulum.zip](https://github.com/duburcqa/jiminy/files/15146810/double_pendulum.zip)

duburcqa, 2024-04-29:
Thank you for your thorough analysis of the problem ! I will have a look at it ASAP !

Closed 2024-04-29.

Thread 781 (2024-04-30):

[python/gym] Unable to run simple Atlas simulation because truncated is true immediately

mwulfman, 2024-04-30:
Reproduction scripts:
```python
import numpy as np
from gym_jiminy.envs.atlas import AtlasJiminyEnv
from jiminy_py import tree

env = AtlasJiminyEnv()
for i in range(100):
    obs, _ = env.reset(seed = i)
    terminated, truncated = False, False
    while not (terminated or truncated):
        assert not any(np.isnan(e).any() for e in tree.flatten(obs)), "Nan in observation"
        obs, _, terminated, truncated, _ = env.step(env.action_space.sample())
        print(terminated, truncated, not env._contains_observation())
        # truncated is true immediately because of env._contains_observation()
        truncated = env.stepper_state.t >= env.simulation_duration_max - env.step_dt # comment this line to make it work
        env.replay()
```

I am not able to run an Atlas simulation for more than `step_dt` because truncated is set to true by env._contains_observation() after the first step. I am not sure this is the desired behavior.

duburcqa, 2024-04-30:
It is not clear to me if we should set `terminated  = True` if the observation is out of bounds. After checking, you are violating the maximum velocity limit. I have the felling it is a real problem and the simulation should be terminated for this.

duburcqa, 2024-04-30:
Maybe the actual problem is coming from the fact that those specifications are not really working this way in really. In the real world, velocity limit does not exist. If you have some external source of torque, you could spine the joint as fast as you want. In practice, there is a relation between motor torque and angular velocity which limits the measured velocity ultimately. Without external source of energy, the joint velocity is therefore limited.

What I said previous still stand. I don't know what we want to do in this scenario. It was specified in the URDF that the joints are not supposed to spine faster than some maximum velocity, and I think we should honour that by default. Whether some command torque is capable of invalidating the current state is an another issue. Here it is the case because the actuators are very powerful. But I'm also expecting the system to break if you start standing random torques to the actuators in reality, so it is not a false positive.

mwulfman, 2024-04-30:
Would it be possible to send an additional warning message when the commanded torque is unfeasible given the velocity limits ?

duburcqa, 2024-04-30:
How to detect this is not straightforward as it depends on the dynamics of the whole system. Maybe some estimate based on the apparent inertia could be computed but it would only be rough approximation as it also involves all the external forces, mechanical constraints...etc.

I agree it would be nice to detect such issue differently than just detecting than the observation is out of bounds but I'm not sure it can be predicted reliably. I'm still convinced that controlling a robot in torque is tricky and should be avoided if possible, one of the reason being unreasonable joint velocities when sending random commands.

mwulfman, 2024-04-30:
Ok, yes I understand your point. Does Atlas has default acceleration limit as well ?
The same issue appears with this new code (unless I lower the action sampling range)
```
import numpy as np
from gym_jiminy.common.bases import DT_EPS
from gym_jiminy.common.blocks.proportional_derivative_controller import (
    pd_adapter,
    pd_controller,
)
from gym_jiminy.common.utils import is_breakpoint, sample
from gym_jiminy.envs.atlas import PD_FULL_KD, PD_FULL_KP, AtlasJiminyEnv
from jiminy_py import tree

PD_KP = np.array(PD_FULL_KP)
PD_KD = np.array(PD_FULL_KD)

env = AtlasJiminyEnv(step_dt=0.005)

nmotors = env.robot.nmotors
# Limits
position_limit_lower = env.robot.position_limit_lower[env.robot.motor_position_indices].squeeze()
position_limit_upper = env.robot.position_limit_upper[env.robot.motor_position_indices].squeeze()
velocity_limit = env.robot.velocity_limit[env.robot.motor_velocity_indices]
motors_effort_limit = env.robot.command_limit[env.robot.motor_velocity_indices]
acceleration_limit = np.full((nmotors,), float("inf"))
# Buffers
desired_command_acceleration = np.full((nmotors,), float("nan"))
command_torque = np.full((nmotors,), 0.0)
command_state = np.full((3, nmotors,), 0.0)
command_state_lower = np.stack((position_limit_lower, -velocity_limit, -acceleration_limit))
command_state_upper =  np.stack((position_limit_upper, velocity_limit, acceleration_limit))

# Target position
neutral_motor_position = env._neutral()[env.robot.motor_position_indices].squeeze()
target_dt = 0.05

for i in range(100):
    obs, _ = env.reset(seed = i)
    terminated, truncated = False, False
    while not (terminated or truncated):
        assert not any(np.isnan(e).any() for e in tree.flatten(obs)), "Nan in observation"
        q_measured, v_measured = env.observation["measurements"]["EncoderSensor"]
        if env.stepper_state.t < env.step_dt:
            command_state[0] = q_measured
            command_state[1] = v_measured
        if is_breakpoint(env.stepper_state.t, target_dt, DT_EPS):
            action = sample(low=-velocity_limit, high=velocity_limit, rg=env.np_random)
            pd_adapter(action, 1,
                    command_state,
                    command_state_lower,
                    command_state_upper,
                    target_dt,
                    desired_command_acceleration)
        command_state[2] = desired_command_acceleration
        pd_controller(q_measured,
                      v_measured,
                      command_state,
                      command_state_lower,
                      command_state_upper,
                      PD_KP,
                      PD_KD,
                      motors_effort_limit,
                      env.step_dt,
                      command_torque)
        obs, _, terminated, truncated, _ = env.step(command_torque)
    env.simulator.stop()
    env.replay()
```

duburcqa, 2024-04-30:
You should have a look to the `AtlasPDControlJiminyEnv`. Max velocity and acceleration are specified to avoid this issues.

mwulfman, 2024-04-30:
I will have a look at this one. But I still don't understand why my environment gets truncated now when I am respecting the position, velocity and acceleration limits (I have just added them).

mwulfman, 2024-04-30:
Ok thanks, I will have a look.

duburcqa, 2024-04-30:
> when I am respecting the position, velocity and acceleration limits

You should be more restrictive than that. Satisfying the limits for the command is not enough to make sure that the measure is not out of bounds. That is why the threshold are much lower in `AtlasPDControlJiminyEnv`.

Thread 818 (2024-06-27):

[gym][wrappers] StackObservation is not preserving the order for OrderedDict observation spaces.

mwulfman, 2024-06-27:
observation_stack.StackObservation changes the key order of an OrderedDict observation_space while preserving the correct key order of observation. If it is used in conjunction with FlattenObservation, we find ourselves with env.observation and env.observation_spaces arrays with indices that doesn't correspond to each other. A side effect is then that the obs (after step) becomes different from env.observation because it is then clipped wrongly by a faulty env.observation_space.

Reproduction script:
```
from gym_jiminy.common.wrappers import FlattenObservation, StackObservation
from gym_jiminy.envs.atlas import AtlasPDControlJiminyEnv

env = StackObservation(AtlasPDControlJiminyEnv(),skip_frames_ratio=-1,
            num_stack=2,
            nested_filter_keys=[["t"]],
        )
_, _ = env.reset(seed = 0)

print("======= env.observation keys() ==========")
for key in env.observation:
    print(key)
print("======= env.observation_space keys() ==========")
for key in env.observation_space:
    print(key)

env = FlattenObservation(StackObservation(AtlasPDControlJiminyEnv(),skip_frames_ratio=-1,
            num_stack=2,
            nested_filter_keys=[["t"]],
        ))
_, _ = env.reset(seed = 0)

N = 100
for _ in range(N):
    env.step(env.action_space.sample())
obs, _, _, _, _ = env.step(env.action_space.sample())

print("=========== Bounds of unflatten (stacked) env.env.observation space of 't' ========" )
print(env.env.observation_space["t"].low)
print(env.env.observation_space["t"].high)

print("=========== Bounds of flatten env.observation_space first 2 elements ========" )
print(env.observation_space.low[:2])
print(env.observation_space.high[:2])

print("=========== env.observation's first 2 elements ========" )
print(env.observation[:2])
print("=========== obs' 2 first elements ========" )
print(obs[:2])
print("======= The above two lines should be equals ! ===========")
```

Here is a fix if you think this solution works for you:
```
def _unflatten_as(data: StructNested[Any],
                  data_leaf_it: Iterator) -> StructNested[Any]:
    """Internal method un-flattening a sequence into a nested data structure by
    calling itself recursively on each top-level nodes that are not leaves and
    fetching the next leaf value otherwise.
    """
    data_type = type(data)
    if issubclass_mapping(data_type):  # type: ignore[arg-type]
        return data_type(OrderedDict({  # type: ignore[call-arg]
            key: _unflatten_as(value, data_leaf_it)
            for key, value in data.items()  # type: ignore[union-attr]
        }))
    if issubclass_sequence(data_type):  # type: ignore[arg-type]
        return data_type(tuple(  # type: ignore[call-arg]
            _unflatten_as(value, data_leaf_it) for value in data
        ))
    return next(data_leaf_it)
```

The solution just wrapped the created dict by the OrderedDict class.

duburcqa, 2024-06-28:
Ok the chain of consequences is quite complex and unfortunate x) I will add a unit test for this.

for the record, it should be slightly faster to flatten before anything else, including normalization for instance. Post-processing is bound to be slower, even when using pre-compiled methods, when the memory layout is fragmented.

Closed 2024-06-28.
