duburcqa/jiminy/data/quadrupedal_robots/anymal/anymal.urdf

<?xml version="1.0" encoding="utf-8"?>
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
<robot name="anymal">
    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
    <link name="base">
        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
        <self_filter>
            <origin rpy="0 0 0" xyz="0 0 0"/>
            <geometry>
                <box size="1.05 0.5 0.5"/>
            </geometry>
        </self_filter>
    </link>
    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
    <joint name="base_to_base_inertia" type="fixed">
        <parent link="base"/>
        <child link="base_inertia"/>
        <origin rpy="0 0 0" xyz="0 0 0"/>
    </joint>
    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
    <link name="base_inertia">
        <inertial>
            <origin rpy="0 0 0" xyz="-0.018 -0.002 0.024"/>
            <mass value="6.222"/>
            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
        </inertial>
    </link>
    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
    <joint name="base_top_shell" type="fixed">
        <parent link="base"/>
        <child link="top_shell"/>
        <origin rpy="0 0 0" xyz="0 0 0"/>
    </joint>
    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
    <link name="top_shell">
        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
        <inertial>
            <origin rpy="0 0 0" xyz="-0.00777 -0.00013 0.06523"/>
            <mass value="0.534"/>
            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
        </inertial>
    </link>
    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
    <joint name="base_bottom_shell" type="fixed">
        <parent link="base"/>
        <child link="bottom_shell"/>
        <origin rpy="0 0 0" xyz="0 0 0"/>
    </joint>
    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
    <link name="bottom_shell">
        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
        <inertial>
            <origin rpy="0 0 0" xyz="-0.00333 1e-05 -0.07705"/>
            <mass value="1.15"/>
            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
        </inertial>
    </link>
    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
    <joint name="base_remote" type="fixed">
        <parent link="base"/>
        <child link="remote"/>
        <origin rpy="0 0 0" xyz="0 0 0"/>
    </joint>
    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
    <link name="remote">
        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
        <inertial>
            <origin rpy="0 0 0" xyz="-0.171 0.002 0.096"/>
            <mass value="0.3262"/>
            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
        </inertial>
    </link>
    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
    <joint name="base_handle" type="fixed">
        <parent link="base"/>
        <child link="handle"/>
        <origin rpy="0 0 0" xyz="0 0 0"/>
    </joint>
    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
    <link name="handle">
        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
        <inertial>
            <origin rpy="0 0 0" xyz="0.37801 0.0 0.1372"/>
            <mass value="0.314"/>
            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
        </inertial>
    </link>
    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
    <joint name="base_face_front" type="fixed">
        <parent link="base"/>
        <child link="face_front"/>
        <origin rpy="0 0 -0.0" xyz="0.4145 0 0"/>
    </joint>
    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
    <link name="face_front">
        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
        <inertial>
            <origin rpy="0 0 0" xyz="0.042 -0.001 0.004"/>
            <mass value="0.73"/>
            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
        </inertial>
    </link>
    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
    <joint name="face_front_to_depth_camera_front_camera" type="fixed">
        <parent link="face_front"/>
        <child link="depth_camera_front_camera"/>
        <origin rpy="0.0 0.523598775598 0" xyz="0.04715 0.0 -0.0292"/>
    </joint>
    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
    <link name="depth_camera_front_camera">
        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
        <inertial>
            <origin rpy="0 0 0" xyz="-0.021 -0.002 0.025"/>
            <mass value="0.16043"/>
            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
        </inertial>
    </link>
    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
    <joint name="depth_camera_front_camera_to_camera_parent" type="fixed">
        <parent link="depth_camera_front_camera"/>
        <child link="depth_camera_front_camera_parent"/>
        <origin rpy="0.0 0.0 0.0" xyz="0.0255 0.0175 0.0"/>
    </joint>
    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
    <link name="depth_camera_front_camera_parent"/>
    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
    <joint name="depth_camera_front_camera_parent_to_depth_optical_frame" type="fixed">
        <parent link="depth_camera_front_camera_parent"/>
        <child link="depth_camera_front_depth_optical_frame"/>
        <origin rpy="-1.57079632679 0.0 -1.57079632679" xyz="0.0 0.0 0.0"/>
    </joint>
    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
    <link name="depth_camera_front_depth_optical_frame"/>
    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
    <joint name="depth_camera_front_camera_parent_to_color_frame" type="fixed">
        <parent link="depth_camera_front_camera_parent"/>
        <child link="depth_camera_front_color_frame"/>
        <origin rpy="0 0 0" xyz="0 0.015 0"/>
    </joint>
    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
    <link name="depth_camera_front_color_frame"/>
    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
    <joint name="depth_camera_front_color_frame_to_color_optical_frame" type="fixed">
        <parent link="depth_camera_front_color_frame"/>
        <child link="depth_camera_front_color_optical_frame"/>
        <origin rpy="-1.57079632679 0.0 -1.57079632679" xyz="0.0 0.0 0.0"/>
    </joint>
    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
    <link name="depth_camera_front_color_optical_frame"/>
    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
    <joint name="face_front_to_wide_angle_camera_front_camera" type="fixed">
        <parent link="face_front"/>
        <child link="wide_angle_camera_front_camera"/>
        <origin rpy="0 0 0" xyz="0.09850 0.0 0.01497"/>
    </joint>
    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
    <link name="wide_angle_camera_front_camera">
        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
        <inertial>
            <origin rpy="0 0 0" xyz="-0.053 -0.001 0.025"/>
            <mass value="0.287"/>
            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
        </inertial>
    </link>
    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
    <joint name="wide_angle_camera_front_camera_to_camera_parent" type="fixed">
        <parent link="wide_angle_camera_front_camera"/>
        <child link="wide_angle_camera_front_camera_parent"/>
        <origin rpy="-1.57079632679 0.0 -1.57079632679" xyz="0.0 0.0 0.0"/>
    </joint>
    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
    <link name="wide_angle_camera_front_camera_parent"/>
    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
    <joint name="base_face_rear" type="fixed">
        <parent link="base"/>
        <child link="face_rear"/>
        <origin rpy="0 0 3.14159265359" xyz="-0.4145 0 0"/>
    </joint>
    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
    <link name="face_rear">
        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
        <inertial>
            <origin rpy="0 0 0" xyz="0.042 -0.001 0.004"/>
            <mass value="0.73"/>
            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
        </inertial>
    </link>
    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
    <joint name="face_rear_to_depth_camera_rear_camera" type="fixed">
        <parent link="face_rear"/>
        <child link="depth_camera_rear_camera"/>
        <origin rpy="0.0 0.523598775598 0" xyz="0.04715 0.0 -0.0292"/>
    </joint>
    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
    <link name="depth_camera_rear_camera">
        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
        <inertial>
            <origin rpy="0 0 0" xyz="-0.021 -0.002 0.025"/>
            <mass value="0.16043"/>
            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
        </inertial>
    </link>
    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
    <joint name="depth_camera_rear_camera_to_camera_parent" type="fixed">
        <parent link="depth_camera_rear_camera"/>
        <child link="depth_camera_rear_camera_parent"/>
        <origin rpy="0.0 0.0 0.0" xyz="0.0255 0.0175 0.0"/>
    </joint>
    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
    <link name="depth_camera_rear_camera_parent"/>
    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
    <joint name="depth_camera_rear_camera_parent_to_depth_optical_frame" type="fixed">
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
