duburcqa/jiminy/python/jiminy_pywrap/src/motors.cc

#include "jiminy/core/hardware/basic_motors.h"

#define NO_IMPORT_ARRAY
#include "jiminy/python/fwd.h"
#include "jiminy/python/utilities.h"
#include "jiminy/python/motors.h"


namespace jiminy::python
{
    namespace bp = boost::python;

    // ************************************* AbstractMotor ************************************* //

    namespace internal::abstract_motor
    {
        static void setOptions(AbstractMotorBase & self, const bp::dict & configPy)
        {
            GenericConfig config = self.getOptions();
            convertFromPython(configPy, config);
            return self.setOptions(config);
        }
    }

    void exposeAbstractMotor()
    {
        bp::class_<AbstractMotorBase, std::shared_ptr<AbstractMotorBase>, boost::noncopyable>(
            "AbstractMotor", bp::no_init)
            .ADD_PROPERTY_GET("is_attached", &AbstractMotorBase::getIsAttached)
            .ADD_PROPERTY_GET("is_initialized", &AbstractMotorBase::getIsInitialized)
            .ADD_PROPERTY_GET_WITH_POLICY("name",
                                          &AbstractMotorBase::getName,
                                          bp::return_value_policy<bp::return_by_value>())
            .ADD_PROPERTY_GET("index", &AbstractMotorBase::getIndex)
            .ADD_PROPERTY_GET_WITH_POLICY("joint_name",
                                          &AbstractMotorBase::getJointName,
                                          bp::return_value_policy<bp::return_by_value>())
            .ADD_PROPERTY_GET("joint_index", &AbstractMotorBase::getJointIndex)
            .ADD_PROPERTY_GET("position_limit_lower", &AbstractMotorBase::getPositionLimitLower)
            .ADD_PROPERTY_GET("position_limit_upper", &AbstractMotorBase::getPositionLimitUpper)
            .ADD_PROPERTY_GET("velocity_limit", &AbstractMotorBase::getVelocityLimit)
            .ADD_PROPERTY_GET("effort_limit", &AbstractMotorBase::getEffortLimit)
            .ADD_PROPERTY_GET("armature", &AbstractMotorBase::getArmature)
            .ADD_PROPERTY_GET("backlash", &AbstractMotorBase::getBacklash)

            .def("set_options", &internal::abstract_motor::setOptions)
            .def("get_options",
                 &AbstractMotorBase::getOptions,
                 bp::return_value_policy<bp::return_by_value>());
    }

    // ************************************** BasicMotors ************************************** //

    void exposeBasicMotors()
    {
        bp::class_<SimpleMotor,
                   bp::bases<AbstractMotorBase>,
                   std::shared_ptr<SimpleMotor>,
                   boost::noncopyable>(
            "SimpleMotor", bp::init<const std::string &>((bp::arg("self"), "motor_name")))
            .def("initialize", &SimpleMotor::initialize);
    }
}
