duburcqa/jiminy/core/src/stepper/abstract_runge_kutta_stepper.cc

#include "jiminy/core/stepper/abstract_runge_kutta_stepper.h"


namespace jiminy
{
    AbstractRungeKuttaStepper::AbstractRungeKuttaStepper(const systemDynamics & f,
                                                         const std::vector<const Robot *> & robots,
                                                         const Eigen::MatrixXd & RungeKuttaMatrix,
                                                         const Eigen::VectorXd & bWeights,
                                                         const Eigen::VectorXd & cNodes,
                                                         bool isFSAL) noexcept :
    AbstractStepper(f, robots),
    A_{RungeKuttaMatrix},
    b_{bWeights},
    c_{cNodes},
    isFSAL_{isFSAL},
    ki_(cNodes.size(), StateDerivative(robots)),
    stateIncrement_(robots),
    stateBuffer_(robots),
    candidateSolution_(robots)
    {
    }

    bool AbstractRungeKuttaStepper::tryStepImpl(
        State & state, StateDerivative & stateDerivative, double t, double & dt)
    {
        // Make sure that the provided matrices are consistent with each other
        assert(A_.rows() == A_.cols());
        assert(c_.size() == A_.rows());
        assert(b_.size() == b_.rows());

        // First ki is simply the provided stateDerivative
        ki_[0] = stateDerivative;

        for (Eigen::Index i = 1; i < c_.size(); ++i)
        {
            stateIncrement_.setZero();
            for (Eigen::Index j = 0; j < i; ++j)
            {
                /* Equivalent to `stateIncrement_ += (dt * A_(i, j)) * ki_[j]`
                   but more efficient because it avoid temporaries. */
                stateIncrement_.sumInPlace(ki_[j], dt * A_.coeff(i, j));
            }
            state.sum(stateIncrement_, stateBuffer_);
            ki_[i] = f(t + c_[i] * dt, stateBuffer_);
        }

        /* Now we have all the ki's: compute the solution.
           Sum the velocities before summing into position the accuracy is greater
           for summing vectors than for summing velocities into lie groups. */
        stateIncrement_.setZero();
        for (std::size_t i = 0; i < ki_.size(); ++i)
        {
            stateIncrement_.sumInPlace(ki_[i], dt * b_[i]);
        }
        state.sum(stateIncrement_, candidateSolution_);

        // Evaluate the solution's error for step adjustment
        const double t_next = t + dt;
        const bool hasSucceeded = adjustStep(state, candidateSolution_, dt);

        // Update state and compute derivative if success
        if (hasSucceeded)
        {
            state = candidateSolution_;
            if (isFSAL_)
            {
                stateDerivative = ki_.back();
            }
            else
            {
                stateDerivative = f(t_next, state);
            }
        }

        return hasSucceeded;
    }

    bool AbstractRungeKuttaStepper::adjustStep(
        const State & /* initialState */, const State & /* solution */, double & dt)
    {
        // Fixed-step by default, which never fails
        dt = INF;
        return true;
    }
}
