duburcqa/jiminy/core/include/jiminy/core/engine/engine.h

#ifndef JIMINY_ENGINE_MULTIROBOT_H
#define JIMINY_ENGINE_MULTIROBOT_H

#include <set>
#include <optional>
#include <functional>

#include "jiminy/core/fwd.h"
#include "jiminy/core/utilities/helpers.h"  // `Timer`
#include "jiminy/core/utilities/random.h"   // `PCG32`


namespace jiminy
{
    inline constexpr std::string_view ENGINE_TELEMETRY_NAMESPACE{""};

    enum class ContactModelType : uint8_t
    {
        UNSUPPORTED = 0,
        SPRING_DAMPER = 1,
        CONSTRAINT = 2
    };

    enum class ConstraintSolverType : uint8_t
    {
        UNSUPPORTED = 0,
        PGS = 1  // Projected Gauss-Seidel
    };

    const std::map<std::string, ContactModelType> CONTACT_MODELS_MAP{
        {"spring_damper", ContactModelType::SPRING_DAMPER},
        {"constraint", ContactModelType::CONSTRAINT},
    };

    const std::map<std::string, ConstraintSolverType> CONSTRAINT_SOLVERS_MAP{
        {"PGS", ConstraintSolverType::PGS}};

    const std::set<std::string> STEPPERS{"euler_explicit", "runge_kutta_4", "runge_kutta_dopri"};

    class Robot;
    class AbstractConstraintSolver;
    class AbstractConstraintBase;
    class AbstractController;
    class AbstractStepper;
    class LockGuardLocal;
    class TelemetryData;
    class TelemetryRecorder;
    class TelemetrySender;
    struct LogData;

    // ******************************** External force functors ******************************** //

    using ProfileForceFunction = std::function<pinocchio::Force(
        double /*t*/, const Eigen::VectorXd & /*q*/, const Eigen::VectorXd & /*v*/)>;

    struct JIMINY_DLLAPI ProfileForce
    {
    public:
        // FIXME: Designated aggregate initialization without constructors when moving to C++20
        explicit ProfileForce() = default;
        explicit ProfileForce(const std::string & frameNameIn,
                              pinocchio::FrameIndex frameIndexIn,
                              double updatePeriodIn,
                              const ProfileForceFunction & forceFuncIn) noexcept;

    public:
        std::string frameName{};
        pinocchio::FrameIndex frameIndex{0};
        double updatePeriod{0.0};
        pinocchio::Force force{pinocchio::Force::Zero()};
        ProfileForceFunction func{};
    };

    struct JIMINY_DLLAPI ImpulseForce
    {
    public:
        // FIXME: Designated aggregate initialization without constructors when moving to C++20
        explicit ImpulseForce() = default;
        explicit ImpulseForce(const std::string & frameNameIn,
                              pinocchio::FrameIndex frameIndexIn,
                              double tIn,
                              double dtIn,
                              const pinocchio::Force & forceIn) noexcept;


    public:
        std::string frameName{};
        pinocchio::FrameIndex frameIndex{0};
        double t{0.0};
        double dt{0.0};
        pinocchio::Force force{};
    };

    using CouplingForceFunction =
        std::function<pinocchio::Force(double /* t */,
                                       const Eigen::VectorXd & /* q1 */,
                                       const Eigen::VectorXd & /* v1 */,
                                       const Eigen::VectorXd & /* q2 */,
                                       const Eigen::VectorXd & /* v2 */)>;

    struct CouplingForce
    {
    public:
        // FIXME: Designated aggregate initialization without constructors when moving to C++20
        explicit CouplingForce() = default;
        explicit CouplingForce(const std::string & robotName1In,
                               std::ptrdiff_t robotIndex1In,
                               const std::string & robotName2In,
                               std::ptrdiff_t robotIndex2In,
                               const std::string & frameName1In,
                               pinocchio::FrameIndex frameIndex1In,
                               const std::string & frameName2In,
                               pinocchio::FrameIndex frameIndex2In,
                               const CouplingForceFunction & forceFunIn) noexcept;

    public:
        std::string robotName1{};
        std::ptrdiff_t robotIndex1{-1};
        std::string robotName2{};
        std::ptrdiff_t robotIndex2{-1};
        std::string frameName1{};
        pinocchio::FrameIndex frameIndex1{0};
        std::string frameName2{};
        pinocchio::FrameIndex frameIndex2{0};
        CouplingForceFunction func{};
    };

    using ProfileForceVector = std::vector<ProfileForce>;
    using ImpulseForceVector = std::vector<ImpulseForce>;
    using CouplingForceVector = std::vector<CouplingForce>;

    // ************************************** Robot state ************************************** //

    struct JIMINY_DLLAPI RobotState
    {
    public:
        void initialize(const Robot & robot);
        bool getIsInitialized() const;

        void clear();

    public:
        Eigen::VectorXd q{};
        Eigen::VectorXd v{};
        Eigen::VectorXd a{};
        Eigen::VectorXd command{};
        Eigen::VectorXd u{};
        Eigen::VectorXd uMotor{};
        Eigen::VectorXd uTransmission{};
        Eigen::VectorXd uInternal{};
        Eigen::VectorXd uCustom{};
        ForceVector fExternal{};

    private:
        bool isInitialized_{false};
    };

    // *************************************** Robot data ************************************** //

    struct JIMINY_DLLAPI RobotData
    {
    public:
        JIMINY_DISABLE_COPY(RobotData)

        /* Must move all definitions in source files to avoid compilation failure due to incomplete
           destructor for objects managed by `unique_ptr` member variable with MSVC compiler.
           See: https://stackoverflow.com/a/9954553
                https://developercommunity.visualstudio.com/t/unique-ptr-cant-delete-an-incomplete-type/1371585
        */
        explicit RobotData();
        explicit RobotData(RobotData &&);
        RobotData & operator=(RobotData &&);
        ~RobotData();

    public:
        std::unique_ptr<LockGuardLocal> robotLock{nullptr};
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
