duburcqa/jiminy/(commit log)

2019-11-03 Minor fixes. Minor architecture refactoring. Add doxygen documentation. (#3)
    * Remove joint limits.
    * Fix controller update period check.
    * Disable joint velocity limit.
    * Ignore vim swap files.
    * Fix force sensor data.
    * Add reset binding.
    * Add option zGround for contacts.
    * Add option for joint position and velocity limits.
    * Move binding into visitor.
    * Fix readme
    * Add documentation to Python code.
    * Add docstring documentation to gym_jiminy.
    * Minor refactoring.
    * Hot fix.
    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
    [Engine.h]
2019-11-08 Fix wrong computation of torque saturations. Log torque after clamp instead of before.
    Rename build dir in build_tools.
    Add verbose option for stepper.
    Add safety and special cases for some configuration parameters.
    Fix missing doc.
    Fix wrong computation for joint limits (and flexibilities?)
    Minor bug fixes. Improve error handling.
    Remove deprecated gepetto method calls.
    Fix broken physics using velocity bounds.
    [Engine.h]
2019-11-14 Add support of motor Inertia. (#17)
    * Improve robustness of numpy cmake file.
    * Add support of motor Inertia.
2019-11-15 Add motor inertia in computation of kinetic energy and rnea algorithm. Major refactoring. Beware it has NOT been extensively tested.
2019-11-20 Expose Model and AbstractController by reference in Python bindings of Engine class.
    [Engine.h]
2019-11-20 Uses shared pointer for Model and Controller to avoid free memory issues.
    [Engine.h, double_pendulum.cc]
2019-11-20 Add use-defined heatmap for the ground profile.
2019-11-20 Revert contact friction model.
    [Engine.h]
2019-11-23 [unit] Add basic framework for unit tests.
    Add gtest-based unit tests.
    Add simple sanity check for the overall simulation: check that the energy is constant on an unactuated system.
    [double_pendulum_rigid.urdf]
2019-11-23 Remove 'rawdata' sensor options that was poorly implemented.
    Improve bindings of sensor tyep to expose static type and fieldnames.
    Expose the future sensor data structure that be will pass to computeCommand.
2019-11-23 Return the sensor data in a dictionary rather than matrices. Various bug fixes with gepetto-viewer.
    [Engine.h, double_pendulum.cc]
2019-11-25 [core] Add missing Engine::getLogFieldValue needed for unit test.
    [Engine.h]
2019-12-28 Use packages for mesh import.
    [cartpole.urdf]
2020-01-12 Various bug fixes. Add extra argument to choose between theoretical or actual model.
    [dynamics.py, log.py, viewer.py]
2020-01-13 Fix support of Python2.7. Minor bug fixes.
    [viewer.py]
2020-01-29 [python] Add sensorData.keys(sensorType) method.
2020-02-11 Add simple pendulum example.
    [Foot.STL, PendulumArm.STL, PendulumMass.STL, simple_pendulum.urdf, world.STL]
2020-02-11 Switch pinocchio bindings to numpy array.
    [dynamics.py, viewer.py]
2020-02-16 [python] Fix Simulator object relying using wrong API.
    [simulator.py, viewer.py]
2020-02-17 [core] Add true sensor data to IMU object ; make get_log more user-friendly.
    - Add missing sensor reset in Model.cc
    - Make IMU.gyro log true gyroscope data (i.e. angular velocity in local frame) and add acceleration.
    - get_log now returns a dictionnary of data, instead of separated data and header.
    [Engine.h, log.py, simulator.py]
2020-02-17 Enable parsing of binary logfiles. Enable to register constant.
    - Fix comment issues and viewer display automatic opening.
    - Add new FileDevice that is used for parsing.
    - Rework getLogFieldValue to improve efficiency.
    [Engine.h, simulator.py, viewer.py]
2020-02-20 Fix and improve efficiency of dynamics helpers.
    [dynamics.py]
2020-02-21 Use advanced boost multi_index_container for efficient access to sensorData_t.
2020-02-22 Minor bug fix and performance improvement in dynamics helper.
    [dynamics.py]
2020-02-23 Add pip wheel generation to pywrap CMakefile.
    Add cmake helper to generate config files. Cleanup setup.py files and setup.sh installation script.
2020-02-23 Same install process between pip and cmake.
    Replace jiminy by jiminy_py.core.
    [simulator.py]
2020-02-24 [core] Modify reset mechanism to allow registration of new variables before each launch.
    Split old reset function into two functions:
    - Engine::reset that only performs reset, and thus enable reconfiguration of telemetry.
    - Engine::setState that also computes the initial state of the simulation.
    [Engine.h, simulator.py]
2020-03-02 Add options to user-define torque limits.
2020-03-02 Add option to log internal stepper steps.
2020-03-02 Fix bug with approx divisibility check of sensor/controller update periods.
2020-03-02 Fixup: code compiles now :)
    [Engine.h]
2020-03-02 Fix type error for logInternalStepperSteps
    [Engine.h]
2020-03-02 Rework handling of dt in step()
    [Engine.h]
2020-03-03 Cleanup telemetry.
    [cart_two_poles.urdf, double_cartpole.urdf, double_pendulum.urdf, simple_pendulum.urdf]
2020-03-05 Add dedicated methods to add/remove motor/contact points.
2020-03-06 Implement lock mechanism to avoid model alteration during simulation, and forbid concurrent simulations using the same model.
    [Engine.h, double_pendulum.cc]
2020-03-06 More consistent stepper API with start/step/stop methods.
2020-03-07 Implement custom single thread mutex/guard_lock mechanism.
2020-03-07 Rename Sensor into BasicSensor.
2020-03-07 Rename sensorDataHolder into sensorSharedHolder. Fix bug with delayMax being shared across models.
    [Engine.h]
2020-03-07 Add flag in start to specify theoretical or current model initial state. Change argument order of simulate method in accordance.
2020-03-07 Fix camel case / smake case.
    [Engine.h]
2020-03-09 Implement simple motor. Use AbstractMotors in Model. Use refreshProxies mechanism in sensor/motor/model. More consistent API.
2020-03-10 Clearer break-down motor/model/engine.
2020-03-10 Get Motor/Sensor no longer return a derived type since Boost Python handle it automatically.
    [double_pendulum.cc]
2020-03-11 Refactor sensor/motor creation.
2020-03-11 Add Python bindings for set/get motor options.
2020-03-12 Add torque sensor.
2020-03-12 Rename getId in getIdx for sensors and motors.
2020-03-12 Replace unordered_map by vector to keep track of the insertion order.
    [simulator.py]
2020-03-15 Make sure that dt of an external stepper step cannot start from a very small value.
2020-03-16 Avoid compounding of errors during integration leading to extremely small stepsize in some case.
    [Engine.h]
2020-03-16 Remove force clamp since it is no longer relevant as the physics has been fixed.
2020-03-16 Remove the energy from the stepper state.
2020-03-17 Replace result_t by hresult_t. More consistent coding style for io classes. Add generic Json reader/writer.
    [Engine.h]
2020-03-17 Fix recursive cmake include on Win32. Add json export for configHolder_t (WIP).
    [double_pendulum.cc]
2020-03-19 Fix compilation on Win32. Restore example.
    [double_pendulum.cc]
2020-03-20 Fix constant redefinition issue. Fix unit tests.
    [Engine.h]
2020-03-21 Fix Python bindings (bind Model class). Various fixes and minor improvements.
    [Engine.h]
2020-03-23 [unit_py] Add a unit test to verify the integrity of the physics being simulated.
    [linear_two_masses.urdf]
2020-03-25 [unit_py] Add unit tests on simple pendulum model
    Add python tests to verify the integrity of the physics being simulated on
    a pendulum model:
    - nonlinear pendulum simulation matches python integration.
    - adding rotor inertia has the expected effect of increasing output body inertia.
    [simple_pendulum.urdf]
2020-03-25 [core] Fix error in flexibility inertia ; add unit test.
    - Fix error when adding flexibilities to the model causing them to be added with non-negligible inertia.
    - Document why the way the flexibilities are simulated with Jiminy is consistent with the classical
    model of transmission flexibility, through the use of an equivalent system.
    - Add unit test to validate the addition of flexibilites to a model.
    [simple_pendulum.urdf]
2020-03-25 Increase TU tolerance. Increase patch tag.
    [test_simple_pendulum.py]
2020-03-26 Set UT tolerance to the expected value.
    [test_double_spring_mass.py, test_simple_pendulum.py]
2020-03-26 Rework shared_ptr usage wrt. official recommandations. More explicit constant names.
    [Engine.h, double_pendulum.cc]
2020-03-26 Get rid off boost shared ptr in Python bindings.
    [Engine.h, double_pendulum.cc]
2020-04-01 Flexibility inertia bug fix. Overwrite log file bug fix.
    [test_simple_pendulum.py]
2020-04-01 Do NOT update the velocity if dt is null.
    It may happens just after a controller update, in order to update ONLY the acceleration.
2020-04-01 Inherite Engine from EngineMultiRobot. Add Python bindings.
    [Engine.h, double_pendulum.cc, simulator.py]
2020-04-01 Implement coupling dynamics in core physics.
2020-04-01 Fix C++ / bindings bugs. Add TU for multi-robot engine (WIP)
    [linear_single_mass.urdf]
2020-04-01 Avoid copying const Eigen::Ref.
    [double_pendulum.cc]
2020-04-01 Fix Python/C++ function wrapper.
    [double_pendulum.cc, test_multi_robot.py]
2020-04-01 Throw error if dt is getting too small. Make sure that the forward kinematics has been updated before everything else.
2020-04-02 Fix segfault if calling getLog from Python with no telemetry configured.
    [test_multi_robot.py]
2020-04-05 Various improvements (#68)
    * Fix URDF.
    * Better use of Eigen vector with boost odeint.
    * Improve step size restoration mechanism because of breakpoints.
    * Add bulirsch-stoer stepper algorithm.
    * Fix callback not working.
    * Rework Runge-Kutta stepper to expose internal step adjustment mechanism.
    * Rework force impulse implementation and change of dynamics.
    [simple_pendulum.urdf]
2020-04-06 Various improvements (#70)
    * Extend the lifetime of robot/controller got through Engine.
    * Enable to initialize an engine without controller in Python.
    * Enable sensor telemetry by default. Fix motor/sensor init flag. Check if motor/sensor init before starting a simulation.
    * Add Unit Test to validate the contact dynamics on point mass.
    * Expose stiction ratio friction parameter. Rename some contact parameters for clarity and consistency.
    * Add Unit Test for the friction model.
    * Increase patch release tag.
    * Fix linux setup script.
    [point_mass.urdf]
2020-04-08 Add contact constraints support in Jiminy (#67)
    * [robot] Add capacity to simulate kinematic constraints
    * [engine] Externalize pinocchio algorithms from EngineMultiRobot.
    [linear_two_masses.urdf]
2020-04-11 Fix Windows support (#71)
    * Fix partially missing binary dependencies in setup.py
    * Create and distribute Python wheel on Windows..
    * Add missing Pillow Python dependency. Debug Boost search path.
    * Fix ambiguous Python executable path detection for dependencies on Windows.
    * Improve cmake Python executable detection.
    * Fix boost includes jiminy dependency not propagated to targets relying on it.
    * Use meshcat if gepetto not available. Fix deprecated '.A' missing out.
    * Fix Python binary log parser
    [double_pendulum.cc, test_double_spring_mass.py, viewer.py]
2020-04-11 Fix deploy on Pypi for Windows (#74)
    * Fix Pypi on CI Win32.
    * Ensure cross-plateforme accurate real_time display (if possible)
    [viewer.py]
2020-04-12 [jiminy_py] Add jupyter notebook tutorial to document basic usage. (#72)
    * [jiminy_py] Add jupyter notebook tutorial to document basic usage.
    [simple_pendulum.urdf]
2020-04-13 Do not allocate memory to get sensor data (#76)
    * Detect Boost Python in base.cmake to avoid code duplication in sub-packages.
    * Replace Id by Idx for consistency.
    * Do not allocate memory to get sensor data. Get sensor data only once per simulation.
    * Add Pypi deploy on CI Win32.
    [FixedFrameConstraint.cc, PinocchioOverloadAlgorithms.h]
2020-04-17 Fix Pypi deploy for Linux and Windows (#81)
    * Refactor CI to properly support Pypi deploy for Windows and manylinux.
    * Improve Viewer backend management.
    * Fix ode step too small error not properly handled.
    * Fix simple pendulum example script.
    * Make sure that the internal buffer of python force functors are properly initialized to zero.
    [simple_pendulum.urdf]
2020-04-18 Various minor improvements (#83)
    * Add cmake fallback in case tinyxml is not listed as dependency.
    * Add extra option to viewer to enable stating in pause in command line mode.
    * Fix Pypi wheel deployement on Linux and Windows.
    * Rename viewer 'speed_ratio' into 'replay_speed'.
    [viewer.py]
2020-04-18 Fix PyPi deploy (#84 + Hot fix)
    * Fix Pypi wheel deploy
    * Add generic FctInOutPyWrapper enabling wrapping functions with output in argument instead of return.
2020-04-19 Minor improvement (#87)
    * Make sure that the initial camera position is the same for meshcat and gepetto-gui.
    * Update install doc.
2020-04-22 Various improvements (#88)
    [jiminy core] Add jointType attribute to the motor. Only support linear and rotary joints for motors.
    [jiminy core] Replace Torque by Effort to be appropriate for both rotary and linear joints.
    [jiminy core] Add prefix 'joints' to the ambiguous fields (Position|Velocity)Limit*.
    [jiminy core] Define more appropriate position/velocity/effort limits for non-physical joints.
    [jiminy_py C++] Improve pinocchio/eigenpy 'submodule' management.
    [jiminy_py C++] Add getters and expose sensor type specific properties. Fix wrong exposure of the sensors names.
    [jiminy_py C++] Fix Robot class used instead of Model in Jiminy bindings.
    [ji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
    [cartpole.urdf]
2020-04-24 Various improvements (#90)
    * Improve gym robot obsversation space universal bounds mechanism. Gather all sensors in observation subdict 'sensor'.
    * Define new nmotors proxy.
    * Refactor Engine asynchronous. Add default implementations to gym generic robot class.
    * Engine asynchronous *
    - Better handling theoretical VS real robot state.
    - Replace observation by sensor_data.
    - Improve management of internal buffers and getters.
    * Gym generic robot *
    - Add sensor_data internal buffer
    - Add default implement for _sample_state and _get_obs
    * Add default implementation of step of the gym generic robot environment.
    * Throw an error when trying to start multiple times a simulat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
2020-04-27 Minor improvements (#91)
    * Fix Python2 support.
    * Update Linux PInocchio dep to 2.4.3, which add a new backend viewer panda3d.
    * Remove bipedal walking specific dynamics utilities.
    * Replace pnc by pin as pinocchio Python alias.
    [dynamics.py, test_double_spring_mass.py, test_multi_robot.py, test_simple_pendulum.py, viewer.py]
2020-04-27 Implement more versatile viewer data extractor from log. (#92)
    * Implement more versatile viewer data extractor from log.
    * Remove code redundancy. Add camera placement option to play_trajectory method.
2020-04-29 Various improvements (#94)
    * Fix cartpole example. Update to Pinocchio 2.4.3 for manyinux wheel.
    * Add time to the observation dict. Fix _update_observation. Varous minor fixes.
    * Enable to automatically detect the most appropriate contact frame when computing the freeflyer.
    * Add more dynamics helpers and fix existing ones.
    [dynamics.py, log.py, viewer.py]
2020-05-04 [jiminy_py] Add option for plotter to compare several logfiles. (#93)
    * [core] Fix bug in FixedFrameConstraint resetProxies.
    * [jiminy_py] Viewer: make _get_colorized_urdf work with URDF that use the relative 'package://' syntaxe.
    * [jiminy_py] Add option for plotter to compare several logfiles. Implement interactive legend.
    * Use cmake to sync version release tag with python packages.
    [FixedFrameConstraint.cc, viewer.py]
2020-05-04 Gym improvements (#96)
    * Specialization of the generic gym robot learning spaces must be done in _refresh_learning_spaces.
    * Add optional 'debug' option to the generic gym robot env.
    * Fix missing time in gym robot observation space.
    * Add gym FlattenObservation env wrapper.
    * Fix dyn tools.
    * Viewer lock is now fully managed internally whenever it is possible.
    * Various minor fixes. Add optional parameter to retrieve_freeflyer to enforce freeflyer continuity.
    * Automate jiminy-py version requirement for gym-jiminy. Fix wring LD_LIBRARY_PATH during pip install cmake subprocess.
    [dynamics.py, viewer.py]
2020-05-12 [gym_jiminy] Remove stable_baselines hard dependency (#102)
    * Removing stable_baselines dependencies.
    * Add asynchronous keyboard interaction tools. Add play interactive method for generic gym robots. Add specialization for the cartpole.
    * More relevant default stepper dtMax.
    * Update example env discrete action.
    * Add rllib examples.
    * Refactor gym unit architecture (rename 'unit' in 'examples').
    * Fix safety margins for observation space bounds.
    * Update Readme.
    * Fix dynamics helpers.
    * Fix support of latest pinocchio release.
    * Do not protect default options.
    [dynamics.py, viewer.py]
2020-05-16 Release Jiminy 1.2.35 (#110)
    * Add missing requirement 'xmltodict'
    * Fix meshcat viewer not able to display more than one robot correctly.
    * Remove unused plotter.py file: duplicated content from log.py
    * Allow comparison of logs of different length.
    * Various minor improvements.
    * Update pinocchio to v2.4.4 for Manylinux pip wheels.
    [log.py, viewer.py]
2020-05-26 Release Jiminy 1.2.36 (#113)
    * [core] Allow change in the unit used to log the simulation.
    * [core] Improve position and velocity bounds to avoid numerical instabilities.
    * [jiminy_py] Add Python repr to the engine's stepper state.
    * [gym_jiminy] Fix EngineAsynchronous. Add Tianshou framework example.
    * [jiminy_plot] Do not render empty subplot. Properly handle empty wildcard expr.
    [log.py]
2020-06-07 Release 1.3.37 (#127)
    * [core] Better support of shared array between Python/C++ (including bug fix)
    * [core] Fix bug in drift computation for fixed body constraints
    * [core] Add timeout option to the engine stepper
    * [core] Add frame placement computation
    * [core] Fix sensor init with delay.
    * [core] Specific bias + noise implementation for IMU quaternion: Use IMU rotation for bias and small angle hypothesis for the noise, more consistent as true sensor bias.
    * [jiminy_py] Enable constructor to SensorData (sharing memory with Python)
    * [unit] Add unit test for sensors: both raw measurement, and noise / bias / delay
    * [doc] Update installation instructions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
    [double_pendulum.cc, test_simple_pendulum.py]
2020-06-18 Jiminy release 1.3.38 (#132)
    - [core] Proper initialization of pinocchio data (rigid+flexible)
    - [core] Make sure that the timeUnit makes sense.
    - [jiminy_py] get_body_world_transform returns by value or by reference (the default is now by value)
    - [jiminy_py] Rename sensor_data in sensors_data for consistency.
    - [jiminy_py] Rename _engine in engine in EngineAsynchronous and enable to specify the jiminy Engine.
2020-06-19 Jiminy release 1.3.40 (#139)
    * Fix running gepetto-gui detection bug.
    * Add new _setup_envrionment method to the generic robot environment.
    * Fix a bug with engine asynchronous initial state and improve initialization by providing meaningful initial sensors data.
    [viewer.py]
2020-06-30 Jiminy release 1.2.41 (#146)
    - [jiminy_py] Replace ValueError by RuntimeError when the error is not directly related to argument type or value error
    - [jiminy_py] Add new attribute to Viewer to keep track of backend's parent and associated subprocess
    - [jiminy_py] EngineAsynchronous only setup the camera pose if it is the backend's parent
    - [jiminy_py] Add optional argument 'viewers' to 'play_trajectories' to use existing viewer for display, then return the used ones
    - [jiminy_py] Add non static close method to Viewer, that remove the associated robot, and closes backend (only if the instance opened it)
    - [jiminy_py] Automatically delete robot when closing.
    - [gym_jiminy] Gym robot no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
    [dynamics.py, simulator.py, viewer.py]
2020-07-02 Jiminy release 1.2.42 (#152)
    - [core] Fix formula for handling external torques was wrong
    - [core] Fix force sensors returned values in the world frame instead of their sensor frame
    - [core] Fix issue with quaternion integration slowly diverging from SE3 over time
    - [jiminy_py/EngineAsync] Fix initial pinocchio data
    - [jiminy_py/EngineAsync] Do not enforce dtMax as it should already be fine
    - [jiminy_py/Viewer] Automatically delete robot when closing
    - [jiminy_py/Viewer] Add support of node deletion for meshcat viewer
    - [jiminy_py/Viewer] Improve viewer backend availability check
    - [jiminy_py/Viewer] Enable to connect to any existing zmq meshcat server hosted locally on any port
    - [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
    [point_mass.urdf]
2020-07-08 Jiminy release 1.2.43 (#157)
    - [jiminy_py/Viewer] Remove restriction of `refresh` method to `use_theoretical_model = False`. Incidentally, it fixes exception raising at init for `use_theoretical_model = False`
    - [jiminy_py/Viewer] Fix bug opening new navigator window even if `is_backend_parent = False` for `meshcat` backend
    - [jiminy_py/Viewer] Fix detection of meshcat server executed using `meshcat-server` executable script (Python "entry-point").
    [viewer.py]
2020-08-11 Use absolute instead of relative margins for robot joint limits.
2020-08-11 Increase gym robot joint margins to fix out-of-bounds issue for terribly wrong command.
2020-08-11 In-depth Jiminy Viewer refactor (#160)
    In-depth Jiminy Viewer refactor
    - Add capture frame capability using meshcat backend
    - Add set camera transform capability to meshcat backend
    - Enable customization for meshcat viewer environment, starting with same camera fov and checkboard ground than gepetto-gui
    - Enable bi-directional communication between meshcat web client and python zmq socket
    - Enable synchronization with client for meshcat. Enable to wait for loading meshes in meshcat clients
    - More robust subprocess termination
    - Improved exception handling. Avoid many exceptions. Only catch exception when appropriate.
    - Improve compliance with PEP8
    - Add missing documentation for V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
    [viewer.py]
2020-08-11 Add record trajectories option (#163)
    * Add record trajectories option
    * Fix robot deletion issue in viewer.
    * Increase velocity bounds for gym obs space to make sure it never goes out-to-bounds.
    [viewer.py]
2020-08-11 Add support of meshcat 0.0.18 for Pypi support. Minor bug fix. Update minor release tag.
    [viewer.py]
2020-08-23 Fix viewer not working in viewer. Redirect meshcat 'static' url without trailing '/'. Fix favicon request.
    [viewer.py]
2020-08-23 [Gym] Remove extra bounds (#167)
    * No longer add extra margins to the robot observation space and rather abort simulation.
    * Enable post-processing of gym robot observation. Use it to clamp returned observation by default.
2020-08-23 [Gym] Support and extend Mujoco Gym API (#168)
    * Support and extend Mujoco gym API.
    * Add now 'replay' to any gym robot environments.
    * Catch engine exception to avoid gym robot step failure.
    * Add reward info in dedicated field.
    * Properly handle engine async viewer backend exception.
    * Fix play_trajectory video recording.
    * Do not throw exception if viewers in input are no longer available.
    * Gym robot 'render' method now supports 'mode' argument.
    * Remove robot name attribute from gym robot env.
    * Improve temp file management.
    * Viewer now creates unique robot_name if not specified.
    * Add set_state method to match Mujoco API.
    * Improve documentation.
    * Various bug fixes.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
    [viewer.py]
2020-08-23 [jiminy_py] Fix support of capture_frame on Windows and Jupyter. (#170)
    * Enable capture frame in Jupyter notebook using background process and IPC.
    * Merge video recording options in a single one.
    * Do not throw error but warning if 'wait' is not available. Add option to disable viewer auto open gui. Bug fixes.
    * Do not kill meshcat server and recorder and SIGINT is raised. Fix capture frame not waiting for mesh loading.
    * Move meshcat server and recorder process methods in dedicated file to fix 'spawn' support (Win10).
    * Patch pyppeteer to properly ignore SIGINT. Make sure multiproc manager are properly closed.
    * Improve default meshcat camera pose. Fix viewer open_gui if already exi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
    [viewer.py]
2020-08-24 [Viewer] Fix and improve video recording (#172)
    * Add camera travelling option to play_trajectory and Viewer.replay methods. Support video recording for any trajectories.
    * Update doc. Fix FPS and enforce file extension.
    * Use mp4 container format and VP9 container for browser compatibility.
    [viewer.py]
2020-08-24 Fix video recording not working with gepetto-gui. Fix logger warning filtering. (#173)
    [viewer.py]
2020-08-24 Fix and improve video recording (#174)
    * Reduce video recording fps. Do not enforce multiprocess spawn on linux. Fix meshcat camera using capture_frame.
    [viewer.py]
2020-08-24 [Viewer] Fix and improve camera travelling. (#175)
    [viewer.py]
2020-08-24 [Viewer] Correct robots offset during video recording (#176)
    * Correct robots offset during video recording
    [viewer.py]
2020-08-24 [Viewer] Fix signal handling and improve camera traveling. (#177)
    [viewer.py]
2020-08-26 [Viewer] Detach camera if it has been attached by play_trajectory. (#179)
2020-08-26 [Viewer] Improve meshcat capture frame efficiency (#180)
    * Disable meshcat client 'animate' loop for backend recorder.
    * Capture and save frame in webp format for meshcat for efficiency.
2020-08-26 [Viewer] Minor cleanup and improvement (#181)
    * Minor cleanup.
    * Default video recording resolution 800x800 instead of 1000x1000 to speed-up.
    * Fix meshcat client redirection without trailing backslash.
    [viewer.py]
2020-08-26 [Viewer] Speedup meshcat video recording (#182)
    * Viewer Meshcat meshes_loaded now support specified the scene and robot name.
    * Add dedicate meshcat wrapper which handles video recording directly.
    * Update WebM Writer directly to enable framerate and quality setting.
    * Dramatically improve recording speed using meshcat from 2FPS to 10FPS.
2020-08-31 [Viewer] Add native support of Jupyter and Google Colab (#187)
    * [Viewer] Native and full support of Jupyter and Google Colab, using directly kernel communication
    * [Viewer] Remove the support of port forwarding, since it is not longer relevant
    * [Viewer] Create display cell in notebook mode when instantiating a viewer while no display cell is already available
    * [Viewer] Check for browser availability when calling 'open_gui', and wait for the client to be ready
    * [Viewer] Avoid timeout on low-hand machine while starting video recording
    * [Viewer] Improve the reliability of running Meshcat server detection.
    * [Viewer] Remove heartbeat check since it is impossible to estimate appropriate resp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
    [simulator.py, viewer.py]
2020-09-01 Various minor fixes and improvements. (#189)
    - [Viewer/play_trajectories] Do not delete robot automatically in Notebooks
    - [Viewer] Set default backend
    - [Viewer] Fix fix_mesh_path
    - [Viewer] Fix index.html
    - [Viewer] Bypass chrome/webgl GPU backlisting
    - [Viewer] Fix chrome executable path for Google Colab
    - [Meshcat/server] Use set to manage comm pool
    - [BasicSimulator] Fix callback
    - [engine_async] Update default engine_async camera pose.
    - [misc] Fix notebook.
    - [misc] OpenCV is now an optional dependency
    - [misc] Always generate pip wheels artefacts for both Linux and Windows on CI
    [simulator.py, viewer.py]
2020-09-01 [Viewer] Fix kernel exception and stack corruption in notebooks (#190)
    * Only process kernel comm messages on the spot.
    * Do not examine ipython port while looking for zmq meshcat.
    [viewer.py]
2020-09-01 [Viewer] Fix support of Google Colab (#191)
    * Do not apply the optimized patch for handling kernel shell messages selectively for ipykernel < 5.0.
    * Fix display window size on Google Colab.
    [viewer.py]
2020-10-11 Jiminy 1.4 (#207)
    * [Gym] Generic locomotion envs - PART I (#194)
    * [Viewer] Replace multi args "," delimiter by "|" to allow comma in path. Raise exception is
    * [Gym] Major rework to add base locomotion learning environments.
    * [Core] Implement methods to add and remove frames from the robot model.
    * [Core] Add 'mechanicalReduction' option to the motors.
    * [Core] Add support of mesh collisions using HPP-FCL. Migration to pinocchio/eigenpy v2.5.0.
    * [misc] Cleanup cmake config file to implement actual legacy mode for Ubuntu18. Update Ubuntu 18 easy install deps.
    * [misc] Add official support of Ubuntu 20.
    * [Core] Add support of body collision with the ground, but do NOT actually c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
    [Foot.STL, PendulumArm.STL, PendulumMass.STL, SecondPendulumArm.STL, SecondPendulumMass.STL, box.STL, box_collision_mesh.urdf, cart.STL]
2020-10-12 [gym] Add ANYmal and Atlas learning environments. (#210)
    * [python] Vairous minor improvements.
    * [gym] Add ANYmal example.
    * [gym] Add Atlas learning env.
    * [misc] Update release Patch tag.
    [GRIPPER_OPEN_chull.obj, anymal.urdf, atlas_v5.urdf, head.obj, head_camera.obj, head_camera_chull.obj, head_chull.obj, l_foot.obj]
2020-10-16 Jiminy 1.4.2 (#212)
    * [misc] Reorder warning compile flags.
    * [misc] Fix several coding style issues.
    * [misc] Minor README update.
    * [misc] Remove unused toys models.
    * [examples] Use pinocchio::neutral instead of Zero to get neutral config.
    * [core] Fix segfault when writing log while no data is available.
    * [core] Refresh model proxies automatically when position/velocities bounds are modified.
    * [core] Rename 'motor_inertia' in 'motors_inertias' for API consistency.
    * [core] Add getter for max simulation duration.
    * [python/simulator] Fix bug during initial state retrieval.
    * [gym] Improve internal buffer management. Add several assertion checks at gym env instantiation. Minor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
    [acrobot.urdf, cart_two_poles.urdf, cartpole.urdf, double_cartpole.urdf]
2020-10-22 Jiminy 1.4.3 (#213)
    * [misc] Minor README + doxygen mainpage update.
    * [misc] Drop support of Pinocchio < 2.3.0.
    * [misc] Fix python wheel development status.
    * [misc] Full PEP8 conformance.
    * [misc] Copy C++ documentation in Boost Python bindings.
    * [misc] Migrate to Sphinx RTD documentation instead of Doxygen.
    * [core/pywrap] Improve bp::dict conversion efficiency by avoiding attribute lookup.
    * [core/pywrap] Fix constraint attribute getter names.
    * [core/pywrap] Rename Controller 'register_variable*' for consistency.
    * [gym] Add missing Tianshou acrobot example.
    * [gym] Fix obs not contained in obs space because of '_sensors_data' buffer not being an actual 'dict' object.
    *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
2020-10-23 Jiminy 1.4.4 (#215)
    * [misc] Update doc of ANYmal URDF file.
    * [misc] Add Spotmicro robot example.
    * [core/model] Fix addFrame.
    * [core/model|gym] Add small tolerance for Lie algebra bounds to avoid rounding issues.
    * [python/dynamics] Fix update_quantities frames poses not always updated.
    * [python/robot] Extract motor dynamics from URDF and enable motor friction by default.
    * [python/robot] Link with collision geometry associated with fixed joint can now be considered as valid leaf.
    * [python/robot] Fix geometry type not properly determine during collision bodies definition substitution.
    * [python/robot] Take into account mesh scale while replacing mesh by minimum volume box vertices.
    * [p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
    [anymal.urdf, backpart.stl, foot.stl, frontpart.stl, larm.stl, larm_cover.stl, lfoot.stl, lshoulder.stl]
2020-10-24 Jiminy 1.4.5 (#216)
    * [misc] Remove compatibility code with Pinocchio < 2.4.4.
    * [core] Use static cast instead of dynamics for collision geometry retrieval.
    * [core] Fix issue with convex collision mesh scaling.
    * [python/meshcat] Server now keeps track of object properties to synchronise them between clients (for example "visible").
    * [python/meshcat] Achieve features parity with gepetto-gui: added support of Cone/Capsule/Convex shapes.
    [simulator.py, viewer.py]
2020-10-30 [gym] Split gym_jiminy in multiple packages (#218)
    * [misc] Add copyright Pinocchio when necessary.
    * [misc] Do not start URDF with comments since it is not properly supported.
    * [misc] Cleanup unit test cmake config.
    * [misc] Add support of ASCII art diagram in docs.
    * [misc] More robust and versatile cmake pip install and wheel generation helpers.
    * [misc] Improve CI scripts and remove warnings during build docs.
    * [core] Use collisionResults instead of distanceResults to compute collisions for efficiency. Use 5 contact points by default.
    * [core] More robust normal and penetration depth handling for collisions.
    * [core] Fix edge case where the controller could be updated twise suc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
    [box_collision_mesh.urdf, point_mass.urdf, simple_pendulum.urdf, sphere_primitive.urdf]
2020-11-06 [gym] Add generic observe/control interfaces. (#220)
    * [misc] Update Meshcat to v0.0.19 and remove backported code.
    * [misc] Remove extra layer of indirection for import of Python bindings.
    * [misc] Fix Atlas collision sphere size to fix display in Meshcat.
    * [misc] Remove text image from ANYmal to avoid Meshcat viewer failure to load meshes.
    * [misc] Enable pylint Python linter and pypy static type checker for gym/common and gym/toolbox on CI.
    * [core] Fix various edge case segfault. Minor style update.
    * [core] Add dedicated 'Macro.h' header file.
    * [core] Add macro to print error message. Add filename and line number in error message.
    * [core/python] 'register_variable*' methods n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
    [atlas_v5.urdf]
2020-11-06 [gym] More modular control/observe interface (#221)
    * [gym] More modular control/observe interface to be more flexible and avoid duplications.
    * [gym] Replace 'set_zeros' by 'zeros' to support immutable spaces.
    * [gym] Various bug fixes, typing and style.
    [control_impl.py, env_bases.py, env_locomotion.py, generic_bases.py]
2020-11-06 [core|gym] Log data using 64bits variables, Add unit tests to Gym Jiminy. (#222)
    * [misc] Remove old deprecated docstring style.
    * [misc] Enable to re-run automatic build scripts.
    * [misc] Install numba on CI instead of 'easy_install_ubuntu.sh' script.
    * [misc] Add-back Pinocchio StdVec_* converters.
    * [misc] Fix Pinocchio imported twise that was messing up with boost python converters on Windows.
    * [core] Log variable in 64bits instead of 32bits (and drop compatibility with old proprietary parser).
    * [core] rename constant 'TELEMETRY_MAX_BUFFER_SIZE' in 'TELEMETRY_MIN_BUFFER_SIZE' for consistency.
    * [core] Consistent style over the whole codebase.
    * [core] Do not raise an exception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
    [control_impl.py, dynamics.py, env_bases.py, env_locomotion.py]
2020-11-06 [Gym] Generic pipeline design (#223)
    * [misc] Fix compatibility with Python < 3.7 on Win. Set recorder thread to high priority.
    * [python] Fix deprecation warning(s).
    * [python/meshcat] Factorize 'Capsule' implementation.
    * [python/meshcat] Silent logger messages from backend recorder.
    * [gym] Rename 'controller_dt' in 'control_dt'. Take into account controller's rewards in pipeline wrapper.
    * [gym] Fix 'control_dt' not updated for 'BaseControllerBlock'. Block now has wrapped env in arg instead of unwrapped one.
    * [gym] Remove support of with 'observe_target' for 'ControlledJiminyEnv' because of no real usecase.
    * [gym] generic pipeline generator.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
    [block_bases.py, control_impl.py, env_bases.py, env_locomotion.py, generic_bases.py]
2020-11-12 [misc] Use static linkage for every Boost components except Python (#226)
    * [misc] Use static linkage for every Boost components, except Boost Python.
    * [misc] Robust patches encoding handling for Window build dependencies script.
    * [misc] Add auditwheel-like processing to sanitize windows Python wheels.
2020-11-12 [misc] Various minor fixes and improvements. (#227)
    [simulator.py]
2020-11-16 [core] Enable to access sensors group shared data matrices by reference without copy.
2020-11-16 [python] Handle more exceptions. Fix display in Spyder IDE.
    [controller.py, simulator.py, utilities.py, viewer.py]
2020-11-16 [gym] Rework observation block to support multiple update period and more flexible pipeline architecture.
    [block_bases.py, control_impl.py, controller.py, env_bases.py, generic_bases.py]
2020-11-17 [gym] Fix set seed simulator. Do not reset env at init. Fix cartpole 'compute_command'.
    [env_bases.py, pipeline_bases.py]
2020-11-17 [gym] Fix 'write_log' missing format.
    [env_bases.py, simulator.py]
2020-11-17 [gym] Add 'is_running' attribute to 'BaseJiminyEnv' to check that 'reset' has been called before 'step'.
    [env_bases.py]
2020-11-18 [gym] Various minor bug fixes.
    [block_bases.py, generic_bases.py]
2020-11-18 [gym] Refactor 'reset' of gym environment to fix initial state inconsistency and make everything simpler.
    [env_bases.py, pipeline_bases.py, test_pipeline_control.py]
2020-11-19 [gym] Make sure environments are fully configured at init. (#229)
    * [core] Catch some seldom exceptions.
    * [core] Enable to call 'initialize' multiple times for 'Engine*'.
    * [core] 'isSimulationRunning' is set to True at the end of 'start' instead of the beginning.
    * [core|python] Several critical bug fixes.
    * [gym] Make sure the environment is completely initialized at '__init__', which is expected by OpenAI Gym API.
    * [gym] Fix some internal buffersnot properly reset.
    * [gym] Fix base env '_setup' method not called at reset.
    * [gym] Send zero motor efforts at reset since the initial action is undefined.
    [block_bases.py, control_impl.py, controller.py, dynamics.py, env_bases.py, env_locomotion.py, generic_bases.py]
2020-11-21 [gym] Fix 'step' observation not consistent with system state. (#230)
    * [core] Add 'PRINT_WARNING' macro, to print debug message when compiling in debug mode only.
    * [core] Update sensors data at the end of 'step' for consistency with robot state.
    * [python] Replace 'BaseJiminyController' controller by 'BaseJiminyObserverController' to add dedicated observer support.
    * [gym] Controller/observer blocks must be fully configured at init. Block '_setup' is now called at 'reset'.
    * [gym] Fix observe/control update period computed at init instead of reset.
    * [gym] Take advantage of new dedicated observer.
    * [gym] 'get_observation' recursively shadow-copy observation before returning it to av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
    [block_bases.py, control_impl.py, controller.py, env_bases.py]
2020-11-24 [core] Consistent telemetry data. (#231)
    * [core] Enable to specify the initial acceleration optionally.
    * [core] Log command instead of motors efforts at engine level.
    [core] Fixes hasDynamicsChanged not being set to false after recomputing the dynamics for FSAL stepper hypothesis.
    * [core] Fetch telemetry right after updating command but before integrating the dynamics.
    [core] Log data at the min(controller_period, sensors_period) if > 0, every internal steps otherwise
    * [gym] Fix argument forwarding with multiple inheritence.
    * [gym] Add pipeline design unit tests.
    [Engine.h, double_pendulum.cc, env_bases.py, pipeline_bases.py, simulator.py, test_pipeline_control.py]
2020-11-29 [core] Improve joints position/velocity bounds enforcement (#233)
    * [core] PRINT_* macros do not terminate by ;
    * [core] Bounds limits efforts are now propotional to joint's subtree inertia.
    * [core] Remove blending factor for joint bounds because it does more harm than good.
    * [core] Use C++17 constexpr in some places.
    * [core] Add constexp 'is_pinocchio_joint_*_v' to determine the type of joint at compile type.
    * [core] Add support of translation joints. Improve get joint type getter to use joint visitor instead of string comparison.
    * [core] Support any 1D type of joints for rotor inertia.
    * [core] Fix edge case when reading log after calling start and no actual data is available.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
    [AbstractConstraint.cc, PinocchioOverloadAlgorithms.h, dynamics.py, env_generic.py, env_locomotion.py, simulator.py]
2020-12-01 Jiminy release 1.4.17 (#236)
    * [python] Remove unecessary 'range(len(.*))'.
    * [python] Use tuple comparison operator for python version.
    * [python] More robust list type checking.
    * [python] Fix color not taken into account in some cases.
    * [python|gym] Move 'replay' method from 'BaseJiminyEnv' to 'Simulator'.
    * [python/simulator] Fix bugs and glitches for 'plot' method. Disable inter-tab sync of x-axis (time).
    * [python/simulator] Catch more exceptions. Forbid render if no simulation running.
    * [python/simulator] Ensure proper argument forwarding for 'replay' method.
    * [python/viewer] Enable to change color of already instantiated robot in viewer.
    * [python/viewer] Fix robot names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
    [dynamics.py, env_generic.py, simulator.py, test_double_spring_mass.py]
2020-12-02 [python/viewer] Fix edge case make the robot not appear in viewer if closed manually and reopen with same name.
    [simulator.py, viewer.py]
2020-12-04 [python] Improve stability and reliability. (#240)
    * [misc] Fix telemetry format doc.
    * [core/python] Fix segfault when reading log without data.
    * [python] Improve typing.
    * [python/simulation] Fix exception handling at reset.
    * [python/simulator] Throw error and replying simulation without data.
    * [python/simulator] Remove useless check for '__getattr__'.
    * [python/viewer] Do not refresh camera pose automatically if no camera motion nor travelling.
    * [python/viewer] Ensure unique robot names during replay.
    * [python/viewer] Fix color handling for robot with reference material.
    * [python/viewer] Fix exception if viewer arg is None for play_trajectories.
    * [python/viewer] Add s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
    [robot.py, simulator.py, utilities.py, viewer.py]
2020-12-06 [gym] Rework memory management to improvement performance. (#241)
    * [core] Print error and warning messages on stderr instead of stdout.
    * [core] Fix segfault in some cases when 'start' method fails.
    * [core] Always remove robot lock when calling Engine.Stop.
    * [core/python] Add extra parameter to convertToPython to return either reference or copy.
    * [core/python] Preserve constness of systemState Python bindings.
    * [python|gym] Add unsafe set handle for controller to avoid of the cost of handling initialization separately.
    * [gym] Use np.core.umath.* directly for efficiency.
    * [gym] Reorder branches of some helper methods to find most frequent case first.
    * [gym] Use 'dict/{}' in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
    [block_bases.py, controller.py, env_generic.py, env_locomotion.py, generic_bases.py]
2020-12-07 [python|gym] Performance improvement. (#242)
    * [core/python] Do not use Eigenpy to convert systemState.q/v/a to improve efficiency and preserve constness.
    * [python/viewer] Enable to add legend in Meshcat.
    * [python/viewer] Enable to add logo in meshcat.
    * [python/viewer] Add 'legend' and 'logo_fullpath' optional argument to 'play_trajectories'.
    * [python|gym] Add Python native 'is_simulation_running' attribute to Simulator for fast access.
    * [gym] Define shared memories/proxies at init when possible.
    * [gym] Replace 'engine' proxy by 'simulator' for greater flexibility.
    * [gym/envs] Improve performance.
    [env_generic.py, env_locomotion.py, generic_bases.py, log.py, pipeline.py]
2020-12-08 [python/viewer] New dedicated widgets manager. (#244)
    * [python/viewer] Add new dedicated widgets manager.
    * [python/viewer] Enable to capture widgets on top of three.js rendering.
    * [python/viewer] Always capture frames in '.png' format.
    * [python/viewer] Disable legend if not all robots have colors when replaying trajectories.
    * [python/viewer] Fix replay when at least one of the trajectories is empty.
    [viewer.py]
2020-12-14 Jiminy release 1.4.24 (#249)
    * [core/python] Split bindings in multiple files to reduce compilation time.
    * [core/python] Engine flag 'getIsSimulationRunning' is now returned by reference, fixing a bug with copy proxy.
    * [python/simulator] Fix low-level reset/simulate methods wrongly called.
    * [python/simulator] Fix generic time-series 'plot' method if data is missing.
    * [python/viewer] Fix tuple urdf_rgba support.
    * [python/viewer] Fix legend not showing up in some cases.
    * [python/viewer] Fix legend font on Windows.
    * [python/viewer] Rename logo in watermark for clarity.
    * [python/viewer] Add support of 'jpeg', 'svg' formats and url path for watermark.
    * [python/viewer] Set ma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
    [AbstractConstraint.cc, Engine.h, FixedFrameConstraint.cc, PinocchioOverloadAlgorithms.h, WheelConstraint.cc, simulator.py, viewer.py]
2020-12-16 [core] Fix velocity bounds not taken into account for unbounded joints.
2020-12-16 [core] Display warning messages if position/velocity bounds are enabled but not implemented.
2020-12-16 [gym] Fix invalid debug write log format.
    [env_generic.py]
2020-12-16 [gym] Test more classic control problem. Fix convergence issues on Windows.
    [test_training_toys_models.py]
2020-12-16 [gym] Improve robustness of learning unit tests.
    [acrobot.urdf]
2021-01-14 Jiminy release 1.5.0 (#266)
    * [core] Log the robot input args, robot model, and all options as constants.
    * [core] Double space before inline comments.
    * [core/python] Simplify C++ to Python log converter.
    * [python/log] Fix print logged variables.
    * [core] Add constant for telemetry constant delimiter.
    * [core] Store constants in hdf5 datasets instead of attributes to get around 64K size limit.
    * [core] TMLC telemetry format now supports both attributes and dataset field.
    * [python/viewer] Split viewer and replay tools in separated submodules to reduce file complexity.
    * [core] Clarity telemetry namespace.
    * [gym] Make viewer instance directly accessible in pipeline environment. (#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
    [Engine.h, PinocchioOverloadAlgorithms.h, double_pendulum.cc, env_generic.py]
2021-01-15 [core] Fix memory corruption segfault after adding frame to model. (#269)
    * [misc] Update pre-compiled binaries of dependencies (EigenPy 2.6.0, Hpp-Fcl 1.6.0, Pinocchio 2.5.5).
    * [misc] Fix several cmake edge cases.
    * [misc] Enable linker optimizations.
    * [core] Take advantage of new features and improved Windows 10 support to simply codebase.
    * [core] Fix flaky memory corruption segfault when adding frame to model.
    * [core] Fix special cmake linkage flags 'optimized'/'debug' not being properly detected for Boost.
    * [python/simulator] Fix progress bar glitches if simulate raises an exception during a simulation.
    [controller.py, simulator.py]
2021-01-17 Jiminy 1.5.2 (#271)
    * [misc] Disable compilation LTO since it is not really improving anything.
    * [core] Do not throw exception when calling addCollisionBodies with empty list and no geometry model.
    * [core] Fix initialization of engine without controller.
    * [core/python] Add getters for controller's robot model and sensors data.
    * [core/python] Support engine init using callback only. Using single init method with default None args.
    * [core/python] Enable direct inheritence of Python controllers from AbstractController.
    * [python] Replace dedicated '.hdf'/'.config' extensions by '_hardware.toml'/'_options.toml' for clarity.
    * [python/robot] Enable to "fix" (aka override) relative mes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
    [Engine.h, controller.py, env_locomotion.py, robot.py, simulator.py]
2021-01-19 Avoid potential segfault because of accessing raw pointer of deleted data (#272)
    * [core] Use std::weak_ptr instead of raw pointer to avoid segfault if object gets destroyed in the meantime.
    * [core] Make sure controller's robot and system's robot are consistent when add system to engine.
    * [core] Refactor constraints to improve efficiency and make it more intuitive to define and use.
    * [core] Fix joint acceleration not properly updated after calling 'computeAcceleration' method of Engine.
    * [core/python] Enable to define custom constraints directly in Python.
    * [core/python] Rename 'AbstractControllerWrapper' in 'BaseController' to clarify it is not abstract but the base controller cl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
    [AbstractConstraint.cc, FixedFrameConstraint.cc, WheelConstraint.cc, controller.py, double_pendulum.cc]
2021-01-31 Various minor improvements (#274)
    * [misc] Update gitignore to ignore log folders.
    * [misc] Increase stepper tolerance in unit test to be consistent with check accuracy.
    * [misc] Fix new Cmake policy CMP0111.
    * [misc] Fix type checking to support latest mypy/pylint releases.
    * [misc] Assume pip 21.0 for Cmake and install it on Windows CI. Minor improvements of Cmake files.
    * [misc] Remove useless boost submodules dependencies.
    * [misc] Do NOT support Numpy >= 1.20 explicitly, since not compatible with Python3.6.
    * [core] Fix segfault when initializing sensor using unvalid robot.
    * [core] Disable stepper 'iterMax' by default.
    * [core] Abort simulation if 'nan' detected in 'q', 'v', '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
    [Engine.h, ExplicitEulerStepper.cc, PinocchioOverloadAlgorithms.h, controller.py, env_generic.py]
2021-01-31 [core] Speedup simulation by avoiding memory allocations in stepper. (#276)
    * [gym] Use float32 action space instead of float64 because it is the usual dtype for neural networks.
    * [core] Avoid memory allocation during Lie algebra computations without relying on compiler optimizations.
    * [misc] Update Cmake to support RelWithDebInfo. Enable more Cmake warnings.
    [ExplicitEulerStepper.cc, double_pendulum.cc, env_generic.py]
2021-02-01 [core] Avoid algebraic loop in internal stepper steps by postponing accel/force update until success. (#277)
    * [core] Avoid algebraic loop in internal stepper steps by postponing accel/force updates after successful outer step.
    * [core] Move centroidal kinematics computations in stepper outer loop for efficiency.
    * [core] Assume slow variation of subtree inertia during one integration step for efficiency.
    * [core] Avoid memory allocation by 'computeAcceleration' using return by reference.
    * [core] Avoid memory allocation when calling 'updateTelemetry' and 'computeAllEffort'.
    * [misc] Fix double_pendulum c++ example using Eigen::Ref for controller handles instead of vectorN_t.
    Co-auth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
    [double_pendulum.cc]
2021-02-02 [misc] Check no memory allocated by Eigen during simulation. (#278)
    * [misc] Check no memory allocation by Eigen during simulation.
    * [misc] Update Eigen to latest release (3.3.9) on CI.
    * [core] Fix joints accel/force restored right after computations instead of before sensor update.
2021-02-04 [core] Various bug fixes. (#281)
    * [core] Fix visco-elastic directional coupling force and add non-directional one.
    * [core] Fix forces not taking into account the external forces.
    * [core] Fix telemetry logging failed internal stepper steps.
    * [core] Fix adaptive RK dopri stepper MAX_FACTOR wrongly scaled by SAFETY factor.
    * [core] Fix wrong computation of multi-systems coupling forces.
    * [python/viewer] Fix replay using rigid instead of flexible model.
    * [python/viewer] Fix mesh path on windows.
    * [gym/common] Rename 'size' argument of 'sample' method in 'shape' for consistency with standard API.
    * [gym/common/envs] Do not log internal steps in debug mode to keep log consistent wit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
    [Engine.h, env_generic.py, env_locomotion.py, robot.py]
2021-02-18 [misc] Minor API rework for consistency with Mujoco API. (#283)
    * [misc] Move to C++17 for dependencies.
    * [core] Compute subtree coms by default.
    * [core] Improve vector 'clamp' utility to avoid memory allocation.
    * [core] Fix edge case in controller breakpoints management.
    * [core] Rename 'rotorInertia' in 'armature' to be consistent with mujoco and clearer that it is joint side.
    * [core] Rename 'EffortLimit' in 'ControlLimit' to avoid redundancy with pinocchio::Data and explicit it is motor-side.
    * [core] Adapt code base for new 'armuture' and 'controlLimit' definitions.
    * [core] Do not compute 'oMf' for 'JOINT' and 'BODY' frames but rather copy data from 'oMi' and 'oMf'.
    * [core]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
    [acrobot.urdf, box_collision_mesh.urdf, point_mass.urdf, sphere_primitive.urdf]
2021-03-03 [core] Change contacts/bounds spring-damper model to clamp the whole force rather than only velocity-related component.
2021-03-03 [core] Rename explicit euler in euler explicit for consistency with runge kutta steppers.
2021-03-03 [core] Compute FixedFrameConstraint jacobian and drift LOCAL_WORLD_ALIGNED. Add Baumgarte stabilization.
    [FixedFrameConstraint.cc]
2021-03-03 [core] Remove striction from spring-damper model.
2021-03-03 [gym/common/envs] Enforce deepcopy of observation and information before returning it to avoid any issue with replay buffer.
    [env_generic.py]
2021-03-05 [misc] Add OpenAI Gym Ant learning environment. (#286)
    * [core] Fix 'interpolate' utility.
    * [jiminy/simulator] Allow chaining rendering methods.
    * [gym/common/envs] Fix 'render' method not call by env before replaying.
    * [jiminy/viewer] Fix traveling.
    * [gym/common/utils] Add full support of 'gym.spaces.Tuple'.
    * [gym/common/envs] Clip returned observation systematically to avoid out-of-bounds errors.
    * [gym/common/envs] Enable traveling by default if robot has freeflyer.
    * [gym/envs] Add mujoco-like Ant learning environment.
    * [gym/toolbox] Rework folder achiecture.
    * [gym/example] Refactor examples folder architecture to be easier to extend.
    * [gym/example] More generic tools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
    [ant.urdf, cartpole.urdf]
2021-03-07 [python/viewer] Support Panda3d backend on more hardware and platform. (#288)
    * [core] Fix wrong internal stepper timestep if fixed.
    * [core] Increase maximum simulation timestep for RL requirement.
    * [jiminy/viewer] Do not open graphical window if possible by default when video recording is requested.
    * [jiminy/viewer] Make sure only one graphical window can be opened locally.
    * [jiminy/viewer] Fix meshcat waiting not working.
    * [jiminy/viewer] Add fallback for panda3d backend if no nvidia-gpu is available.
    * [jiminy/viewer] Fix support of Windows 10 for Panda3d backend.
    * [jiminy/viewer] Convert Python location meshcat recorder import warning into exception only raised at instantiat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
    [env_generic.py, generic_bases.py]
2021-03-10 [jiminy/viewer] Panda3d has default viewer backend. (#290)
    * [core] Minor improvement of robot weak_ptr management for sensors/motors.
    * [core] Various minor improvements.
    * [jiminy/simulator] Fix viewer not opening graphical window after closing it once.
    * [jiminy/simulator] Rename 'disable_flexiblity_data' or 'enable_flexiblity_data' for clarity.
    * [jiminy/viewer] Fix widgets positioning and scaling on Panda3d.
    * [jiminy/viewer] Do not shrink legend automatically and slightly increase size on Panda3d.
    * [jiminy/viewer] Fallback to software rendering with panda3d if necessary.
    * [jiminy/viewer] Fix panda3d mesh loader backend 'assimp' requiring specific path formatting on Windows.
    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
    [GRIPPER_OPEN_chull.obj, atlas_v4.urdf, atlas_v5.urdf, head.obj, head_camera.obj, head_camera_chull.obj, head_chull.obj, l_foot.obj]
2021-03-16 [gym/envs] Add Cassie robot learning environment. (#297)
    * [misc] Fix wheel generation process corrupting png files.
    * [misc] Increase Pagefile on Windows CI to avoid unit test failure when loading Panda3d.
    * [misc] Make sure *.png files are processed by binary files by git.
    * [core] Make sure application time of impulse forces are positive (not strictly).
    * [jiminy/dynamics] Add some RPY converters.
    * [python/dynamics] Add options to use theoretical model when computing freeflyer.
    * [jiminy/simulator] Add 'command' tab to 'plot' method.
    * [jiminy/viewer] Properly close viewer backend process when closing.
    * [python/viewer|gym/common/envs] Make sure viewer is properly closed after si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
    [abduction.stl, abduction_mirror.stl, achilles-rod.stl, cassie.urdf, hip.stl, hip_mirror.stl, knee-output.stl, knee-output_mirror.stl]
2021-03-20 [python/plot] More versatile plotting tools. (#302)
    * [core|python] Add support of non-contiguous temporary to 'register_variables'.
    * [core/python] Allow registering 2D numpy arrays for bindings.
    * [python/processing] Add N-order integrator assuming zero-order-hold for highest derivative.
    * [python|gym] Add TabbedFigure class and use it in simulator.
    * [python|gym] Move '_log_data' from gym env to simulator. Log generic action automatically.
    * [misc] Remove force install 'numba==0.53.0rc3' on CI since 0.53 is now available.
    * [misc] Consistent use of 'resource_filename' to access models data.
    * [misc] Add Atlas in Readme instead of Anymal.
    * [misc] Fix ipython tutorial.
    * [python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
    [block_bases.py, dynamics.py]
2021-03-26 [core] Add random process generators. (#304)
    * [core] Split utilities in multiple files. Use unique_ptr to reduce header dependencies and speed-up compilation. Add random process utilities.
    * [core|core/python] Fine tuning random process parameters and debugging. Initialize random number generator when load python bindings. Expose global random generator reset method.
    * [core/python] Fix 'self' argument name for constructors.
    * [core/python] Improve docstring signature type inference.
    * [core|core/python] Add getter for impulse, profile, and coupling forces. Change naming convention for consistency, aka 'registerForce[TYPE]'.
    * [core|core/python] Full-featured std::vector wrapping.
    * [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
    [DistanceConstraint.cc, Engine.h, FixedFrameConstraint.cc, LCPSolvers.cc, SphereConstraint.cc, WheelConstraint.cc, double_pendulum.cc, env_generic.py]
2021-04-01 [misc] Bug fixes and API consistency improvements. (#308)
    * [core] Add Engine methods to remove registered impulse and profile forces, and all forces (including coupling) at onces.
    * [core] Use default C++ derived class method hiding to deter usage of specialized EngineMultirobot methods in Engine, and throw error if addSystem/removeSystem is called.
    * [core] Get read-only access to global random seed. Make sure random number genetators are initialized at Engine level. Reset random number genetors if desired seed has changed when calling 'setOptions'.
    * [core/python] Fix dangling collision_data dangling reference in python because Model was deleting it by mistake.
    * [core/python] Rename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
    [Engine.h, block_bases.py, controller.py, env_generic.py, generic_bases.py]
2021-04-08 [python/viewer] Initial support of 'panda3d-qt' rendering backend. (#313)
    * [python/viewer] Improve video recording efficiency using panda3d backend. (#309)
    * [misc] Avoid copying irrelevant files when build wheels.
    * [misc] To need to install wheels twice anymore thanks to new pip dependency resolver.
    * [python/dynamics] Add XYZQuat to XYZRPY position and velocity converters.
    * [python/viewer] Use 'av' package instead of 'cv2' to export video. It is faster and support web-compatible 'h264' codec.
    * [python/viewer] Improve video recording speed even further by disabling panda3d framerate limit during recording.
    * [python/viewer] Restore default window size.
    * [python/viewer] Update co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
    [LCPSolvers.cc, dynamics.py, env_generic.py, simulator.py, utilities.py]
2021-04-13 [core] Enable to specify update period of registered force profiles. (#319)
    * [python/viewer] Greatly improve mesh loading speed. 'set_color' now set colors of both visual and collision meshes.
    * [python/viewer] Enable to zoom very close in 'panda3d' without seeing through the model.
    * [misc] Fix inter-operability with custom eigenpy/hppfcl/pinocchio install.
    * [misc] Add typing to 'panda3d_visualizer' module.
    * [core] Increase constants + variable names memory size. Clearer error message in case of overflow.
    * [core/python] Automatically reset to Zero the return variable of functors returning by value in C++.
    * [python/viewer] Add 'cone' and 'arrow' primitives to 'panda3d' rendering b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
    [Engine.h, env_generic.py, simulator.py]
2021-04-16 [misc] Improve interoperability of Boost.Python bindings. (#322)
    * [core] Fixes segfault when calling some methods on uninitialized objects.
    * [core] Fix HDF5 export of empty string constants.
    * [misc] Fix telemetry variables memory overflow (again).
    * [misc] Fix Boost python error handling at import.
    * [misc] Improve module interoperatibility by supporting dual C++ ABI.
    * [misc] Bundle Jiminy headers and core shared library in Python wheels.
    * [misc] Refactor binary distribution to mimic numpy.
    * [misc] More reliable core submodule import using '*' and '__all__'.
    * [misc] Build wheel for manylinux2010 and manylinux_2_24 to support old and new ABI.
    * [misc] Remove C++17 features bre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
    [Engine.h, PinocchioOverloadAlgorithms.h]
2021-04-19 [misc] Provide CMmake configuration file in wheels. (#324)
    * [misc] Fix wheel deploy. Add project URLs to pypi project page.
    * [misc] Refactor legacy CMake Python finding to be consistent with CMake>=3.12.
    * [misc] Bundle cmake configuration file in wheel.
    * [misc] Cleanup pinocchio include and move them in cpp if possible.
    * [misc] Provide pip-install-based build of C++ executable.
    * [misc] Remove legacy compilation mode since no longer necessary.
    [double_pendulum.urdf]
2021-04-24 [core] Improve code quality.
    * [core] Allow arbitrary larger controller update period.
    * [core] Fix deprecation and unused variable warnings.
    * [core] Improve error reporting by printing fully qualified function name without arguments.
    * [core] Remove irrelevant virtual keywords.
    * [core] Use randomPermutationPeriod=0 to disable random permutation of 'PGSSolver' iterative solver, instead of 'isfinite', which is ill-defined for integers.
    * [core] Do NOT shuffle first iteration cycle of 'PGSolver', and initialize indices in reverse order to make convergence (hopefully) faster.
    * [core] Enable implicit conversion warnings.
    * [core] More consistent coding style.
    * [core] Avoid static_cas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
    [AbstractConstraint.cc, DistanceConstraint.cc, FixedFrameConstraint.cc, JointConstraint.cc]
2021-04-26 [core/python] Custom return policy to avoid conflits with external modules. (#332)
    * [core] Fix bug at Robot initialization when defining default flexible joints in the model.
    * [core/python] Fix wrong keyword arguments for 'EngineMultiRobot.reset' method.
    * [core/python] Add new Boost.Python return policy that can be used to by-pass converter registry if 'convertToPython' has been specified.
    * [python] Add some missing typing return types.
    [robot.py]
2021-04-28 [python] Add CLI to replay log files. (#334)
    * [core/python] Fix 'buildGeomFromUrdf' module interoperability.
    * [python/simulator] 'simulate' now supports writing log in any available format.
    * [python/log] Add generic utility to reconstruct robot from log.
    * [python/viewer] Fix default legend when replaying multiple trajectories at once.
    * [python/viewer] Add method to replay log file, only requiring the original meshes to be available.
    * [python/viewer] Add 'jiminy_replay' CLI entrypoint to replay Jiminy log files.
    * [python/viewer] Add option to not remove widgets after replaying trajectories.
    * [python/viewer] Reorder default colors cycle.
    * [python/viewer] Switch device notific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
    [dynamics.py, log.py, simulator.py, utilities.py, viewer.py]
2021-05-03 [python/viewer] Add support of CoM and contact forces display. (#340)
    * [core] Add public setter 'AbstractSensorBase.set' for sensor data.
    * [core] Make sensor setter 'AbstractSensorBase.setAll' private.
    * [core/python] 'result_converter' now supports Eigen::Ref.
    * [core/python] Expose setter of 'AbstractSensorBase.data'.
    * [python/viewer] Fix error when using exotic matplotlib backends.
    * [python/viewer] Fix 'Viewer.add_marker' and 'Panda3dApp.move_node' node placement.
    * [python/viewer] Fix 'append_group' when 'remove_if_exits=False'.
    * [python/viewer] Do not add legend if replay of the single log.
    * [python/viewer] Hide node if scale is too small.
    * [python/viewer] Add option to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
    [env_generic.py, log.py, simulator.py, test_pipeline_control.py, viewer.py]
2021-05-17 [python/viewer] Add options to display Capture Point and external forces. (#341)
    * [core] Compute velocity of the center of mass of each subtree systematically.
    * [core] Fix internal update period computation when defined control and sensor update period of the engine without robot.
    * [core] Add option to register external forces to the telemetry.
    * [python/robot] Add fallback if 'dynamics' fields 'damping'/'friction' are partially defined in URDF file.
    * [python/processing] Add efficient convex hull tools. Improve efficiency and versatility of 'interpolate_zoh'.
    * [python/log] Extract external forces from log if recorded.
    * [python/viewer] Add option to display DCM in viewer.
    * [pyth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
    [double_pendulum.cc, env_generic.py, env_locomotion.py, log.py]
2021-05-18 [core] 'EngineMultiRobot.Start' no longer reset the engine automatically. (#342)
    * [core] 'EngineMultiRobot.Start' no longer reset the engine automatically.
    * [core] Biases for random model generation are now relative instead of absolute.
    * [core] Fix computation of center of mass positions and velocities.
    * [python/viewer] Fix log replay without velocity and external forces data available.
    * [python/viewer] Log replay now support overwriting mesh package dir.
    * [gym/example] Add option to specify log subdirectory name interactively.
    * [misc] Fix CI numpy version issues.
    [Engine.h, log.py, utilities.py, viewer.py]
2021-06-03 [misc] Jiminy release 1.6.18 (#345)
    * [core] Provide robust initial guess to 'impulse' contact solver.
    * [python] Various minor improvements.
    * [python/viewer] Fix clicking on node for panda3d Qt widget.
    * [python/viewer] Fix seldom lock issues when displaying many robots simultaneously.
    * [gym/common] 'sample' now supports providing both 'shape' and vector 'low'/'high'/'mean'/'scale' if broadcastable.
    * [gym/examples/rllib] More robust obs flattening.
    * [gym/examples/rllib] Do not replay if recording is disable during training.
    * [gym/examples/rllib] Add option to use custom logger. Interrupt learning gracefully in case of ray task exception.
    * [gym/examples/rllib] Add option to sav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
    [AbstractConstraint.cc, DistanceConstraint.cc, FixedFrameConstraint.cc, JointConstraint.cc]
2021-06-07 [gym/common/envs] Enhanced interactive mode. (#348)
    * [python/robot] Fix external forces not properly shared with viewer.
    * [python/viewer] Display freeflyer external forces by default.
    * [python/viewer] Add getter for camera pose.
    * [python/viewer] Mix busy loop and timer sleep in precise sleep to release the GIL.
    * [python/viewer] Add option to not lock camera pose when travelling is enabled using Panda3d.
    * [python/viewer] Fix interactive loop CPU throttle by adding short sleep in deamon reading stdin.
    * [python/viewer] Improve viewer refresh efficientcy by only forcing display update whenever necessary.
    * [python/viewer] Add support of frame index to define relative lookup and ca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
    [dynamics.py, env_generic.py]
2021-06-08 [python/viewer] Hot fix viewer issues. (#349)
    [simulator.py, viewer.py]
2021-06-12 [gym/toolbox] Add dedicated gym toolbox for rllib (#350)
    * [python/viewer] Refactor panda3d backend screen refresh to avoid edge cases. Refactor Qt widget to factorize code.
    * [python/simulator] Replay extra logs/trajectories with current simulation.
    * [gym/toolbox/rllib] Add dedicated rllib toolbox. Add PPO CAPS implementation.
    * [gym/toolbox/rllib] Do not provide default log dir since it is error prone
    [log.py, plot.py]
2021-06-19 [gym/toolbox/rllib] Add discrete task space curriculum learning. (#357)
    * [core] Fix memory leaks in Eigen->Numpy Python bindings.
    * [core] Rename 'Model.hasConstraint' in 'Model.hasContraints' for consistency.
    * [core] Expose 'Model.computeConstraint'.
    * [core] Fix motor armatures not properly propagated after setting motor options.
    * [core] Do not update forward kinematics (position) in 'Robot.computeConstraints'.
    * [python] Add some missing documentations.
    * [python/dynamics] Simplify helpers to take advantage of new pinocchio features.
    * [python/dynamics] Replace pinocchio methods by jiminy core overloads when appropriate.
    * [python/dynamics] Add inverse dynamics helper.
    * [g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
    [dynamics.py, env_generic.py, env_locomotion.py, generic_bases.py, pipeline.py]
2021-06-30 [python] Hot fix (#358)
    * [core] Fix segfault and compilation bug on Windows.
    * [python/dynamics] Fix wrong application point for spatial velocity and acceleration frames.
    * [python/viewer] Fix viewer edge cases when displaying several robots at once.
    * [python/viewer] Fix legend aspect ratio in Panda3d, and display it in line at bottom.
    * [python/viewer] Fix clock widget for Panda3d.
    * [gym/toolbox] Fix edge case in curriculum task scheduler.
    [FixedFrameConstraint.cc, block_bases.py, dynamics.py, env_generic.py, log.py]
2021-07-01 [core|python/dynamics] Increase efficiency of inverse dynamics. (#361)
    * [core] Increase efficiency of inverse dynamics in Python.
    * [python/viewer] Fix edge case when default-initializing viewer for theoretical model.
    [LCPSolvers.cc, PinocchioOverloadAlgorithms.h, dynamics.py, viewer.py]
2021-07-06 [core] Various minor improvements and bug fixes. (#367)
    * [core] Fix computation of external forces. Compute centrodial dynamics derivative systematically. (#365)
    * [core] Fix eigen stack memory alignment for support of AVX2 instructions.
    * [core/python] Fix wrong output array shape for single row or single element eigen matrix.
    * [gym/toolbox] Refactor Rllib PPO to always perform a single forward pass. (#366)
    * [misc] Add legacy build of jiminy wheel for python 3.8 (numpy<1.20).
    * [misc] Update dependencies (eigenpy==2.6.4, hppfcl==1.7.4).
    * [misc] Fix wheel manylinux seperated artefacts generation. (#364)
    [PinocchioOverloadAlgorithms.h]
2021-07-09 [python] Various minor bug fixes. (#372)
    * [misc] Do not try pushing legacy wheels on pypi. (#368)
    * [python/viewer] Fix calls to super in Panda3dQWidget (#370)
    * [core/python] Fix bindings of pinocchio overloads.
    * [python/dynamics] Remove useless joint jacobians computation.
    [PinocchioOverloadAlgorithms.h, dynamics.py]
2021-07-12 [misc] Clean up python architecture. (#377)
    * [python] Remove unused/unmaintained 'smoothing_filter' processing helper.
    * [gym/common] Improve performance by avoiding deepcopy of action in 'compute_command' methods.
    * [gym/common] Allow to specify custom observer update period for base env to avoid refresh observation during internal steps.
    * [gym/common] Add optional '_refresh_internal' method to share computation between 'is_done' and 'compute_reward'.
    * [gym/toolbox] More versatile compute action helper for rllib. (#373)
    * [misc] More generic github action wheel generation script. (#375)
    * [misc] Move 'processing' module from 'jiminy_py' to 'gym_jiminy.toolbox' to remove numba deps.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
    [env_generic.py, generic.py, generic_bases.py, pipeline_bases.py]
2021-08-04 [gym] Maintenance update. (#390)
    * [core] Fix random physics sampling.
    * [core] Make sure random physics parameters are valid
    * [python/simulator] Fix default external force display during replay.
    * [python/viewer] Check that 'time_interval' is valid. Fix out-of-range edge case.
    * [python/viewer] Fix support of robot without sensors nor freeflyer.
    * [gym/common] More efficient random number generator.
    * [gym/common] Fast space 'clip' utility.
    * [gym/common] Reset internal '_info' buffer before calling 'is_done' to enable storing extra info. (#386)
    * [gym/common] Do not automatically disable telemetry anymore.
    * [gym/common] Enable 'refresh_observation' to access up-to-date shared in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
    [cartpole.urdf]
2021-08-18 [all] Fix reproducibility and performance comparation issues. (#399)
    * [core] Fix log buffer not refreshed after calling 'stop', making last datapoint not accessible. (#396)
    * [python/robot] Fix non-reproducible simulation results.
    * [jiminy_py/simulator] Fix running simulation not stopped before updating seed.
    * [python/simulator] Fix unexpected error if 'replay' is called without data.
    * [gym/common] Do not set the seed by default in '_setup' method.
    * [gym/common] Add train and eval modes to allow specific evaluation behaviors.
    * [gym/common] Rename '_is_training' in 'is_training'. Fix 'is_training' False by default. (#397)
    * [gym/common] 'seed' method now return the actual sequenc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
    [env_generic.py, generic.py, robot.py, simulator.py]
2021-09-05 [python/viewer] Fix meshcat backend. (#408)
    * [core] Shuffle constraint solver iterations iif necessary, no matter if constraint set changes.
    * [core] Move contact point at the interface with the ground for impulse model. (#404)
    * [core/python] Fix bindings signature of some controller's method.
    * [python/plot] Fix missing grid for single plot tabs.
    * [python/viewer] Fix viewer compatibility with meshcat>=0.3.1.
    * [python/viewer] Increase meshcat recorder timeout.
    * [python/viewer] Fix meshcat viewer 'has_gui' method.
    * [python/viewer] Fix meshcat notebook viewer.
    * [python/viewer] Properly close opening viewer if raises exception at init.
    * [python/viewer] Add height map renderin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
    [LCPSolvers.cc, dynamics.py, env_generic.py, env_locomotion.py, plot.py]
2021-10-10 Jiminy 1.7.0 (#411)
    * [core] Move init of contact solver in reset instead of setOptions.
    * [core] Add support of torsional friction and contact normal to impulse contact model.
    * [core] Better default 'stabilizationFreq' for impulse contact model.
    * [core] 'engine_options.contacts.stabilizationFreq' only applies to contact constraints.
    * [core] Refactor 'JointConstraint' to be consistent with 'FixedFrameConstraint'.
    * [python/robot] Fix support of URDF model with a single link for automatic hardware config generation.
    * [python/viewer] 'update_floor' method in panda3d now expects numpy array instead of callable to fix serialization issues.
    * [python/viewer] Add support of contact fram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
    [box_collision_mesh.urdf, sphere_primitive.urdf]
2021-10-16 Jiminy 1.7.1 (#415)
    * [core] Rename 'HeatMap' in 'HeightMap'.
    * [core] Write terrain generation tools in C++ for efficiency.
    * [core] Add tools to merge and sum heightmaps.
    * [core] Enable to re-initialize controllers.
    * [core/python] It is now possible to extract raw python function from 'HeightMapFunctor'.
    * [python/viewer] Faster ground profile rendering.
    * [python/viewer] Do not render ground profile if original flat ground.
    * [gym/common] Add 'BaseJiminyEnv.register_variable' method easily log variables.
    * [gym/common] Generic structured space handling by relying on 'dm-tree' package.
    * [gym/common] Support any observation space in gym pipelines.
    * [gym/rllib] Use adversarial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
    [double_pendulum.urdf]
2021-10-19 Jiminy 1.7.2 (#418)
    * [core] Add 'orientation' parameter 'randomTileGround' generator.
    * [core/python] Fix python bindings of 'resetRandomGenerators' method.
    * [core/python] Fix assert in debug.
    * [python/simulation] Fix 'seed' method not resetting the generator if the seed does not change.
    * [python/viewer] Close panda3d viewer cleanly.
    * [gym/common] Render ground profile automatically during 'play_interactive'.
    * [gym/rllib] Fix PPO for 'enable_adversarial_noise' = False and 'caps_global_reg' == 0.0.
    * [misc] Build wheels for manylinux2014 instead of manylinux2010 because of 'dm-tree'.
    * [misc] Build in Release and Debug on Ubuntu CI.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
    [env_generic.py, simulator.py, viewer.py]
2021-10-27 [core] Enable simulation of procedurally generated robots. (#427)
    * [core] Improve efficiency of PGS solver. (#423)
    * [core] Add contact solver 'tolAbs', 'tolRel' options. (#424)
    * [core] Enable to initialize 'jiminy::Robot' using dynamics and collision pinocchio model.
    * [core] Add visual model to 'jiminy::Model'.
    * [core] Add name getter to 'jiminy::Model'.
    * [core] Fix wrong computation of external forces.
    * [core/python] Add method to build reduced model.
    * [python] Do not rely on 'Robot.urdf_path' anymore. Enable to load hardware config on existing robot.
    * [python/robot] Check if motors and sensors defined in hardware file can be added successfully.
    * [python/dynamics] Fix 'co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
    [LCPSolvers.cc, PinocchioOverloadAlgorithms.h, dynamics.py, env_generic.py, plot.py]
2021-11-12 Jiminy 1.7.4 (#444)
    * [core] Implement friction cone for impulse model. (#440)
    * [core] Fix numerical instability of flexibility model by adding armature-like inertia parameter. (#433)
    * [core] Full support of armature for all joints but mimic.
    * [core] Rename 'pncCollisionData' in 'collisionData' and 'pncModelRigidOrig_' in 'pncModelOrig_' since already clear.
    * [core] Fix some implicit type conversions.
    * [python/robot] Fix default hardware config file generator is both collision and visual meshes are defined.
    * [python/viewer] Add physic based rendering of materials to panda3d.
    * [python/viewer] Fix shadow casting area smaller than floor in panda3d.
    * [python/viewer] Fix window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
    [AbstractConstraint.cc, DistanceConstraint.cc, FixedFrameConstraint.cc, LCPSolvers.cc, PinocchioOverloadAlgorithms.h, generic.py]
2021-11-21 [misc] Stable support of Mac OS X. (#451)
    * [core] Fix sphere constraint.
    * [simulator] Fix wrong 'viewer.f_external' forces if render without simulation running.
    * [viewer] 'add_markers' now forward positional arguments.
    * [viewer] Fix meshcat port detection on OS X.
    * [viewer] Disable physics-based shader is no discrete NVIDIA GPU. (#448)
    * [viewer] Improve lighting if no discrete NVIDIA GPU is available.
    * [viewer] Force using 'spawn' multiprocessing context for meshcat to avoid crashes on OS X.
    * [viewer] It is now possible to interrupt replay without closing viewer.
    * [viewer] Fix 'ipykernel' version detection on some setups.
    * [misc] Fix import of jiminy if boost is installed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
    [SphereConstraint.cc, simulator.py, viewer.py]
2021-12-10 [core] Contact handling improvements. (#470)
    * [core] Enforce isotropic solution for PGS. (#467)
    * [core] Compensate PGS bias to ensure maximum energy dissipation for tangential friction. (#468)
    * [core] Compute PGS error in residual space. (#462)
    * [core] PGS skip parameter update if irrelevant. (#464)
    * [core] Force sensors now measure total external force applied on a body.
    * [core] Split constraint and contact options. (#462)
    * [core] Move to next breakpoint if possible to avoid very small timesteps during integration. (#464)
    * [core] Fix non-linear PGS solving of friction cone. (#461)
    * [core] Fix 'removeContactPoints' if input vector is empty.
    * [core] Fix timestep adjustment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
    [AbstractConstraint.cc, FixedFrameConstraint.cc, JointConstraint.cc, LCPSolvers.cc, PinocchioOverloadAlgorithms.h]
2022-03-02 Jiminy 1.7.7 (#486)
    * [core] Always regenerate original flexible model at reset to allow manual overwrite of rigid original model. (#475)
    * [core] Fix segfault when adding unspecified constraint. (#476)
    * [core] Fix 'buildReducedModel' for pinocchio < 2.6.0. (#477)
    * [core] Fix segfault when initializing engine with null robot. (#477)
    * [python/viewer] Fallback to generic direct connection through ipykernel for Meshcat (VSCode, Jupyterlab). (#479)
    * [python/viewer] More robust comm filtering for executing meshcat related requests out of order. (#479)
    * [python/viewer] Fix connection to existing meshcat process. (#479)
    * [python/viewer] Speed up frame capture and reduce CPU load in off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
    [AbstractConstraint.cc, DistanceConstraint.cc, FixedFrameConstraint.cc, JointConstraint.cc, LCPSolvers.cc, PinocchioOverloadAlgorithms.h]
2022-04-06 Jiminy 1.7.8 (#500)
    * [core] Add random sensor jitter.
    * [core] Fix potential mismatch between collision pairs and constraints.
    * [core] Improve contact constraint solver.
    * [core] Remove dedicated tolerance for PGS solver.
    * [core] Initialize stepper with smallest timestep.
    * [core] Enable config baumgarte freq for user-specified constraints.
    * [core] Simplify compute extra terms.
    * [core] Fix engine not reset at start if not done before.
    * [core] Avoid discontinuities at init by starting with contact enabled and adding transitionEps for joint bounds.
    * [python/viewer] Enable dynamic update of available/default backend.
    * [python/viewer] Add synchronous panda3d backend for offscr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
    [anymal.urdf]
2022-04-06 Jiminy 1.7.9 (#502)
    * [core] Fix joint constraint reverse flag.
    * [core] Fix computation of ref contact position.
    * [core] Better handling of integration failure.
    * [core/python] Fix bindings class names and missing attributes.
    * [misc] Fix documentation generation.
    [JointConstraint.cc, env_generic.py, test_double_spring_mass.py, test_multi_robot.py, utilities.py]
2022-05-10 Jiminy 1.7.10 (#516)
    * [core] Minor speedup constraint solver.
    * [core] Speedup computation of 'JMinvJt'.
    * [core] Use same formula to compute tolerance for stepper and contact solver.
    * [core] Update gravity attribute of theoretical model to match options.
    * [core/python] HeightMapFunctor raises an exception if an output is unset.
    * [python/viewer] Do not enforce 'spawn' for meshcat.
    * [python/viewer] Fix replay of multiple trajectories.
    * [python] Class attributes that must be set at init are no longer considered Optional.
    * [misc] Meshcat and Matplotlib are now an optional requirements (meshcat,plot).
    * [misc] Fix support of avx2 instructions.
    * [misc] Fix jiminy cmake library p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
    [PinocchioOverloadAlgorithms.h, block_bases.py, dynamics.py, env_generic.py, env_locomotion.py, generic_bases.py]
2022-05-27 [core] Portable log files. (#522)
    * [core] Fix definition of time unit in log files. (#521)
    * [core] Fix reading of binary log files. (#521)
    * [core] Simulation time unit is now fixed to 1e-10. (#521)
    * [core] Enable serialization of geometry models. (#521)
    * [core] Refactor telemetry to support binary object dump as constant. (#521)
    * [core] Use dynamic and non-contiguous memory for telemetry. (#521)
    * [core] Make logging geometries optional. (#521)
    * [core] Add option to force loading visual meshes. (#521)
    * [core] Fix writing log with no data available. (#521)
    * [python/simulator] 'plot' is blocking by default if not interactive. (#520)
    * [python/log] Build robot from logged mod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
    [block_bases.py, double_pendulum.cc, env_generic.py, generic_bases.py, log.py]
2022-05-30 Hot fixes (#527)
    * [core] Add serialization of convex geometries.
    * [core|python] Fix writing and parsing for log files for hdf5 and csv formats.
    * [python/log] Fix loading of logged pinocchio model.
    * [python/viewer] Fix shadows on floor if available with EGL driver for panda3d.
    * [python/viewer] Fix flipped viewer overlay for panda3d.
    * [python/viewer] Fix update color and improve except handling for legend.
    * [python/viewer] Fix default color handling for panda3d.
    * [python/viewer] Fix loading of Convex geometries.
    * [python/viewer] Fix PBR shader on EGL.
    * [python/viewer] Adjust lighting for panda3d.
    * [misc] Fix wheel deploy for gym jiminy.
    * [misc] Fix gym_jiminy_zoo deps.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
    [log.py, viewer.py]
2022-06-17 [python] Improve notebook support. (#542)
    * [core] Add rest length to directional coupling force.
    * [core] Resolve polymorphism manually while serializing geometry to avoid conflicts with pinocchio.
    * [core] Force persistent log mode if no urdf associated with robot.
    * [core] Backup URDF as string right when initializing the robot for persistence.
    * [core] Adding deformation point at frame no longer requires a valid URDF file.
    * [core] Adding coupling forces requires different frames.
    * [core] Check that child body mass is strictly positive when adding frame flexibility.
    * [core] Check if flexible joints are unique.
    * [core] Check if acceleration is valid at init.
    * [core] Check fle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
    [Engine.h, env_generic.py, log.py, plot.py]
2022-10-29 Jiminy 1.7.14 (#562)
    * [core] Improve memory management of sensors. (#551)
    * [core] Move Baumgarte Stabilization freq from constraint to contact to avoid affecting user-specified constraints.
    * [core] Distance constraint reference now reset to current but can be updated.
    * [core] Fix sensor not properly initialized before calling reset at least once. (#550)
    * [core] Fix segfault at start for multi-robot simulation.
    * [core] Fix sensor not properly initialized before calling reset at least once.
    * [core] Fix Viscoelastic coupling force computation. (#553)
    * [core] Fix expose registered force profiles and impulses. (#557)
    * [core] Fix bugs in creation of flexible model.
    * [core] Fix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
    [box.STL, box_collision_mesh.urdf, branching_pendulum.urdf, double_pendulum.urdf, double_pendulum_rigid.urdf, linear_single_mass.urdf, linear_two_masses.urdf, point_mass.urdf]
2023-01-28 [core] Fix deformation and viscoelastic coupling forces (#586)
    * [core] Fix viscoelastic force coupling.
    * [core] Fix flexibility model internal force.
    * [core/python] Methods to set options now returns hresult as expected.
    * [misc] Cleanup CI scripts and install doc.
    * [misc] Fix broken pip devel mode install with easy intall script.
    * [misc] Stop running CI on Ubuntu 18.04 for easy install as it reaches EOL.
    * [misc] Pin Panda3D version on macos because it crashes.
    * [misc] Set upper bound on numpy version to fix numba crash.
    * [misc] Update mypy requirement and fix typing errors.
    * [misc] Fix compilation failure on gcc-12 without breaking Boost.Python interoperability.
    * [misc]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
    [Engine.h, env_locomotion.py]
2023-02-06 [misc] Update all C++ core dependencies to latest version. (#587)
    * [core] 'getFrameIdx' now returns first frame with desired name available.
    * [misc] Update all C++ core dependencies to latest version.
    * [misc] Update python requirements.
    * [misc] Patch Boost Python to support Python 3.11.
    * [misc] Generate stubs for deps.
    * [misc] Update Windows CI to MSVC22.
    * [misc] Improve compilation speed and reduce memory pressure on windows.
2023-02-09 [misc] Do not rely on Ubuntu version for Linux CI test (#588)
    * [misc] Do not rely on Ubuntu version for Linux CI test.
    * [misc] Fix typing of gym_jiminy for mypy==1.0.0.
    [block_bases.py, env_generic.py, env_locomotion.py, pipeline.py, pipeline_bases.py, simulator.py]
2023-03-01 [misc] Migration to Python>=3.8,<3.12. (#589)
    * [core] Remove workaround for buggy integrate SE3 in place now fixed.
    * [core] Require 'gcc>=8.1','macos>=10.15' and remove C++17 limitations.
    * [core] Fix wrong contact forces when continuously updating sensors but not controller.
    * [core] Fix wrong computation of initial forces and accelerations if constraints are active.
    * [core] Fix sign inconsistency between 'ContactSensor' and 'ForceSensor'.
    * [core/python] Generate stubs (Python type hints) for jiminy_py and all deps.
    * [core/python] Fix raise exception when getting invalid sensor data.
    * [python/simulator] Raise exception when importing option file with unknown keys.
    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
    [backpart.stl, foot.stl, foot_pendulum.urdf, frontpart.stl, larm.stl, larm_cover.stl, lfoot.stl, lshoulder.stl]
2023-03-11 [python/viewer] Fix interactive notebook support.
    [utilities.py, viewer.py]
2023-06-27 Jiminy release 1.7.16 (#620)
    * [core] Fix SensorsDataMap without shared memory. (#616)
    * [core] IMU sensors no longer measure quaternion directly. (#618)
    * [core/python] More generic automatic signature deduction helpers. (#616)
    * [core/python] Add fallback conversion from numpy 0D array to any C++ types. (#618)
    * [core/python] Do not support 'np.matrix' anymore. (#618)
    * [core|python] Enable to register int64 to controller telemetry. (#616)
    * [core|python] More robust log loading. (#612)
    * [python] Fix memory leak due to circular reference.
    * [python/log] More consistent custom mesh search path handling. (#613)
    * [python/simulator] Fix handling of extra keyword arguments in 'render' method.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
    [block_bases.py]
2023-09-29 [core] Jiminy release 1.7.17 (#646)
    * [core] Fix propagation of rotor inertia and command limit.
    * [core] Fix Euler updating derivative at beginning instead of end of step.
    * [core] Only update accel-level quantities when dynamics changes before step.
    * [core] Update all geometry placements not only collision pairs.
    * [core] Further speed up of accel computation if state up-to-date.
    * [core] Skip useless forward kinematics when updating telemetry.
    * [core] Refactor telemetry sender to improve efficiency.
    * [core] Monitor number of successive constraint solving failure.
    * [core/python] Add optimized 'array_copyto' helper method.
    * [core/python] Fix 'Robot.constraints' and 'JointConst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
    [PinocchioOverloadAlgorithms.h, block_bases.py]
2024-01-02 [misc] Fix documentation. (#647)
    * [core] More consistent adaptive stepper error computation.
    * [core] Add option to set baumgarte position and velocity gains freely.
    * [core] Fix rare edge-case when setting options causing segfault.
    * [python] Minor plot and viewer fixes.
    * [misc] Add unit tests for flex dynamics and bounds constraint.
    * [misc] Fix documentation.
    ---------
    [dense_pole.urdf]
2024-01-02 [misc] Update notebook tutorial. (#648)
    * [python/viewer] Fix replay viewer exception for 1DoF systems using 'panda3d-sync'.
    * [misc] Update notebook tutorial.
    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
    [plot.py, viewer.py]
2024-01-02 [core] Fix inertia projection formula. (#649)
    [test_dense_pole.py]
2024-01-02 [gym/envs] Add 'digit' bipedal robot. (#430)
    * [core] Fix serialization of geometry objects.
    * [core] Support saving binary log file with empty variables.
    * [python/robot] Improve default hardware file generation.
    * [gym_jiminy/common] PD controller block now support unbounded joints.
    * [gym_jiminy/common] Fix wrong frame name for default relative camera pose.
    * [gym/envs] Add 'digit' bipedal robot.
    * [misc] Stop calling 'setup.py' directly for building wheels.
    [arm-L1.obj, arm-L2.obj, arm-L3.obj, arm-L4.obj, cassie.urdf, digit.urdf, hip-pitch-housing.obj, hip-pitch.obj]
2024-01-02 Various minor improvements. (#651)
    * Add C++ clang format.
    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
    [atlas_v4.urdf]
2024-01-02 [core] Do not enforce not configuration bounds at init for spring-damper contact model. (#654)
2024-01-02 [core] Move sensors and motors in dedicated hardware directory. (#655)
2024-01-02 [misc] Add debug CI jobs for MacOS. Improve debug support for WinOS (#659)
    * [core] Fix flexible from/to rigid config helpers.
    * [misc] Fix Python typing for 'comm>=0.2.0'.
    * [misc] Add debug CI jobs for MacOS. Improve debug support for WinOS.
    [model.cc]
2024-01-02 [core] Fix non-repeatable simulation due to partial hyteresis reset. (#662)
    [test_pipeline_control.py]
2024-01-02 [misc] Migrate HDF5 from 1.14.0 to 1.14.3. (#669)
    * Migrate HDF5 from 1.14.0 to 1.14.3.
    * [misc] Fix viewer for panda3d backend broken by 'simplepbr==0.11.2'.
    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
    [plot.py, simulator.py]
2024-01-02 [python/viewer] Fix viewer exception handling with panda3d. (#672)
    * [core/python] Add partial support of 'pathlib.Path' objects.
    * [python/viewer] Fix viewer closing exception handling with panda3d backend.
    * [python/viewer] Improve documentation of panda3d internals.
    * [python/viewer] Add support of torus and partial cylinder with panda3d.
    * [python/viewer] Fix wrong anchor for cylinders and arrows with panda3d.
    * [misc] Update all C++ dependencies.
    * [misc] Add missing 'patchelf' dependency.
    [utilities.py, viewer.py]
2024-01-02 [python/viewer] Fix some edge-cases with panda3d backend. (#673)
    [utilities.py, viewer.py]
2024-01-02 [core] Replace 'macros.h' and 'types.h' by 'traits.h' and 'fwd.h' headers. (#674)
    [abstract_motor.cc]
2024-01-02 [python/viewer] Fix some edge-cases with panda3d backend. (#675)
    [env_generic.py, utilities.py]
2024-01-02 [core] Various styles changes. (#677)
    * [misc] Update clang formatting for arrays.
    * [core] Rename 'FixedFrameConstraint' in 'FrameConstraint'.
    * [core] Pass and return fundamental types by value instead of const ref.
    [abstract_motor.cc]
2024-01-02 [core] Move member initialization in header when possible. (#683)
    * [core] Move member initialization in header when possible.
    * [core] Use attributes 'explicit', 'noexcept'.
    * [core/python] More robust and generic from/to python converters.
    * [misc] More robust build script on unix systems.
    * [python/viewer] Do not use 'atexit' anymore to fix memory leaks.
    [abstract_motor.cc, abstract_runge_kutta_stepper.cc]
2024-01-02 [core] Fix internal efforts computation. (#684)
    * [core] Fix wrong state and derivative during computation of extra terms.
    * [core] Fix internal effort computation.
    * [python/viewer] Fix exception handling at init.
    * [python/simulator] Fix exception when manually closing viewer.
    * [misc] Update MacOS CI.
    [model.cc, simulator.py, viewer.py]
2024-01-30 Jiminy release 1.7.19 (#700)
    * [core] Refactor random number generator to remove global state.
    * [core] Fix sensor delay.
    * [core] Fix sensor measurement at start.
    * [core] Heightmap discretization now returns a geometry object and support decimation.
    * [core] Fix broken PeriodicFourierProcess.
    * [core] 'ForceSensor' measures only contact forces.
    * [core] Improvement performance of 'swapMatrixRows' utility.
    * [core] Avoid code duplication in 'swapJoints' utility.
    * [core] Passing wrong size to 'isPositionValid' does not trigger exception anymore.
    * [core] Use function pointer type by default for ControllerFunctor.
    * [python/viewer] Detect Apple Silicon GPU to enable high-res shadow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
    [abstract_sensor.cc, basic_sensors.cc]
2024-02-04 Jiminy release 1.7.19.post1 (#704)
    * [core] Fix broken flexible model.
    * [gym/toolbox] Improve numerical stability of 'quat_to_rpy' utility.
    * [misc] Prepare support of Linux ARM64.
    [generic.py, miscellaneous.cc]
2024-02-11 Jiminy release 1.8.0 (#714)
    * [core] More consistent naming conventions. (#705)
    * [core] Revert 'crba' to ensure positive definite inertia matrix. (#709)
    * [core] Remove return codes and throw exceptions instead. (#713)
    * [core/python] Get rid of intrusive global to_python converters.(#708)
    * [core/python] Avoid using raw C typeid. (#711)
    * [python] Get rid of 'dm-tree' dependency. (#706)
    * [python/viewer] Fix video recording on Apple Silicon with meshcat. (#706)
    * [python/viewer] Fix meshcat zmq socket not properly closed.
    * [gym/common] Fix circular reference issue preventing garbage collection.
    * [gym/common] Enable numba caching for 'remove_twist'. (#706)
    * [misc] Cleanup stabl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
    [abstract_motor.cc]
2024-02-13 Jiminy release 1.8.1 (#722)
    * [core] Error and warning reporting more consistent with Python. (#716)
    * [core] Fix exception handling for visco-elastic coupling and internal flex forces. (#716)
    * [core] Fix error estimation too optimistic for adaptive steppers. (#716)
    * [core] Fix partially broken step adjustment optim that could lead to integration fail. (#721)
    * [gym/common] Move 'sample' from 'spaces.py' to 'helpers.py'. (#721)
    * [gym/zoo] Fix 'acrobot' and 'cartpole' envs not using wrong integrator. (#719)
    * [misc] Do not verify metadata before pushing wheels on PyPi.
    * [misc] Fix easy install doc. (#721)
    * [misc] Fix support of virtual env ('venv', 'pyenv', ...) when building dep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
    [macros.h, runge_kutta_dopri_stepper.cc]
2024-02-21 Jiminy release 1.8.2 (#729)
    * [core] More conservative step adjustment for adaptive steppers. (#724)
    * [core] Add relaxation to PGS solver to mitigate convergence instabilities. (#726)
    * [core] Remove unnecessarily confusing 'System' hierarchy. (#728)
    * [core] Remove single-robot 'Engine' class. (#728)
    * [python/plot] Synchronise x-axes on all tabs by default. (#724)
    * [gym/common] Ease debugging of Gym environments. (#724)
    * [gym/common] Do not enforce 'dtMax'. (#727)
2024-03-07 Jiminy release 1.8.3 (#738)
    * [core] Make visual and collision models optional. (#730)
    * [core] Throw exception when trying to alter hardware or controller internals during simulation. (#730)
    * [core] Mark src-local functions as static. (#730)
    * [core] Add some missing bad control flow checks. (#730)
    * [core] Print warnings even for release build type. (#731)
    * [core] Fix broken 'getRigidVelocityFromFlexible'. (#732)
    * [core/python] 'Model' can now be instantiated from Python. (#730)
    * [core/python] Fix partially broken 'FunctionalController' bindings. (#730)
    * [core/python] Avoid visitor pattern when irrelevant. (#730)
    * [core/python] Expose more methods for 'Model'. (#731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
    [flexible_arm.urdf]
2024-04-19 Jiminy release 1.8.4 (#769)
    * [core] Fix bias/noise check for EncoderSensor. (#744)
    * [core] Fix some symbols not exported by mistake. (#742)
    * [core] Catch exception during stepper integration. (#747)
    * [core] Clarify terminology: 'Rigid' by 'Mechanical', 'Original' by 'Theoretical', 'Actual' by 'Extended'. (#753) (#762) (#763)
    * [core] More appropriate tolerance when checking GCD to avoid false positive. (#753)
    * [core] User is now systematically responsible for serializing constants before telemetry registration. (#753)
    * [core] Various cleanup and minor improvements. (#753)
    * [core] Add 'JIMINY' namespace to macros. (#755)
    * [core] Add methods to get / set all simulation options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
    [simple_pendulum.urdf]
2024-04-28 Jiminy release 1.8.5 (#777)
    * [core] Full support of serialization of 'Robot'. (#770) (#775)
    * [core] Do NOT use 'enable_shared_from_this' if not strictly necessary. (#775)
    * [core] Rename macro 'PRINT_WARNING' in 'JIMINY_WARNING' to avoid conflicts. (#775)
    * [python/simulator] 'plot' now support multi-robot simulations. (#770)
    * [gym/common] Speedup 'PDController' env pipeline block. (#770)
    * [gym/common] Speedup 'StackedJiminyEnv' wrapper. (#770)
    * [gym/common] More generic 'FilterObservation', 'StackedJiminyEnv' wrappers. (#770) (#776)
    * [gym/common] Improve 'render_mode' support.
    * [gym/zoo] Cleanup and speedup toy model environments. (#770)
    * [gym/rllib] Fix multi-GPU suppo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
    [abstract_motor.cc, abstract_sensor.cc]
2024-04-28 [core] Fix partially broken step adjustment optim that could lead to integration fail.
    [engine.cc, engine.h]
2024-04-29 [core] Fix inconsistent acceleration after updating discrete-time controller command. (#779)
    * [core] Fix inconsistent acceleration after updating discrete-time controller command.
    * [core] Log the acceleration both at the end and the beginning of a step if dynamics has changed.
    [double_pendulum.urdf]
2024-05-24 Jiminy release 1.8.6 (#802)
    * [core] Make 'jiminy::Model' and 'jiminy::Robot' copyable. (#791)
    * [core] Add stairs terrain (#797)
    * [core] Define position, velocity and effort limits at motor level. (#798)
    * [core] Implement velocity limits at motor-level. (#798)
    * [core] Allow direct access to all motors / sensors attached to a robot. (#798)
    * [core] Remove spring-damper position bounds dynamics to always use constraints. (#798)
    * [core] Remove damper velocity bounds dynamics. (#798)
    * [core] Define motor armature option at motor-side. (#798)
    * [core] Remove dedicated robot attributes for position, velocity and effort limits. (#798)
    * [core] Remove inefficient motor / sensor conven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
    [atlas.urdf, cartpole.urdf]
2024-06-18 [gym/common] Add more trajectory tracking rewards. (#803)
    * [core] Allow integer reduction ratio at motor level for unbounded revolute joints.
    * [python/viewer] Fix support of 'matplotlib>=3.9.0'.
    * [gym/common] Robust deletion of quantities in control flow.
    * [gym/common] Add state quantity init guard.
    * [gym/common] Add option to disable dynamic computation graph update.
    * [gym/common] Add unary operator quantity.
    * [gym/common] Add odometry pose quantity.
    * [gym/common] Add actuated joint tracking reward.
    * [gym/common] Add tracking base height reward.
    * [gym/common] Add cature point quantity and capture point tracking reward.
    * [gym/common] Fix reset of automatically refreshed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
    [abstract_motor.cc, basic_sensors.cc, generic.py, locomotion.py]
2024-06-18 [gym/common] Add support of multi-frame quantities. (#804)
    * [gym/common] Add support of multi-frame quantities.
    * [gym/common] Add mean quaternion quantity.
    * [gym/common] Add foot odometry pose quantity.
2024-06-18 [gym/common] Add relative foot poses quantity. (#805)
    * [gym/common] Add relative foot poses quantity.
    * [gym/common] Unify all frame orientation representations as one quantity.
2024-06-18 [gym/common] Add foot pose tracking reward. (#806)
    * [gym/common] Math utils no longer return values with out is specified.
    * [gym/common] Add foot pose tracking reward.
    [generic.py, locomotion.py, test_quantities.py, test_rewards.py]
2024-06-18 [gym/common] Add angular momentum, stability, and friction rewards. (#808)
    * [gym/common] Remove error-prone, confusing and slow '__getattr__' fallback in pipelines.
    * [gym/common] Add angular momentum minimisation reward.
    * [gym/common] Add projected support polygon zmp stability margin maximisation reward.
    * [gym/common] Add ground contact friction minimisation reward.
    * [misc] Fix segfault on windows due to vcruntime conflicts.
    [generic.py, locomotion.py, pipeline.py]
2024-06-18 [python|gym] Add contraint lambda multipliers to state and extracted trajectory. (#809)
    * [core] Add option to log constraint lambda multipliers.
    * [core] Replace constraint tree node terminolgy for registry for clarity.
    * [core] Enforce unique constraint name per registry not globally, then remove now irrelevant helpers.
    * [core] Make sure no constraint is added/removed if simulation is running.
    * [python|gym] Add contraint lambda multipliers to state and extracted trajectory.
    * [python/dynamics] Fix trajectory interpolation preferring t+ over t-.
    * [gym/common] Refresh state quantities only if needed.
    [constraints.cc, dynamics.py, engine.cc, engine.h, generic.py]
2024-07-17 Jiminy release 1.8.8 (#827)
    * [core] Fix robot serialization issue. (#821)
    * [core] Minor improvement periodic Perlin process and periodic stair ground. (#799)
    * [core] 'PeriodicGaussianProcess' and 'PeriodicFourierProcess' are now differentiable. (#799)
    * [core] Fix negative time support for all existing random processes. (#799)
    * [core] Add N-dimension Perlin processes. (#799) (#823)
    * [core] Add gradient computation for all Perlin processes. (#799) (#823) (#825)
    * [core] Make all Perlin processes faster and copy-able. (#799)
    * [core] Add Perlin ground generators. (#799)
    * [core] Replace MurmurHash3 by xxHash32 which is faster. (#824)
    * [core] Make gradient computation opti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
    [dynamics.py, engine.h, functors.cc]
2024-12-02 Jiminy release 1.8.9 (#843)
    * [core] Fix symbol visibility issues for some classes on windows. (#836)
    * [core] Fix bindings and serialization of convex geometry meshes. (#836)
    * [core] Fix 'array_copyto' helper. (#841)
    * [python/viewer] Fix 'add_camera'. (#831)
    * [python/viewer] Use firefox instead of chromium for offscreen rendering with meshcat to fix rendering on MacOS VM. (#832)
    * [python/viewer] Fix support of '-' in robot name. (#834)
    * [python/viewer] Fix conversion of 'hppfcl.Convex' to Panda3D. (#836)
    * [python/dynamics] Take into account stride offset when trajectory time is wrapping. (#838)
    * [python|gym_jiminy] More natural figure layout to improve readability. (#837)
    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
    [ant.urdf, linear_single_mass.urdf, linear_two_masses.urdf, wheel.urdf]
2024-12-02 [misc] Fix MacOS wheel upload.
2025-01-14 Jiminy release 1.8.10 (#861)
    * [core] Properly handle undefined motor velocity bounds. (#849)
    * [core] Rename 'positionLimit(Min|Max)' in 'positionLimit(Lower|Upper)' for consistency with Pinocchio. (#849)
    * [core] Move 'logInternalStepperSteps' from 'stepper' to 'telemetry' options for consistency. (#852)
    * [core] Fix rounding error when computing impulse force breakpoints. (#852)
    * [core] Fix wrong time 't' when computing derivative after successful integration. (#852)
    * [core] Fix joint jacobian not systematically updated when dealing with external forces. (#852)
    * [core] Fix impulse forces internal state not properly reset. (#853)
    * [core] Set extended pinocchio model velocity and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
    [abstract_runge_kutta_stepper.cc, abstract_stepper.cc, basic_motors.cc]
2025-01-20 Jiminy release 1.8.11 (#866)
    * [gym_jiminy/common] Fix hard-coded termination conditions not being recorded in 'info'. (#862)
    * [gym_jiminy/common] Fix 'log_path' not properly reset at setup. (#862)
    * [gym_jiminy/common] Fix 2D Euclidean space angle algebra for drift and shift termination conditions. (#865)
    * [gym_jiminy/common] Flatten info hierarchy for reward components. (#862)
    * [gym_jiminy/common] Do not store individual termination condition states in info. (#862)
    * [gym_jiminy/common] Use asymmetric sigmoid normalization for stability reward. (#862)
    * [gym_jiminy/common] Trajectory time mode is not specific to each trajectory in the dataset. (#863)
    * [gym_jiminy/common] Traject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
    [abstract_runge_kutta_stepper.cc, controllers.cc, dynamics.py, engine.h, generic.py]
2025-01-23 Jiminy release 1.8.11 (follow-up) (#869)
    * [core/python] Fix 'SensorMeasurementTree' not supporting instantiation from 'OrderedDict'. (#867)
    * [core|python] Ground profile now included in persistent log files and automatically loaded for replay. (#867)
    * [gym_jiminy/common] Move initial state sampling after reset all of the layers of the pipeline. (#867)
    * [gym_jiminy/common] Fix 'env.stop' not being called at the end of evaluation if keyboard-interrupted. (#867)
    * [gym_jiminy/common] Fix loaded pipeline config file cannot be instantiated more than once. (#867)
    * [gym_jiminy/common] Fix 'ScaleObservation' broken for slices. (#868)
    * [misc] Add support of Python 3.13. (#868)
    [engine.cc, generic.py, helpers.cc, log.py, pipeline.py]
2025-02-09 Jiminy release 1.8.12 (#884)
    * [python/dynamics] Fix trajectory interpolation mode 'clip'. (#873)
    * [python/dynamics] Fix bug making 'Trajectory.get' extremely inefficient. (#881)
    * [gym_jiminy/common] Fix 'MechanicalPowerConsumption' not exposed. (#870)
    * [gym_jiminy/common] Add support of 'horizon=None' to MechanicalPowerConsumptionTermination. (#870)
    * [gym_jiminy/common] Various bug fixes in 'play_interactive'. (#871)
    * [gym_jiminy/common] Fix quantity caching issues. (#873)
    * [gym_jiminy/common] Fix mechanical power termination condition. (#873)
    * [gym_jiminy/common] Fix 'BaseRelativeHeight' quantity ignoring mode. (#873)
    * [gym_jiminy/common] Remove 'post_fn' argument from dr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
    [deformation_estimator.py, dynamics.py, generic.py, locomotion.py]
2025-02-17 [gym_jiminy/common] Add termination condition for contact slippage.
    [locomotion.py]
