duburcqa/jiminy/(notices)

Notices in the files:
data/quadrupedal_robots/anymal/anymal.urdf:
Copyright 2020 ANYbotics, https://www.anybotics.com
README.md:
License: MIT
